kolod/padauk-programmer/software/firmware/platform/stm32f072/README.md

# Платформа STM32F072 (плати Easy PDK)

Ціль налагодження: прошивка для плат Easy PDK programmer на STM32F072C8T6. Розводку взято з
`easy-pdk-programmer-software/Firmware` (лише як референс). Рушій мікросхем тут — заглушка
(`platform/common/chip_engine_stub.c`): усі операції з мікросхемою відповідають `OP_UNSUPPORTED`.

## Піни

| Пін | Функція | Призначення | Примітка |
|---|---|---|---|
| PA4 | DAC_OUT1 | опорна напруга регулятора VPP | 0…4095 → 0…13,27 В |
| PA5 | DAC_OUT2 | опорна напруга регулятора VDD | 0…4095 → 0…6,26 В |
| PA2 | GPIO, вихід | увімкнення підвищувального перетворювача 15 В (для VPP) | 1 = увімкнено |
| PA3 | TIM15_CH2 (AF0) | ШІМ ≈ 45 кГц, 50 % → накачка −4,8 В для ОП | |
| PB0 | ADC_IN8 | вимір VPP через дільник /6 | плата Easy PDK / Lite |
| PB1 | ADC_IN9 | вимір VDD через дільник /6 | плата Easy PDK / Lite |
| PA0 | ADC_IN0 | вимір VPP через дільник /6 | лише варіант mini pill |
| PA1 | ADC_IN1 | вимір VDD через дільник /6 | лише варіант mini pill |
| PB8 | GPIO, вхід з підтяжкою | визначення варіанта плати | на землі → Lite |
| PB9 | GPIO, вхід з підтяжкою | визначення варіанта плати | на землі → mini pill |
| PB3 | — | лінія мікросхеми PA3 / CLK | поки лише Hi-Z |
| PB4 | — | лінія мікросхеми PA4 | поки лише Hi-Z |
| PB5 | — | лінія мікросхеми PA6 / DAT | поки лише Hi-Z |
| PB6 | — | лінія мікросхеми PA0 (UART TX мікросхеми) | поки лише Hi-Z |
| PB7 | — | лінія мікросхеми PA7 (UART RX мікросхеми) | поки лише Hi-Z |
| PC13 | GPIO, вихід | LED1 | активний нуль |
| PC14 | GPIO, вихід | LED2 | активний нуль |
| PC15 | GPIO, вихід | LED3 | активний нуль |
| PA15 | GPIO, вхід з підтяжкою до землі | кнопка → локальний запис (`PROGRAM`) | натиснута = 1 |
| PA11 / PA12 | USB DM / DP | USB CDC, VID/PID `1209:0001` | |
| PA13 / PA14 | SWDIO / SWCLK | налагодження | |
| PF0 / PF1 | OSC_IN / OSC_OUT | кварц 8 МГц | без кварцу — HSI |

Внутрішні ресурси: VREFINT (ADC_IN17) для обчислення VDDA, датчик температури (ADC_IN16) і VREFINT —
джерело ентропії, CRC — апаратний блок, TIM2 — мікросекундний таймер, SysTick — мілісекунди.

Після скидання першим кроком (`Reset_Handler`, ще до ініціалізації RAM) ЦАП виставляється в 0 В,
а лінії мікросхеми PB3…PB7 стають входами.

## Індикація

| Стан | LED1 | LED2 | LED3 |
|---|---|---|---|
| готовий (`READY`) | ● | | |
| операція (`BUSY`) | | ● | |
| успіх (`SUCCESS`) | ● | ● | |
| помилка (`FAIL`) | | | ● |
| локальний запуск заблоковано (`BLOCKED`) | ● | | ● |

Тимчасове відображення; остаточна індикація — задача T102.

## Тактування

SYSCLK 48 МГц: HSE 8 МГц × 6 (або HSI / 2 × 12, якщо кварц не запустився). USB — від HSI48 з
підстроюванням CRS за кадрами SOF. АЦП — від HSI14.

## Пам'ять

| Адреса | Розмір | Вміст |
|---|---|---|
| `0x08000000` | 44 КБ | прошивка |
| `0x0800B000` | 8 КБ | слот пакета 0 |
| `0x0800D000` | 8 КБ | слот пакета 1 |
| `0x0800F000` | 2 КБ | журнал стану, сторінка A |
| `0x0800F800` | 2 КБ | журнал стану, сторінка B |

Сторінка flash — 2 КБ, запис півсловами (одиниця запису 2 байти). Стирання синхронне: воно
виконується у фоні між командами, але на час стирання сторінки (≈ 20–40 мс) процесор зупиняється.

## Збірка

```
cmake -B build/f072 -G Ninja -DPLATFORM=stm32f072 \
      -DCMAKE_TOOLCHAIN_FILE=<абсолютний шлях>/software/firmware/cmake/arm-none-eabi.cmake software/firmware
cmake --build build/f072
```

Результат — `build/f072/pdkprog.elf` і `pdkprog.bin`.
