kolod/padauk-programmer/specs/001-pc-programmer-protocol/contracts/chip-engine.md

# Contract: внутрішні інтерфейси ядро ⇄ рушій мікросхем ⇄ живлення

Внутрішній (не мережевий) контракт між платформонезалежним ядром прошивки, рушієм мікросхем
(реалізація для PADAUK — фіча `002-chip-engine`; у цій фічі — модель для симулятора й заглушка для F072)
і апаратною частиною живлення. Фіксує гарантії принципу III конституції й FR-040.

## 1. `hal_power.h` — апаратне живлення (реалізує платформа)

| Функція | Опис |
|---|---|
| `power_set(rail, mV)` | задати VDD або VPP; `0` — вимкнути з активним розрядом |
| `power_measure(rail) → mV` | виміряна напруга шини (усереднення — відповідальність платформи) |
| `power_off_all()` | негайно VDD = VPP = 0, розряд увімкнено; безпечна з будь-якого контексту, включно з обробником помилки |
| `power_limits() → {vdd_max_mV, vpp_max_mV}` | апаратні межі джерел |

Платформа MUST мати апаратне обмеження максимальної напруги, незалежне від прошивки (конституція, III).

## 2. `core/power` — політика встановлення (реалізує ядро)

`power_apply(rail, mV, min_pause_us) → OK | VDD_FAULT | VPP_FAULT` — правило з
[protocol.md §6.1](protocol.md): мінімальна пауза **і** 3 послідовні виміри в межах ±2 % / ±30 мВ, тайм-аут
20 мс; при невдачі сам викликає `power_off_all()` і заповнює `{rail, set_mV, meas_mV}` для `RESULT`.

Рушій MUST змінювати напруги **лише** через `power_apply` (ніколи напряму через `hal_power`).

## 3. `chip_engine.h` — рушій мікросхем

| Примітив | Опис |
|---|---|
| `probe(&id, &family)` | визначення мікросхеми на низьких напругах (VPP 4.5 В, VDD 2.0 В) |
| `read(chip, addr, count, sink)` | читання слів у приймач (слот flash / суми / порівняння) |
| `erase(chip)` | стирання FLASH |
| `blank_check(chip, range, excl)` | перевірка чистоти |
| `write_block(chip, addr, words)` | запис одного блоку (розмір блоку — з таблиці) |
| `calibrate(chip, site, target_hz, mV) → {value, measured_hz}` | калібрування з вимірювальним циклом; перевіряє, що активна саме ця вставка (FR-055) → інакше `CALIB_WRONG_SITE` |
| `measure_freq(chip, site, start_value, mV) → hz` | вимір частоти без імпульсів на PA4 (R9, `MEASURE_MASTER`) |
| `run_start(vdd_mV)` / `run_stop()` | режим виконання з UART-мостом |
| `safe_state()` | VDD = VPP = 0 через `power_off_all()`, лінії IC — Hi-Z |

Гарантії (перевіряються модульними тестами на фейковому `hal_power` і моделлю мікросхеми):

1. **ID до HV**: будь-який примітив, що подає напруги запису/стирання, спершу перевіряє ID мікросхеми
   (FR-020); невідповідність → `CHIP_ID_MISMATCH` без подачі HV.
2. **Напруги підтверджено**: жоден біт не передається мікросхемі, поки остання зміна напруги не пройшла
   `power_apply` (FR-040, SC-011).
3. **Безпечний вихід**: кожен примітив на будь-якому шляху виходу (успіх, помилка, скасування через
   `poll`) лишає мікросхему в `safe_state()`, якщо наступний крок операції явно не продовжує сесію.
4. **Атомарні кроки < 100 мс**: між викликами `poll()` минає не більше 100 мс (найдовший крок —
   імпульс стирання FLASH_2, 40 мс; встановлення напруги — до 20 мс), щоб виконувалась FR-024.
5. **Скасування**: `poll()` повертає «скасувати» → примітив завершується з `CANCELLED` після
   `safe_state()`; виняток — етапи `MEASURE`/`RESTORE` операції `COPY` (data-model `CopyJob`).
6. **Та сама вставка** (FR-055, `docs/padauk-calibration.md` §8): `calibrate` до першого імпульсу «+1»
   міряє частоту й порівнює з очікуваною для типу вставки (`target_hz / 7` на PA3; допуск 1/4…4); під час
   підбору стежить, що частота монотонно змінюється з кроком; для BG перевіряє, що PA0 ведеться
   мікросхемою (перемикаючи слабку підтяжку вгору/вниз, рівень не має за нею йти). Порушення →
   `CALIB_WRONG_SITE` без жодного імпульсу далі й без запису.

## 4. Платформа органів керування (локальний запуск)

Ядро отримує від платформи лише події `local_start(request)` і `local_cancel()` і повідомляє стан
індикації `ui_state(state, detail)`; відображення на кнопки, перемикачі, дисплей і сигнали конвеєра —
окрема фіча (research R16). Набір фіксований (FR-054):

| `request` | Операція | Примітка |
|---|---|---|
| `PROGRAM` | `PROGRAM` активного пакета | пріоритети R16 можуть замінити на `SELF_TEST` / `RESTORE_MASTER` |
| `COPY` | `COPY` з режимами `cfg_copy_*` | те саме |
| `VERIFY` | `VERIFY` підключеної мікросхеми проти активного пакета | |
| `SELF_TEST` | `SELF_TEST` | явний запит оператора |
| `RESTORE_MASTER` | `RESTORE_MASTER` | лише при `MASTER_RESTORE_PENDING`, інакше ігнорується |
| `local_cancel()` | `OP_CANCEL` поточної локальної операції | як з PC; для `COPY` у `MEASURE` — спершу відновлення |

`ui_state.state`: `READY`, `BUSY` (`detail` = етап і відсоток), `SUCCESS`, `FAIL` (`detail` = клас:
`STORAGE`, `NO_PACKAGE`, `CHIP`, `CALIB`, `POWER_SELFTEST`, `MASTER_PENDING` + код статусу), `BLOCKED`
(локальний запис замінюється самоперевіркою). Еталонна плата F072 у цій фічі: одна кнопка →
`local_start(PROGRAM)`, три LED — спрощене відображення станів.
