kolod/padauk-programmer/hardware/README.md

# Апаратна частина

Схема й плата аналогової частини програматора для WeAct STM32G474CoreBoard (DipTrace):
`stm32g474-board.dchxml` — схема, `stm32g474-board.dipxml` — плата. Призначення пінів МК, шини
+15 В / −2,5 В і роз'єм ICP описано в `software/firmware/platform/stm32g474/README.md`.

## Конденсатори

| Поз. | Номінал | Корпус | Мережа | Робоча напруга | Номінальна напруга | Діелектрик | Примітка |
|---|---|---|---|---|---|---|---|
| C1 | 100 нФ | 0805 | +15 В ↔ −2,5 В (блокування U1) | до 18,5 В | 50 В | X7R | Стоїть між двома шинами, а не на землю; 25 В — мінімум. Впритул до виводів 8 і 4 U1 |
| C2 | 2 × 4,7 мкФ | 0805 | +15 В, вихід бустера | 15 В (до ~17 В під D3) | 50 В (мін. 35 В) | X7R | Під 15 В кожен зберігає ~1,5–2 мкФ, разом ~3–4 мкФ — досить для навантаження в десятки мА (пульсація ≈ 40 мА · 0,67 / (200 кГц · 3 мкФ) ≈ 45 мВ; при іншій частоті ШІМ — перерахувати). Конденсатори на 16–25 В не годяться. Малий ESR: імпульсний струм діода D1; коротка петля D1 → C2 → витік Q1 |
| C11 | 2 × 4,7 мкФ | 0805 | +5 В, вхід дроселя L1 | 5 В | 50 В (досить 16 В) | X7R | 50 В — щоб була одна позиція з C2 і C5. Пульсуючий струм дроселя; біля L1, коротка петля до витоку Q1 |
| C3 | 1 мкФ | 0805 | PB4 → D2, «літаючий» конденсатор накачки −2,5 В | ≤ 3,3 В | 16 В | X7R | Низький ESR |
| C5 | 4,7 мкФ | 0805 | −2,5 В, накопичувальний | ~2,7 В | 50 В (досить 10 В) | X7R | Неполярний — від'ємна шина не має значення |
| C4 | 100 нФ | 0805 | −2,5 В, ВЧ-блокування | ~2,7 В | 16–50 В | X7R | Біля виводу 4 U1 |
| C6 | 100 нФ | 0805 | ADC_Vdd (PA0), фільтр дільника | ≤ 1,1 В | 16–50 В | X7R | τ = (100k ∥ 20k) · 100 нФ ≈ 1,7 мс |
| C7 | 100 нФ | 0805 | ADC_Vpp (PA1), фільтр дільника | ≤ 2,3 В | 16–50 В | X7R | τ ≈ 1,7 мс |
| C8 | 1 нФ | 0805 | COMP_OVP (PB1), дільник OVP | ≤ 1,2 В | 50 В | C0G/NP0 | τ = (130k ∥ 10k) · 1 нФ ≈ 9 мкс — фільтрує завади, не гальмує OVP |
| C9 | 10 нФ | 0805 | DAC_Vdd (PA5) → вхід U1 | ≤ 3,3 В | 50 В | C0G/NP0 | Див. «Виходи ЦАП» |
| C10 | 10 нФ | 0805 | DAC_Vpp (PA4) → вхід U1 | ≤ 3,3 В | 50 В | C0G/NP0 | Див. «Виходи ЦАП» |

### Зведення для закупівлі

Ті самі конденсатори, згруповані по номіналах. Напругу підвищено там, де це прибирає зайву
номенклатуру (C4/C6/C7 — 50 В як C1; C5, C11 — 50 В як C2), а C2 і C11 зібрано з двох 4,7 мкФ 0805
замість 10 мкФ 1206: 5 позицій на 13 конденсаторів. На схемі C2 і C11 треба розділити на два
конденсатори кожен (додати дві нові позиції).

| Номінал | Корпус | Напруга | Діелектрик | Кількість | Позиції |
|---|---|---|---|---|---|
| 1 нФ | 0805 | 50 В | C0G/NP0 | 1 | C8 |
| 10 нФ | 0805 | 50 В | C0G/NP0 | 2 | C9, C10 |
| 100 нФ | 0805 | 50 В | X7R | 4 | C1, C4, C6, C7 |
| 1 мкФ | 0805 | 25 В | X7R | 1 | C3 |
| 4,7 мкФ | 0805 | 50 В | X7R | 5 | C2 (2 шт), C11 (2 шт), C5 |

Приклад для 4,7 мкФ: CERCAP 4.7/50V 0805 KX7R (X7R, ±10 %).

Загальне правило: 0805 X7R, малі ємності (1–10 нФ) — C0G; номінальна напруга кераміки — не
менше ніж удвічі вища за робочу (для C1, C2 — 50 В), бо ємність X7R/X5R падає під постійною
напругою.

C8, C9 і C10 стоять у колах опорної напруги й порогу, тому C0G: ємність не залежить від напруги й
температури, немає п'єзоефекту й діелектричної абсорбції. У номіналах 1–10 нФ 0805 / 50 В C0G
коштує як X7R. Для C6, C7 тип некритичний: напруга постійна, точність задає калібрування.

### Виходи ЦАП

ЦАП працює без буфера, його вихідний опір ≈ 15 кОм:

- з C9/C10 10 нФ τ ≈ 150 мкс, встановлення до 0,1 % — ≈ 1 мс; після зміни коду ЦАП прошивка має
  чекати ~1–2 мс перед виміром;
- R1/R6 (240k на землю) разом із 15 кОм ЦАП утворюють дільник (≈ −6 % напруги) — цю похибку
  прибирає калібрування живлення.

### Виходи Vdd / Vpp

На виходах після R17/R18 конденсаторів немає. За потреби можна поставити до 100 нФ X7R / 50 В на
J1.1 і J1.5 біля роз'єму: R17/R18 (20 Ом) розв'язують ємність від виходу ОП, тож генерації не буде.
Плата за це — фронт VPP τ = 20 Ом · 100 нФ = 2 мкс і більший кидок струму при ввімкненні; більше
~100 нФ не ставити.
