kolod/padauk-programmer/docs/README.md

# Документація

| Файл | Опис |
|---|---|
| [easy-pdk-programmer-protocol.md](easy-pdk-programmer-protocol.md) | Аналіз протоколів Easy PDK Programmer: PC ⇄ програматор ⇄ мікросхема |

## Даташити PADAUK

Даташити є власністю PADAUK Technology і в репозиторій не додаються (`docs/*.pdf` у `.gitignore`).
Завантажте їх із сайту виробника <http://www.padauk.com.tw/en/> і покладіть у цей каталог:

- `PFS154 datasheet_EN_V107_20240912.pdf`
- `PFC154 datasheet_EN_V004_20240905.pdf`
- `PADAUK_Package Information_V015.pdf`
