kolod/padauk-programmer/software/firmware/platform/stm32g474/README.md

# Платформа STM32G474 (WeAct STM32G474 core board)

Прошивка для плати [WeAct Studio STM32G474 core board](https://github.com/WeActStudio/WeActStudio.STM32G474CoreBoard)
з STM32G474CEU6 (512 КБ flash, 128 КБ RAM), без зовнішньої flash. Розводку плати взято з прикладів
WeAct. Рушій мікросхем тут — заглушка (`platform/common/chip_engine_stub.c`): усі операції з
мікросхемою відповідають `OP_UNSUPPORTED`.

Аналогової частини VDD/VPP ще немає. Тому драйвер живлення вмикається лише опцією збірки
`-DPDK_G474_SUPPLIES=ON` (типово `OFF`). Без неї програматор повідомляє межі напруг 0 В, не виставляє
`MEASURE_POWER` в `INFO`, і будь-яка ненульова напруга завершується `VDD_FAULT`/`VPP_FAULT`.

## Піни

| Пін | Функція | Призначення | Примітка |
|---|---|---|---|
| PA4 | DAC1_OUT1 | опорна напруга регулятора VPP | лише з `PDK_G474_SUPPLIES`; 0…4095 → 0…13,27 В |
| PA5 | DAC1_OUT2 | опорна напруга регулятора VDD | лише з `PDK_G474_SUPPLIES`; 0…4095 → 0…6,26 В |
| PA0 | ADC1_IN1 | вимір VDD через дільник /6 | лише з `PDK_G474_SUPPLIES` |
| PA1 | ADC1_IN2 | вимір VPP через дільник /6 | лише з `PDK_G474_SUPPLIES` |
| PA8 | TIM1_CH1 (AF6) | затвор ключа підвищувального перетворювача +15 В | лише з `PDK_G474_SUPPLIES`; 400 кГц, ≤ 75 % |
| PB0 | COMP4_INP0 | +15 В через дільник /6 — регулювання | лише з `PDK_G474_SUPPLIES` |
| PB1 | COMP1_INP1 | +15 В через окремий дільник /14 — захист від перенапруги | лише з `PDK_G474_SUPPLIES` |
| PB4 | TIM16_CH1 (AF1) | ШІМ 100 кГц, 50 % → діодна накачка −2,5 В | лише з `PDK_G474_SUPPLIES`; низька швидкість виходу |
| PC6 | GPIO, вихід | LED | активна одиниця |
| PC13 | GPIO, вхід з підтяжкою до землі | кнопка KEY → локальний запис (`PROGRAM`) | натиснута = 1 |
| PA11 / PA12 | USB DM / DP | USB CDC, VID/PID `1209:0001` | |
| PA13 / PA14 | SWDIO / SWCLK | налагодження | |
| PF0 / PF1 | OSC_IN / OSC_OUT | кварц 8 МГц | без кварцу — HSI16 |
| PB6 | — | вільний | прошивка знімає з PB4/PB6 підтяжки UCPD dead battery |

Піни живлення умовні: їх треба підтвердити або змінити, коли буде схема аналогової частини.
Масштаби (повна шкала ЦАП 6,26 В / 13,27 В після регуляторів, дільники /6) взято як на Easy PDK.
Лінії до мікросхеми PADAUK ще не призначено.

## Шини +15 В і −2,5 В

Шини для вихідного каскаду (ОП, що формує VDD і VPP) робляться без спеціалізованих мікросхем.

**+15 В — підвищувальний перетворювач від USB 5 В.** Ключ (N-MOSFET із логічним рівнем затвора,
наприклад AO3400 або SI2302), дросель 33–47 мкГн із струмом насичення ≥ 0,5 А, діод Шотткі (SS14),
конденсатор 10–22 мкФ / 25 В. Розрахунковий струм — до ~25 мА (VDD мікросхеми під час запису до
20 мА, VPP, дільники, ОП), закладено 30–50 мА.

- Регулювання апаратне, гістерезисне: COMP4 порівнює вихід (PB0, /6) з порогом від внутрішнього
  DAC3_CH2 і, поки вихід вищий, гасить імпульси TIM1_CH1 через OCREF_CLR. Прошивка лише задає поріг
  (плавний пуск за 20 мс) і перевіряє, що шина піднялась за 50 мс.
- Захист від перенапруги: COMP1 порівнює окремий дільник (PB1, /14, наприклад 130 кОм / 10 кОм) з
  VREFINT (1,21 В) — поріг ≈ 17 В. Спрацювання вимикає ШІМ через аварійний вхід TIM1 апаратно,
  без участі програми, і ШІМ не вмикається до скидання. Конфігурацію COMP1 заблоковано бітом LOCK.
- Якщо шина не піднялась або спрацював захист, драйвер тримає ЦАП VDD/VPP на 0 В, а `INFO` не
  виставляє `MEASURE_POWER`.
- Обов'язково на платі: резистор 10 кОм із затвора на землю (ключ закритий після скидання й поки
  PA8 у Hi-Z) і стабілітрон або TVS на 16–18 В на шині +15 В (пасивне обмеження, якщо зупиниться
  весь МК або обірветься дільник).

**Коло затвора.** Між PA8 і затвором — послідовний резистор 22–47 Ом (наприклад, 33 Ом), фізично біля
ключа. Він гасить дзвін, який ємність затвора (~0,6–1 нФ у AO3400) утворює з індуктивністю доріжки,
зрізає короткий пік струму піна при перезаряді затвора і зменшує завади, зокрема на АЦП. Перемикання
при цьому триває ~30–50 нс; при 400 кГц (період 2,5 мкс) втрати на перемикання ≈ 0,05–0,1 Вт при
струмі дроселя ~0,3 А. Прошивка виставляє PA8 середню швидкість виходу (medium), тож фронти задає
саме цей резистор, а не пін. Якщо ключ гріється, частоту можна знизити до 200–300 кГц (`BOOST_PWM_HZ` у
`hal_g474_power.c`), але тоді потрібен дросель більшої індуктивності.

Резистор 10 кОм на землю ставиться безпосередньо між затвором і витоком ключа, тобто після
послідовного резистора: тоді ключ закритий навіть при обриві послідовного резистора.

```
PA8 ──[33 Ом]──┬── затвор ключа
               │
            [10 кОм]
               │
GND ───────────┴── витік ключа
```

**−2,5 В — діодна накачка.** ШІМ із PB4 через конденсатор і два діоди Шотткі (BAT54S або RB521),
конденсатори 1–10 мкФ. Напруга ≈ −(3,3 В − 2·Uпр), струм кілька міліампер — досить для власного
споживання ОП (~1 мА) і коротких імпульсів розряду виходу.

Пін накачки винесено на протилежний від аналогових пінів бік корпусу. У UFQFPN48 PA0…PB2 (піни 8–19),
VREF+ і VDDA (20, 21) стоять поруч: ШІМ на будь-якому з них (наприклад, PA6 — пін 14, сусід PA5 з
опорою VDD) потрапляв би через ємність між пінами й доріжками на опори VDD/VPP (а вихідний каскад
ще й підсилює їх), на входи компараторів +15 В і на VDDA. PB4 — пін 42; низька швидкість виходу
додатково згладжує фронти. На платі варто також поставити RC-фільтри на виходах ЦАП перед ОП,
окремий фільтр (ферит або LC) на VDDA і вести доріжки накачки й підвищувального перетворювача
подалі від аналогових, з окремим поверненням на землю.

Після скидання (і в обробнику збою) прошивка першим кроком переводить PA8 у низький рівень, зупиняє
TIM1 і ставить ЦАП VDD/VPP на 0 В.

Внутрішні ресурси: VREFINT (ADC1_IN18, калібрування при VDDA = 3,0 В) для обчислення VDDA,
апаратний генератор випадкових чисел — джерело серійних номерів, CRC — апаратний блок, TIM2 —
мікросекундний таймер, SysTick — мілісекунди.

## Індикація

Один LED, стан показується режимом блимання:

| Стан | LED |
|---|---|
| готовий (`READY`) | світиться постійно |
| операція (`BUSY`) | 4 Гц |
| успіх (`SUCCESS`) | 1 Гц |
| помилка (`FAIL`) | 10 Гц |
| локальний запуск заблоковано (`BLOCKED`) | не світиться |

Тимчасове відображення; остаточна індикація — задача T102.

## Тактування

SYSCLK 170 МГц (діапазон 1, режим boost): HSE 8 МГц / 2 × 85 / 2 (або HSI16 / 4 × 85 / 2, якщо кварц не
запустився). APB1 і APB2 — 170 МГц. USB і RNG — від HSI48 з підстроюванням CRS за кадрами SOF.
АЦП — HCLK / 4.

## Пам'ять

| Адреса | Розмір | Вміст |
|---|---|---|
| `0x08000000` | 256 КБ (банк 1) | прошивка |
| `0x08040000` | 4 × 16 КБ | слоти пакетів 0…3 (банк 2) |
| `0x08050000` | 1 сторінка | журнал стану, сторінка A |
| `0x08051000` | 1 сторінка | журнал стану, сторінка B |

Прошивка виконується з банку 1, а пакети й журнал лежать у банку 2. Тому стирання банку 2 не
зупиняє процесор, і фонове стирання справді асинхронне. Це працює в режимі двох банків
(`DBANK = 1`, заводське налаштування), сторінка 2 КБ; з `DBANK = 0` прошивка працює зі сторінками
4 КБ, але стирання зупиняє процесор.

Запис — подвійними словами по 8 байт, кожне пишеться один раз (ECC). Подвійна помилка ECC у слові,
недописаному через обрив живлення, викликає NMI: обробник скидає прапорець, а такий пакет відкидає
перевірка CRC.

## Збірка

```
cmake -B build/g474 -G Ninja -DPLATFORM=stm32g474 [-DPDK_G474_SUPPLIES=ON] \
      -DCMAKE_TOOLCHAIN_FILE=<абсолютний шлях>/software/firmware/cmake/arm-cortex-m4f.cmake software/firmware
cmake --build build/g474
```

Результат — `build/g474/pdkprog-g474.elf` і `pdkprog-g474.bin`.
