kolod/padauk-programmer/specs/001-pc-programmer-protocol/spec.md

# Feature Specification: Протокол обміну PC ⇄ програматор

**Feature Branch**: `001-pc-programmer-protocol`

**Created**: 2026-10-09

**Status**: Draft

**Input**: User description: "Протокол обміну PC ⇄ програматор (USB CDC). Треба визначити: які дані
передаються з PC на програматор (тип/ідентифікатор МК, образ прошивки, fuse, параметри калібрування,
серійний номер, опції операцій тощо), протокол обміну (команди, кадри), як програматор відповідає
(результати, коди помилок, прогрес довгих операцій) з урахуванням того, що всі знання про алгоритм
роботи з конкретним чипом тепер знаходяться у програматорі, а клієнт на PC тонкий. Дані повинні
передаватися без помилок: потрібен контроль цілісності кадрів, а також окремо — контроль цілісності
образу прошивки та метаданих (від PC до збереження у пам'яті програматора і при автономному записі)."

## Clarifications

### Session 2026-10-09

- Q: Скільки пакетів прошивки програматор зберігає одночасно? → A: Один активний пакет; друге місце
  лише для атомарної заміни (FR-016).
- Q: Чи підтримувати оригінальний протокол Easy PDK 1.3 для `easypdkprog`? → A: Ні. Можливий окремий
  CLI-клієнт, що імітує `easypdkprog`, але працює через новий протокол (FR-030).
- Q: Чи можна при копіюванні відновити індивідуальне калібрування копій, якщо ціль еталона невідома?
  → A: Так. Сліди калібрування в дампі замінюються калібрувальними вставками; ціль — виміряти на
  FLASH-еталоні (тимчасово перезаписавши його й потім відновивши), задати з PC, округлити до
  стандартної частоти або явно перенести значення еталона. BandGap відновлюється завжди (FR-031…FR-036).
- Q: Чи дозволяти запис OTP без перевірки чистоти (`--noblankchk`)? → A: Ні (принцип III). Для
  дописування окремих нулів у вже записану мікросхему — окрема операція дописування з перевіркою,
  що всі зміни лише обнуляють біти (FR-037, FR-038).
- Q: Як не дописати не ту мікросхему? → A: Дописування обов'язково перевіряє контрольну суму всієї
  користувацької пам'яті (точну або нормалізовану без калібрувань і серійних номерів) проти очікуваної:
  заданої клієнтом або обчисленої з активного пакета (FR-039).
- Q: Чи можна пропускати окремі калібрування й як поводитися з OTP? → A: Режими копіювання — окремо для
  IHRC/ILRC/BG (FR-042); при невдалому калібруванні нічого не записувати далі, сигнал
  неуспіху, з PC — опційне примусове завершення (FR-043); перекалібрування завершеної OTP не
  підтримується (FR-045).
- Q: Чи потрібні прапорці пропуску калібрування? → A: Ні. Калібрується кожна вставка, знайдена в
  прошивці; не потрібне калібрування — не ставити макрос. Для OTP кожне калібрування — це один повний
  запис (з вимірювальним циклом на місці вставки) і один перезапис самої вставки (FR-006).
- Q: Як поводитися з обривами? → A: Обрив USB не перериває операцію (дані завантажені до старту),
  крім запуску з обміном даними (FR-023); після обриву живлення — повторна спроба, якщо записане
  сумісне з образом (FR-044).
- Q: Що робити, якщо в еталоні замість сліду калібрування — вимірювальний цикл? → A: Локально — не
  копіювати, у сховище нічого не писати, сигнал неуспіху; з PC — запит користувачу: скасувати або задати
  ціль калібрування й повторити копіювання з дозволом (FR-051).
- Q: Як перевіряти мікросхему з каліброваними вставками й серійним номером? → A: Верифікація враховує
  вставки (FR-047); після калібрування й fuse — фінальна точна перевірка всієї пам'яті (FR-048); CRC пакета
  перевіряється й під час запису та перед fuse (FR-049); пакет без калібрувальних вставок дає попередження
  (FR-050).
- Q: Повторна спроба — у тій самій сесії? → A: Ні: пізніше або іншим програматором з тим самим пакетом.
  FLASH/MTP — запис наново; OTP — перевірка, чи можна дописати нулі; уже записаний серійний номер
  береться з мікросхеми (FR-044).
- Q: Як формувати серійні номери? → A: Випадкове 64-бітне число для всіх режимів (FR-046). Копіювання
  серійний номер не обробляє: локально — дублікат, з PC — пошук і заміна на користувачі (FR-052).
- Q: Калібрування чужого формату в еталоні? → A: Копіювати як є з попередженням (FR-053).
- Q: Як чекати встановлення VDD/VPP після зміни? → A: Не менше документованої паузи free-pdk **і** доки
  виміряна напруга в допуску й стабільна; тайм-аут → помилка напруги живлення/програмування (FR-040).
- Q: Допуск і тайм-аут встановлення напруги? → A: ±2 % або ±30 мВ (більше з двох), тайм-аут 20 мс (FR-040, SC-011).
- Q: Що робити, якщо під час самоперевірки в панельці мікросхема? → A: Спершу визначення мікросхеми на
  низьких напругах; якщо відповіла — відмова з окремим кодом; клієнт додатково просить підтвердити
  порожню панельку (FR-041).
- Q: Коли запускається самоперевірка? → A: Автоматично при кожному увімкненні та за командою з PC;
  при невдачі автономний запис блокується (FR-041).
- Q: Що, якщо при увімкненні мікросхема вже підключена? → A: Блокувати автономний запис, доки
  самоперевірка не пройде; локальний запуск у цьому стані повторює самоперевірку. Типовий сценарій — програмування
  в схемі через pogo-контакти: програматор увімкнено й перевірено, потім оператор або автомат на
  конвеєрі притискає його до плати й запускає запис (FR-041).
- Q: Які органи керування має автономний режим? → A: Поки не визначено; кількість кнопок і перемикачів
  не обмежується оригіналом. Протокол MUST NOT залежати від конкретних органів керування: автономні дії
  описуються як «локальний запуск» певної операції (`source` = локальний), а відображення дій на кнопки,
  перемикачі чи сигнали конвеєра визначається окремою фічею.
- Q: Що з локальних функцій реалізується зараз, якщо інтерфейс визначиться пізніше? → A: Ядро реалізує
  повний набір локальних дій і станів індикації (FR-054); будь-який майбутній інтерфейс лише відображає
  їх на свої органи керування. На еталонній платі тимчасово — одна кнопка → запис.

## User Scenarios & Testing *(mandatory)*

### User Story 1 - Завантаження пакета прошивки в програматор (Priority: P1)

Розробник вибирає у клієнті на PC файл прошивки, тип мікросхеми, fuse та опції і завантажує все це
в програматор одним «пакетом прошивки». Програматор перевіряє, що пакет дійшов без пошкоджень і
сумісний із вибраною мікросхемою, зберігає його в енергонезалежній пам'яті й підтверджує
збереження. Клієнт порівнює підтверджену програматором контрольну суму зі своєю і показує
користувачу, що в програматорі саме той образ, який він обрав.

**Why this priority**: без надійно завантаженого пакета неможливі ані запис із PC, ані автономна
робота — це фундамент усіх інших сценаріїв.

**Independent Test**: завантажити пакет, від'єднати програматор, підключити знову, прочитати
метадані й контрольну суму збереженого пакета — вони мають збігтися з тими, що обчислив клієнт.

**Acceptance Scenarios**:

1. **Given** програматор підключений і в ньому немає пакета, **When** клієнт завантажує коректний
   пакет для PFS154, **Then** програматор зберігає його і повертає підтвердження з контрольною
   сумою, що збігається з обчисленою клієнтом.
2. **Given** під час передачі частина даних пошкоджена, **When** програматор отримує пошкоджений
   фрагмент, **Then** він відхиляє цей фрагмент, клієнт передає його повторно, і зрештою пакет
   зберігається без помилок.
3. **Given** пакет призначений для мікросхеми, яку програматор не підтримує, або образ більший за
   пам'ять мікросхеми, **When** клієнт завершує передачу, **Then** програматор відхиляє пакет із
   конкретним кодом помилки, а раніше збережений пакет лишається незмінним.
4. **Given** зв'язок обірвався посеред передачі нового пакета, **When** програматор знову
   підключено, **Then** у пам'яті лишився попередній цілісний пакет (або порожньо, якщо його не
   було), а не частково записаний новий.

---

### User Story 2 - Запис мікросхеми з PC з прогресом і результатом (Priority: P1)

Користувач вставляє мікросхему й натискає «Записати» в клієнті. Клієнт лише запускає операцію;
програматор сам визначає й виконує всі кроки для цієї мікросхеми: перевірку ID, стирання (для
FLASH), перевірку на чистоту, запис, верифікацію, калібрування, серійний номер, fuse. Під час
роботи клієнт показує поточний етап і відсоток виконання, а наприкінці — підсумок: успіх або
конкретна причина невдачі, адресу розбіжності, результати калібрування, записаний серійний номер.

**Why this priority**: головний сценарій використання, і на ньому перевіряється, що вся логіка
роботи з мікросхемою справді живе в програматорі.

**Independent Test**: записати PFS154 із клієнта, у якого немає жодних даних про мікросхеми, і
переконатися, що мікросхема працює, а клієнт показав усі етапи й підсумок.

**Acceptance Scenarios**:

1. **Given** у програматорі збережено пакет і вставлено чисту мікросхему потрібного типу,
   **When** клієнт запускає запис, **Then** програматор надсилає події прогресу з назвою етапу й
   відсотком і завершує підсумком «успіх» з результатами калібрування та серійним номером.
2. **Given** вставлено мікросхему іншого типу, **When** запускається запис, **Then** операція
   зупиняється до подачі програмувальних напруг із кодом «невідповідність ID» і фактичним ID.
3. **Given** OTP-мікросхема вже записана, **When** запускається запис, **Then** операція
   зупиняється на етапі перевірки чистоти з відповідним кодом, мікросхема не змінюється.
4. **Given** триває запис, **When** клієнт надсилає «скасувати», **Then** програматор безпечно
   завершує операцію (знімає напруги) і повідомляє, що операцію скасовано, та на якому етапі.
5. **Given** триває операція, **When** клієнт надсилає іншу команду, що потребує мікросхеми,
   **Then** програматор відповідає «зайнято», не перериваючи поточну операцію.
6. **Given** вставлено записану OTP-мікросхему, **When** клієнт дописує слова, що лише обнуляють
   біти, **Then** програматор записує й верифікує тільки ці слова; **When** хоча б одне слово
   потребує 0→1, **Then** нічого не записується, а підсумок вказує адресу конфлікту.
7. **Given** клієнт передав очікувану контрольну суму прошивки, а в панельці мікросхема з іншою
   програмою, **When** запускається дописування, **Then** програматор нічого не записує й повертає
   фактичні контрольні суми мікросхеми.
8. **Given** триває запис, **When** USB-з'єднання обривається (програматор живиться далі), **Then**
   запис завершується так само, як без обриву, а після повторного підключення клієнт отримує підсумок.
9. **Given** запис OTP-мікросхеми перервано вимкненням живлення, **When** ту саму мікросхему записують
   повторно тим самим пакетом, **Then** програматор перевіряє сумісність записаного з образом, дописує
   решту й завершує калібрування; підсумок позначає повторну спробу.
10. **Given** калібрування не вдалося, **When** запис завершується, **Then** програматор повідомляє
    невдачу з найкращим знайденим значенням і нічого не записує після вимірювального циклу; після
    усунення причини повторний запис тієї самої мікросхеми завершує калібрування.

---

### User Story 3 - Автономний запис з перевіркою цілісності збереженого пакета (Priority: P2)

Оператор без PC підключає мікросхему й запускає запис локально (органом керування програматора або сигналом автомата). Перед кожним записом програматор
перевіряє цілісність збереженого пакета та метаданих; пошкоджений пакет ніколи не записується в
мікросхему. Якщо прошивка має вставку серійного номера, кожна мікросхема отримує власний випадковий
64-бітний номер. Коли PC підключено пізніше, клієнт може прочитати статистику автономної роботи.

**Why this priority**: автономність — ключова відмінність продукту, але вона спирається на
P1 (наявність цілісного пакета).

**Independent Test**: навмисно пошкодити збережений пакет (тестовою командою або тестовою
прошивкою), виконати локальний запуск — запис не має початися, індикатор має показати помилку цілісності.

**Acceptance Scenarios**:

1. **Given** збережено цілісний пакет із вставкою серійного номера, **When** оператор записує три
   мікросхеми поспіль (з вимкненням живлення між ними), **Then** вони отримують три різні випадкові
   серійні номери.
2. **Given** збережений пакет пошкоджено, **When** оператор виконує локальний запуск, **Then** запис не
   починається, напруги не подаються, і локальна індикація показує помилку цілісності.
3. **Given** після автономної роботи PC знову підключено, **When** клієнт запитує статистику,
   **Then** він отримує кількість успішних і невдалих записів.

---

### User Story 4 - Інформація про програматор і підтримувані мікросхеми (Priority: P2)

Клієнт при підключенні дізнається в програматора версію протоколу й прошивки, апаратні
можливості, перелік підтримуваних мікросхем (назва, ID, обсяг пам'яті, тип — FLASH/OTP, які
операції доступні) та стан збереженого пакета. Так клієнт може показати користувачу список мікросхем
і перевірити розмір образу, не маючи власної таблиці.

**Why this priority**: потрібно, щоб клієнт лишався тонким; без цього він мусив би дублювати таблицю
мікросхем.

**Independent Test**: оновити прошивку програматора з новою мікросхемою в таблиці — клієнт без змін
показує її у списку й може з нею працювати.

**Acceptance Scenarios**:

1. **Given** клієнт і програматор мають сумісні версії протоколу, **When** клієнт підключається,
   **Then** він отримує версії, можливості, список мікросхем і опис збереженого пакета.
2. **Given** мажорні версії протоколу несумісні, **When** клієнт підключається, **Then** обидві
   сторони повідомляють про несумісність і жодних операцій із мікросхемою не виконують, крім
   отримання версії.
3. **Given** панелька порожня, **When** користувач запускає самоперевірку, **Then** клієнт показує для
   кожного рівня VDD і VPP задану й виміряну напругу, час встановлення та загальний результат.
4. **Given** у панельці мікросхема, **When** запускається самоперевірка, **Then** програматор
   відмовляє після визначення мікросхеми на низьких напругах, не подаючи вищих.

---

### User Story 5 - Читання та копіювання мікросхеми (Priority: P3)

Користувач читає незахищену мікросхему: або в клієнт (щоб зберегти файл), або одразу в пам'ять
програматора як новий пакет (копіювання). Отриманий образ має контрольну суму, яку клієнт
перевіряє, а скопійований пакет зберігається з тими самими гарантіями цілісності, що й завантажений
з PC.

Еталон уже відкалібровано: замість калібрувальних вставок у ньому лише записане значення регістра
підстроювання, яке підходить тільки цьому екземпляру. Тому при копіюванні програматор розпізнає ці
«сліди» калібрування й відновлює в пакеті калібрувальні вставки, щоб кожна копія калібрувалася
індивідуально. Ціль калібрування визначається в одному з режимів: виміряти фактичну частоту
еталона (лише для перезаписуваного еталона і з явного дозволу тимчасово змінити його), взяти ціль,
задану користувачем, округлити до стандартної частоти або (явно) лише перенести значення еталона.

**Why this priority**: корисно для аналізу та копіювання, але не потрібно для базового запису.

**Independent Test**: прочитати записану мікросхему в клієнт і порівняти з вихідним файлом;
скопіювати мікросхему в програматор і записати нею іншу; для каліброваного FLASH-еталона в режимі
вимірювання частота копій має збігатися з частотою еталона.

**Acceptance Scenarios**:

1. **Given** вставлено незахищену мікросхему, **When** клієнт запитує читання, **Then** він
   отримує повний образ, fuse і контрольну суму, що збігається з обчисленою на прийнятих даних.
2. **Given** вставлено мікросхему зі встановленим захистом від читання, **When** запитується
   читання або копіювання, **Then** програматор повідомляє, що мікросхема захищена, і не створює
   пакет.
3. **Given** вставлено відкалібрований FLASH-еталон (наприклад, PFS154 з IHRC на 8 МГц) і користувач
   дозволив тимчасово змінювати еталон, **When** запускається копіювання в режимі вимірювання,
   **Then** програматор вимірює фактичну частоту еталона, відновлює еталон побітово ідентичним
   початковому (з верифікацією) і створює пакет, у якому калібрувальна вставка має виміряну ціль.
4. **Given** еталон — OTP-мікросхема, **When** запитується режим вимірювання, **Then** програматор
   відмовляє з поясненням, що еталон неперезаписуваний, і не змінює мікросхему.
5. **Given** користувач задав цільову частоту й напругу, **When** виконується копіювання,
   **Then** у пакеті відновлено вставки з цією ціллю, а калібрування BandGap відновлено з його
   фіксованою ціллю.
6. **Given** вимкнулося живлення після того, як еталон стерто для вимірювання, **When** програматор
   знову увімкнено, **Then** він повідомляє, що еталон не відновлено, і може відновити його з
   уже збереженого дампу (з PC або локальним запуском).

---

### User Story 6 - Запуск мікросхеми з обміном даними (Priority: P3)

Розробник запускає записану мікросхему в панельці з заданою напругою живлення й бачить у клієнті
дані, які мікросхема надсилає через послідовний порт, а також може надсилати їй дані.

**Why this priority**: зручно для налагодження, але не впливає на програмування.

**Independent Test**: запустити приклад «hello world» і побачити його вивід у клієнті.

**Acceptance Scenarios**:

1. **Given** у панельці записана мікросхема, **When** клієнт запускає її з напругою 5.0 В,
   **Then** програматор повідомляє визначену швидкість обміну й пересилає дані в обидва боки до
   команди зупинки.

---

### Edge Cases

- Кадр прийшов пошкодженим, неповним або продубльованим (після повтору) — пошкоджений
  відкидається з проханням повторити, дублікат розпізнається й не виконується вдруге.
- Клієнт не отримав відповіді (втрачена відповідь) — повторний запит з тим самим номером
  повертає збережену відповідь, а не виконує команду повторно.
- Зв'язок обривається посеред операції з мікросхемою — операція продовжується до кінця (усі дані вже в
  програматорі); при наступному підключенні клієнт отримує її результат. Виняток — запуск мікросхеми з
  обміном даними, який зупиняється.
- Живлення програматора зникає посеред запису (зокрема коли програматор живиться від USB і кабель
  висмикнуто) — після увімкнення повторний запис тієї самої мікросхеми можливий, якщо записане не
  суперечить образу (FR-044).
- Калібрування не вдалося — у мікросхему більше нічого не записується (вимірювальний цикл лишається,
  fuse не пишеться), сигналізується невдача; мікросхему можна відкалібрувати повторно пізніше (FR-043).
- В еталоні на місці калібрування — вимірювальний цикл — копіювання зупиняється до збереження пакета
  (FR-051).
- Калібрувальна вставка в образі є, але програма до неї не доходить (вимірювальний сигнал відсутній) —
  калібрування цієї вставки вважається невдалим (FR-043); при копіюванні в режимі вимірювання еталона —
  значення еталона з попередженням, інші вставки обробляються далі.
- Вимкнення живлення під час збереження пакета — попередній пакет лишається цілісним.
- Запит пропустити перевірку чистоти для OTP-мікросхеми — відхиляється; для дописування в уже
  записану OTP існує лише окрема операція дописування з перевіркою сумісності.
- Дописування потребує хоча б в одному слові переходу біта 0→1 — жодне слово не записується,
  мікросхема лишається без змін.
- Образ виходить за межі пам'яті мікросхеми або перекриває службові області (наприклад, заводські
  калібрувальні значення) — пакет відхиляється з поясненням.
- У пакеті задано fuse із захистом від читання без явного дозволу — пакет відхиляється.
- Обрив живлення або USB між стиранням еталона й його відновленням при вимірюванні калібрування —
  дамп еталона вже збережено, стан «еталон не відновлено» переживає вимкнення, відновлення
  доступне явною дією.
- У дампі еталона кілька калібрувань (наприклад, IHRC і ILRC) — кожне вимірюється окремо, еталон
  наприкінці відновлюється один раз.
- Виміряна частота еталона не близька до жодної стандартної в режимі округлення — пакет зберігає
  значення еталона, а підсумок містить попередження.
- Образ містить калібрувальну вставку невідомого формату — пакет відхиляється з поясненням.
- Калібрування не досягає частоти в межах допуску — операція завершується помилкою з
  виміряною частотою; мікросхема позначається як невдала.
- Клієнт надсилає невідому команду або команду новішої мінорної версії — програматор відповідає
  «не підтримується», не розриваючи сесію.
- Самоперевірку при увімкненні не пройдено (несправне джерело або підключена мікросхема) —
  автономний запис заблоковано, індикація показує причину, локальний запуск повторює самоперевірку.
- Локальний запуск виконано, коли підключено PC і триває сесія — програматор
  повідомляє клієнту і не запускає дві операції одночасно.

## Requirements *(mandatory)*

### Functional Requirements

**Сесія та сумісність**

- **FR-001**: Програматор MUST на запит повідомляти версію протоколу (мажорну й мінорну), версію
  прошивки, ідентифікатор апаратної платформи та перелік можливостей.
- **FR-002**: Сторони MUST відмовлятися від операцій із мікросхемою при несумісній мажорній версії
  протоколу; запит версії MUST працювати завжди.
- **FR-003**: Програматор MUST надавати перелік підтримуваних мікросхем із назвою (та
  варіантами назв), ідентифікатором, обсягом пам'яті програм, розрядністю слова, типом
  (FLASH/OTP), доступними операціями та службовими областями пам'яті, які не можна перезаписувати.

**Вміст пакета прошивки (дані від PC)**

- **FR-004**: Пакет прошивки MUST містити: ідентифікатор цільової мікросхеми; образ пам'яті
  програм із позначенням, які слова задані, а які ні; значення fuse або ознаку «fuse не
  записувати»; ознаку дозволу на захист від читання; опції операцій (пропустити стирання,
  перевірку чистоти — лише для FLASH, верифікацію; заповнювати незадіяну пам'ять); напругу живлення
  для режиму запуску;
  **ім'я пакета** (обов'язкове, коротке, для показу користувачу й вибору пакета), необов'язковий опис і
  контрольну суму вихідного файлу.
- **FR-005**: Пакет MUST NOT містити напруг, таймингів чи алгоритмів програмування — їх
  програматор визначає сам за ідентифікатором мікросхеми.
- **FR-006**: Параметри калібрування (тип осцилятора, цільова частота, напруга) MUST визначатися
  програматором зі вставок у самому образі. Калібрується **кожна** знайдена вставка; способу пропустити
  калібрування наявної вставки немає — щоб не калібрувати параметр, розробник не ставить для нього
  макрос (або завантажує заводське значення відповідним макросом).
- **FR-007**: Програматор MUST перевіряти пакет при отриманні: підтримуваність мікросхеми, розмір
  образу, неперекриття службових областей, допустимість fuse, розпізнаваність усіх калібрувальних
  вставок. Невідповідність MUST
  призводити до відхилення пакета з конкретним кодом і, де можливо, адресою.

**Передача та цілісність**

- **FR-008**: Кожен кадр в обох напрямах MUST мати явну довжину, порядковий номер і контроль
  цілісності, що виявляє будь-які помилки в одному кадрі довжиною до максимального розміру
  (гарантовано — усі одно-, дво- й трибітові помилки та пакети помилок довжиною до 32 біт; інші
  помилки — з імовірністю пропуску не більше 2⁻³²).
- **FR-009**: Пошкоджений або неповний кадр MUST відкидатися з повідомленням, що дозволяє клієнту
  повторити передачу; повторно отриманий кадр з тим самим номером MUST NOT виконуватися вдруге —
  програматор MUST повертати попередню відповідь.
- **FR-010**: Пакет прошивки MUST мати наскрізну контрольну суму, обчислену клієнтом над образом і
  всіма метаданими, незалежну від контролю кадрів. Програматор MUST перевіряти її після отримання
  всіх даних і до збереження.
- **FR-011**: Збереження нового пакета MUST бути атомарним: до успішної перевірки й запису
  попередній збережений пакет лишається чинним; незавершене збереження MUST NOT робити пакет
  пошкодженим чи частково новим.
- **FR-012**: Програматор MUST перевіряти цілісність збереженого пакета при увімкненні, перед
  кожним записом мікросхеми (з PC і автономним) та на запит клієнта; пошкоджений пакет MUST NOT
  використовуватися для запису.
- **FR-013**: Програматор MUST повертати контрольну суму збереженого пакета, щоб клієнт міг
  підтвердити, що збережено саме його пакет.
- **FR-014**: Образ, прочитаний з мікросхеми й переданий клієнту, MUST супроводжуватися
  контрольною сумою.

**Сховище**

- **FR-015**: Програматор MUST зберігати пакет прошивки й статистику (кількість успішних і невдалих
  записів) у енергонезалежній пам'яті.
- **FR-016**: Програматор MUST зберігати рівно один активний пакет прошивки. Додаткове місце в
  сховищі MAY використовуватися лише для атомарної заміни пакета (FR-011) і MUST NOT бути видимим
  клієнту як другий пакет. Завантаження або копіювання нового пакета замінює активний.
- **FR-017**: Клієнт MUST мати змогу прочитати опис збереженого пакета (метадані, контрольну суму,
  стан цілісності), прочитати сам образ і видалити пакет.

**Операції з мікросхемою**

- **FR-018**: Програматор MUST підтримувати операції: визначення мікросхеми, читання (у клієнт або
  в сховище як новий пакет), стирання (FLASH), перевірку чистоти, повний запис зі збереженого пакета,
  верифікацію, запуск мікросхеми з обміном даними та зупинку, відновлення еталона з дампу,
  дописування, самоперевірку програматора.
- **FR-019**: Операція «повний запис» MUST виконувати всі специфічні для мікросхеми кроки в
  програматорі (перевірка ID, стирання, чистота, запис, верифікація, калібрування, серійний номер,
  fuse) без участі клієнта між кроками.
- **FR-020**: Перед подачею програмувальних напруг програматор MUST перевіряти, що ID вставленої
  мікросхеми відповідає пакету.
- **FR-040**: Після кожної зміни VDD або VPP програматор MUST продовжувати роботу з мікросхемою
  лише тоді, коли минула щонайменше документована для цього етапу пауза (як у free-pdk: 100 мкс,
  500 мкс, 1 мс, 10 мс) **і** виміряна напруга відрізняється від заданої не більше ніж на ±2 % або
  ±30 мВ (більше з двох) протягом кількох послідовних вимірів. Якщо цього не досягнуто за 20 мс від
  зміни, операція MUST завершуватися безпечно з
  помилкою напруги живлення або програмування, а підсумок MUST містити задану й останню виміряну
  напругу.
- **FR-041**: Програматор MUST мати операцію **самоперевірки** без мікросхеми: послідовно задати
  VDD і VPP на кількох рівнях від 0 В до максимальних, що використовуються таблицею мікросхем,
  переконатися за FR-040, що кожен рівень досягнуто, і що після вимкнення напруга спадає до
  безпечного рівня; підсумок MUST містити для кожного рівня задану й виміряну напругу, час
  встановлення та результат. Перед подачею будь-якої напруги вище рівнів визначення мікросхеми
  програматор MUST виконати визначення мікросхеми; якщо мікросхема відповіла — самоперевірка MUST
  відмовити з окремим кодом без подачі вищих напруг. Клієнт MUST перед запуском просити користувача
  підтвердити, що панелька порожня. Самоперевірка MUST також виконуватися автоматично при кожному
  увімкненні програматора; поки останню самоперевірку не пройдено, автономний запис MUST бути
  заблокований (з відповідною індикацією), а результат MUST бути видимий клієнту у стані програматора.
  Якщо при увімкненні мікросхему виявлено й самоперевірка відмовила, автономний запис лишається
  заблокованим; локальний запуск запису в цьому стані MUST натомість виконувати повторну самоперевірку,
  і лише після її успіху наступний локальний запуск виконує запис.
- **FR-054**: Програматор MUST реалізовувати такий набір **локальних дій** (без PC), незалежний від
  конкретних органів керування: запис активного пакета; копіювання (з режимами з налаштування);
  верифікація підключеної мікросхеми проти активного пакета; самоперевірка; відновлення еталона;
  скасування поточної локальної операції. Програматор MUST повідомляти платформі стан для індикації:
  готовий, йде операція (етап і відсоток), успіх, а також невдача з класом причини — цілісність
  сховища, мікросхема (ID, не чиста, верифікація, захищена), калібрування, напруга/самоперевірка,
  еталон не відновлено, немає пакета; і стан «локальний запис заблоковано». Майбутній інтерфейс
  (кнопки, перемикачі, дисплей, сигнали конвеєра) MUST відкривати всі ці дії; до його появи на
  еталонній платформі достатньо однієї кнопки для запису.
- **FR-055**: Програматор не аналізує хід програми й калібрує вставки в порядку адрес, тому MUST
  перевіряти, що мікросхема справді виконує вимірювальний цикл саме тієї вставки, яку він калібрує:
  (1) **правдоподібність частоти** — перший вимір (до будь-якого імпульсу «+1») MUST лежати в межах від
  1/4 до 4 очікуваної частоти циклу для цієї вставки (ціль / тривалість проходу циклу); (2) **відгук на
  крок** — під час підбору частота MUST змінюватися з кроками калібрувального значення в одному напрямку
  (з урахуванням шуму виміру), а для BandGap лінія PA0 MUST вестися мікросхемою (вихід компаратора), а не
  «висіти». Невиконання будь-якої умови → окремий код `CALIB_WRONG_SITE`; далі діє FR-043 (нічого не
  записується), і примусове завершення найкращим значенням (FR-043) для цього коду MUST NOT
  застосовуватися.
- **FR-037**: Для OTP-мікросхем повний запис MUST NOT виконуватися без перевірки чистоти або перевірки
  сумісності для повторної спроби (FR-044); пакет або команда, що просить пропустити ці перевірки для
  OTP-мікросхеми, MUST відхилятися з окремим кодом помилки.
- **FR-042**: Режим калібрування при копіюванні MUST задаватися окремо для IHRC, ILRC і BandGap (у
  команді копіювання й у налаштуванні локального копіювання).
- **FR-043**: Якщо калібрування не вдалося (частота поза допуском, немає сигналу), програматор MUST NOT
  записувати нічого далі — ні завершення калібрувальної вставки, ні решти калібрувань, ні fuse — і MUST
  повідомити невдачу з найкращим знайденим значенням і виміряною частотою. Локально запущений запис MUST завершуватися лише так. Запис, запущений з PC, MAY явно
  дозволити завершити вставку найкращим знайденим значенням (окремий прапорець), що позначається в
  підсумку як примусове завершення.
- **FR-044**: **Повторна спроба** запису MUST визначатися лише вмістом мікросхеми й пакетом і MUST NOT
  залежати від сесії, часу чи екземпляра програматора: невдалу мікросхему можна дописати пізніше й іншим
  програматором із тим самим пакетом. Для перезаписуваних (FLASH/MTP) мікросхем повторна спроба — це
  звичайний повний запис зі стиранням. Для OTP-мікросхеми, яка не чиста, запис MUST бути дозволений,
  лише якщо кожне вже записане слово сумісне з ефективним образом пакета: для слова потрібні тільки
  переходи 1→0 до цільового значення; калібрувальна вставка може бути в будь-якому проміжному стані —
  чиста, вимірювальний цикл або завершена; вставка серійного номера — чиста (тоді генерується новий
  випадковий номер) або вже записана (тоді **зберігається серійний номер із мікросхеми**). Тоді програматор дописує решту, калібрує незавершені вставки й верифікує;
  підсумок позначає повторну спробу й фактичний серійний номер. Якщо записувати нічого й калібрування
  завершені — результат «мікросхему вже записано» без зміни лічильників. Несумісний вміст → «мікросхема
  не чиста» з адресою першої розбіжності, без жодного запису.
- **FR-046**: Якщо прошивка містить вставку серійного номера (макрос free-pdk), програматор MUST
  записувати в неї **випадкове 64-бітне число**, згенероване з апаратного джерела ентропії
  програматора окремо для кожної мікросхеми, в усіх режимах (з PC і локально). Параметрів серійного
  номера в пакеті немає; лічильника немає. При повторній спробі вже записаний у мікросхему номер
  зберігається (FR-044).
- **FR-052**: Копіювання MUST NOT розпізнавати чи змінювати серійний номер еталона: при локальному
  копіюванні байти номера переносяться як є (копії отримують номер еталона); при роботі з PC пошук і
  заміна серійного номера — відповідальність користувача (наприклад, прочитати еталон у файл, замінити
  номер на вставку free-pdk і завантажити як звичайний пакет). Підсумок копіювання й клієнт MUST
  попереджати, що серійний номер, якщо він є, буде продубльовано.
- **FR-053**: Якщо в дампі еталона є запис константи в регістр підстроювання (IHRC, ILRC, BandGap), який
  не розпізнано як слід калібрування free-pdk (наприклад, калібрування іншого інструмента), копіювання
  MUST виконуватися як звичайно (код переноситься як є), а підсумок і клієнт MUST попереджати з адресою,
  що копії матимуть значення підстроювання еталона без індивідуального калібрування.
- **FR-045**: Перекалібрування OTP-мікросхеми з уже завершеною калібрувальною вставкою MUST NOT
  підтримуватися (окрім випадку FR-044, коли вставку ще не завершено).
- **FR-047**: Порівняння мікросхеми з пакетом (верифікація) MUST враховувати калібрувальні вставки й
  вставки серійного номера: на місці калібрувальної вставки приймається завершена форма з будь-яким
  значенням регістра, на місці вставки серійного номера — будь-який записаний номер; решта слів — точний
  збіг. Підсумок MUST містити фактичні значення калібрування й серійний номер мікросхеми, а також
  позначку, якщо якусь вставку не завершено.
- **FR-048**: Повний запис MUST завершуватися фінальною перевіркою: після калібрування й запису fuse
  програматор MUST прочитати всю користувацьку пам'ять і точно порівняти її з ефективним образом, у
  який підставлено фактичні значення калібрування й серійний номер; розбіжність → помилка верифікації.
  Контрольні суми вмісту в підсумку MUST обчислюватися з цього читання.
- **FR-049**: Програматор MUST повторно перевіряти контрольну суму пакета під час запису (потоково, за
  даними, які фактично пишуться) і перед записом fuse; розбіжність → операція зупиняється до запису fuse
  з помилкою цілісності сховища.
- **FR-050**: Якщо в пакеті немає жодної калібрувальної вставки, програматор MUST повідомляти це в
  підтвердженні збереження пакета, а клієнт MUST показувати користувачу попередження (можливо, забуто
  макрос калібрування).
- **FR-038**: Програматор MUST надавати окрему операцію **дописування** («патч»): клієнт задає список
  слів (адреса й нове значення, до 64 слів), програматор перевіряє ID, читає поточні значення цих слів і
  виконує запис лише якщо для **кожного** слова нове значення отримується з поточного тільки
  обнуленням бітів; інакше нічого не записується, а підсумок містить адресу, поточне й бажане значення
  першого конфліктного слова. Після запису змінені слова MUST верифікуватися. Дописування в службові
  області заборонене; дописування fuse з увімкненням захисту — лише з явним дозволом. Операція
  доступна лише з PC і MUST мати режим «лише перевірити» без запису.
- **FR-039**: Перед дописуванням програматор MUST прочитати всю користувацьку пам'ять мікросхеми
  (усе, крім службових областей) і порівняти її контрольну суму з очікуваною, переданою клієнтом;
  при розбіжності MUST NOT записуватися жодне слово. Підтримуються два види контрольної суми:
  **точна** (вміст як є) і **нормалізована** (значення калібрування в слідах калібрування й байти
  серійного номера замінено нулями), щоб одна очікувана сума підходила для всієї партії мікросхем з
  однаковою прошивкою. Очікувану суму клієнт MAY задати явно або попросити програматор обчислити її з
  активного пакета («дописувати лише мікросхеми, записані цим пакетом»). Режим «лише перевірити» та
  читання мікросхеми MUST повертати обидві суми поточного вмісту. Після запису програматор MUST
  перевірити, що вся користувацька пам'ять дорівнює початковій із застосованим дописуванням.
- **FR-021**: Одночасно MUST виконуватися не більше однієї операції з мікросхемою; інші такі
  команди під час операції MUST отримувати відповідь «зайнято». Запити стану, версії й скасування
  MUST оброблятися під час операції.
- **FR-022**: Клієнт MUST мати змогу скасувати операцію; програматор MUST безпечно завершити її
  (знявши напруги) і повідомити, на якому етапі її зупинено.
- **FR-023**: Обрив зв'язку з клієнтом MUST NOT переривати операцію з мікросхемою: усі потрібні дані
  передаються до її старту, а зупинити операцію може лише явне скасування. Результат останньої
  операції MUST бути доступний клієнту після повторного підключення. Виняток — запуск мікросхеми з
  обміном даними, який при обриві зв'язку зупиняється з безпечним зняттям напруг.

**Відповіді, прогрес, помилки**

- **FR-024**: Програматор MUST відповідати на кожну команду (успіх або код помилки) протягом 100 мс;
  для довгих операцій ця відповідь MUST означати «прийнято до виконання», а підсумок MUST
  надходити окремим повідомленням.
- **FR-025**: Під час довгої операції програматор MUST надсилати повідомлення про прогрес із
  назвою етапу та відсотком виконання не рідше ніж раз на секунду.
- **FR-026**: Підсумок операції MUST містити: результат, етап, на якому вона завершилася, фактичний
  ID мікросхеми, а залежно від операції — адресу й значення першої розбіжності, результати
  калібрування (значення регістра й досягнута частота), записаний серійний номер.
- **FR-027**: Коди помилок MUST бути стабільними й задокументованими; кожен MUST однозначно
  вказувати причину (пошкоджений кадр, несумісна версія, зайнято, невідома команда, непідтримувана
  мікросхема, невалідний пакет, порушення цілісності сховища, немає пакета, невідповідність ID,
  мікросхема не чиста, помилка верифікації, помилка калібрування, мікросхема захищена, помилка
  напруги живлення/програмування, скасовано, еталон неперезаписуваний,
  еталон не відновлено, пропуск перевірки чистоти для OTP заборонено, конфлікт дописування,
  невідповідність прошивки при дописуванні, мікросхема в панельці під час самоперевірки, невдала
  самоперевірка).
- **FR-028**: Програматор MUST повідомляти клієнта про асинхронні події: старт і завершення
  автономної операції, дані від запущеної мікросхеми.
- **FR-029**: Протокол MUST бути повністю описаний у документації проєкту (`docs/`) разом із
  кодами помилок і правилами зміни версій.

**Сумісність з Easy PDK**

- **FR-030**: Програматор MUST NOT підтримувати оригінальний протокол Easy PDK 1.3; єдиний протокол
  обміну — описаний у цій специфікації. Сумісність з інструментами Easy PDK, якщо знадобиться,
  забезпечується на боці PC окремим клієнтом (наприклад, CLI з інтерфейсом командного рядка як у
  `easypdkprog`), що працює через цей протокол. Протокол MUST надавати достатньо операцій, щоб такий
  клієнт міг відтворити команди `list`, `probe`, `read`, `write`, `erase`, `start` та їхні опції.

**Калібрування при копіюванні**

- **FR-031**: При копіюванні програматор MUST розпізнавати в дампі еталона «сліди» виконаного
  калібрування (IHRC, ILRC, BandGap) за розташуванням інструкцій і адресою регістра підстроювання
  мікросхеми та, якщо не вибрано режим «перенести значення», замінювати їх у пакеті
  калібрувальними вставками, щоб кожна копія калібрувалася при записі.
- **FR-032**: Ціль калібрування IHRC/ILRC при копіюванні MUST визначатися (окремо для IHRC і ILRC) в
  одному з режимів:
  (а) **виміряти еталон** — фактична частота еталона при його власному значенні регістра;
  (б) **ціль від користувача** — частота й напруга, задані клієнтом; (в) **стандартна частота** —
  частота копії при значенні еталона, округлена до найближчої стандартної SYSCLK, якщо відхилення не
  більше 10 % (лише IHRC); (г) **перенести значення** еталона без калібрування копій. Для BandGap —
  окремий вибір: відновити з фіксованою ціллю або перенести значення еталона. У режимі (а) кожна вставка
  вимірюється окремим перезаписом еталона (кількість стирань еталона = кількість вимірюваних вставок + 1);
  вставка, до якої програма не доходить за 1 с, отримує значення еталона з попередженням.
- **FR-033**: Режим «виміряти еталон» MUST бути доступний лише для перезаписуваних (FLASH) еталонів і
  лише з явного дозволу тимчасово змінювати еталон. Перед першою зміною еталона його дамп MUST бути
  збережений із тими самими гарантіями цілісності, що й пакет; після вимірювання еталон MUST бути
  відновлений побітово ідентичним дампу й верифікований.
- **FR-034**: Стан «еталон змінено й не відновлено» MUST переживати вимкнення живлення, бути видимим
  клієнту й в автономному режимі та мати явну дію відновлення еталона з дампу.
- **FR-035**: Режими калібрування для автономного копіювання (без PC) MUST бути налаштуванням, що
  зберігається в програматорі (окремо IHRC, ILRC, BandGap); за замовчуванням — «перенести значення» для
  IHRC/ILRC і відновлення BandGap.
- **FR-036**: Підсумок копіювання MUST містити для кожного знайденого калібрування тип, значення
  еталона, визначену ціль і режим, а також попередження, якщо ціль не визначено й значення перенесено.
- **FR-051**: Якщо в дампі еталона на місці калібрування знайдено **вимірювальний цикл** (еталон не
  відкалібровано — калібрування колись не вдалося або було перерване; така мікросхема не працює),
  копіювання MUST зупинитися **до** збереження пакета: у сховище програматора нічого не записується, а
  підсумок містить адресу й тип кожного такого циклу. Локальне копіювання на цьому завершується з
  сигналом неуспіху. При копіюванні з PC клієнт MUST запитати користувача, що робити: скасувати або
  задати ціль калібрування для цих вставок; у другому випадку клієнт повторює копіювання з заданою
  ціллю й явним дозволом, і програматор відновлює на місці циклу калібрувальну вставку з цією ціллю.

### Key Entities *(include if feature involves data)*

- **Пакет прошивки**: усе, що потрібно для запису мікросхем певного типу; складається з
  метаданих, образу пам'яті програм і наскрізної контрольної суми. Може бути завантажений з PC або
  створений копіюванням мікросхеми.
- **Метадані пакета**: ідентифікатор мікросхеми, fuse і дозвіл захисту, опції операцій, напруга запуску, ім'я та опис, контрольна сума вихідного файлу, версія формату пакета.
- **Образ пам'яті**: послідовність слів пам'яті програм із маскою заданих слів.
- **Опис мікросхеми**: запис у таблиці програматора (назва, ID, обсяг, розрядність, тип, службові
  області, доступні операції); клієнту передається лише для показу й попередньої перевірки.
- **Кадр**: одиниця обміну з довжиною, порядковим номером, типом, даними й контролем цілісності.
- **Команда / Відповідь**: запит клієнта і відповідь програматора з тим самим порядковим номером.
- **Операція**: довготривала дія з мікросхемою зі станом (виконується / завершена / скасована),
  етапами та підсумком.
- **Подія**: повідомлення програматора без запиту (прогрес, підсумок, автономна операція, дані від
  мікросхеми).
- **Статистика**: енергонезалежні лічильники успішних і невдалих записів.
- **Слід калібрування**: фрагмент коду відкаліброваної мікросхеми (NOP-и, завантаження значення,
  запис у регістр підстроювання на фіксованих позиціях); дає позицію, тип і значення еталона, але не
  ціль калібрування.
- **Дамп еталона**: незмінена копія вмісту еталона, збережена до будь-якої його зміни; джерело для
  відновлення еталона.

## Success Criteria *(mandatory)*

### Measurable Outcomes

- **SC-001**: При штучному внесенні помилок у ≥1 % кадрів під час 1000 завантажень пакета
  максимального розміру 100 % завантажень завершуються збереженням образу, ідентичного вихідному,
  і жодного разу не зберігається пошкоджений пакет.
- **SC-002**: У 100 % випадків пошкодженого збереженого пакета (тест із примусовим пошкодженням
  кожного байта пакета по черзі) програматор відмовляється записувати мікросхему.
- **SC-003**: Завантаження пакета максимального розміру, який програматор приймає для запису
  (повідомляє клієнту; на еталонній платформі — 8 КБ), з підтвердженням займає не більше 3 с.
- **SC-004**: Повний запис PFS154 повним образом (стирання, перевірка, запис, верифікація, одне
  калібрування, fuse) від натискання «Записати» до підсумку займає не більше 10 с. *Перевіряється на
  реальній мікросхемі разом із фічею `002-chip-engine`; у цій фічі — на моделі мікросхеми.*
- **SC-005**: Під час будь-якої операції довше 1 с користувач бачить оновлення прогресу щонайменше
  раз на секунду.
- **SC-006**: Додавання підтримки нової мікросхеми потребує лише оновлення прошивки програматора:
  незмінений клієнт показує її у списку й виконує з нею всі операції.
- **SC-007**: Вимкнення живлення або обрив USB у довільний момент завантаження пакета (≥100
  випробувань) щоразу залишає в програматорі або попередній, або новий пакет, і завжди цілісний.
- **SC-008**: Обрив USB-з'єднання (без втрати живлення програматора) у довільний момент запису
  (≥ 100 випробувань) не змінює результату: вміст мікросхеми й підсумок такі самі, як без обриву, а
  підсумок доступний після повторного підключення.
- **SC-012**: Після обриву живлення в довільний момент запису OTP-мікросхеми (≥ 100 випробувань на
  моделі) повторний запис тієї самої мікросхеми — тим самим або іншим програматором із тим самим пакетом —
  щоразу або завершується успіхом із позначкою повторної
  спроби, або відмовляє без жодного запису, якщо вміст несумісний; у мікросхемі ніколи не з'являється
  нуль, якого немає в ефективному образі.
- **SC-013**: При невдалому калібруванні (несправна модель осцилятора) після операції в мікросхемі
  немає жодного записаного слова поза основним образом і вимірювальним циклом; повторний запис після
  «ремонту» осцилятора завершує калібрування успішно.
- **SC-009**: Для каліброваного FLASH-еталона в режимі «виміряти еталон» частота IHRC копій
  відрізняється від частоти еталона (виміряної тим самим програматором) не більше ніж на 1 %, а
  еталон після копіювання побітово ідентичний своєму вмісту до копіювання. *У цій фічі — на моделі
  мікросхеми; на реальних PFS154 — разом із `002-chip-engine`.*
- **SC-010**: Обрив живлення в довільний момент копіювання в режимі «виміряти еталон» (≥ 100
  випробувань) ніколи не призводить до втрати вмісту еталона: його завжди можна відновити з дампу.
- **SC-011**: Жоден обмін даними з мікросхемою не починається, поки VDD і VPP не перебувають у межах
  ±2 % / ±30 мВ від заданих; при штучно несправному джерелі (симуляція й залізо) операція
  завершується помилкою напруги не пізніше ніж за 20 мс після зміни, без жодного запису в мікросхему.

## Assumptions

- Клієнт розбирає файли прошивки (Intel HEX / bin) і формує образ; програматор файлових форматів
  не знає (принцип I конституції).
- Одночасно з програматором працює не більше одного клієнта.
- Програматор зберігає один активний пакет (FR-016); кількість слотів і розмітку сховища основної МК буде
  визначено після її вибору (наступна специфікація) — протокол розширюваний мінорною версією.
- Максимальний обсяг читання — 4096 слів по 16 біт (найбільша з підтримуваних мікросхем); найбільший
  пакет для запису визначає ємність сховища програматора (на еталонній платформі — 8 КБ, що покриває
  всі мікросхеми з підтримкою запису; мікросхема на 4096 слів — лише для читання).
- Калібрувальні вставки й вставки серійного номера мають формат, сумісний з макросами free-pdk
  (`easypdk/pdkcommon.h`), щоб існуючі програми працювали без змін. Програматор знаходить їх пошуком
  шаблону в образі, адреси ніхто не передає; вставка може стояти будь-де, але має **гарантовано
  виконуватися при старті** програми (free-pdk: у `_sdcc_external_startup()`) і після вибору
  тактування — інакше калібрування не вдасться (FR-043). На розробнику — ставити по одному макросу на
  кожен параметр, який програма використовує (IHRC, ILRC, BandGap).
- Основний сценарій виробничого використання — програмування в схемі (на цільовій платі) через
  pogo-контакти; терміни «мікросхема в панельці» і «підключена мікросхема» в цій специфікації
  рівнозначні. Інші компоненти плати можуть навантажувати VDD, що враховує перевірка напруг (FR-040).
- Для калібрування лінії PA3 і PA4 мікросхеми мають бути вільними або розв'язаними від інших кіл
  цільової плати на час програмування; інакше калібрування може не вдатися (FR-043).
- Якщо програматор живиться від USB, висмикування кабелю — це обрив живлення (FR-044), а не лише обрив
  зв'язку (FR-023).
- Напруга, на якій калібрувався еталон, із дампу невідома; при копіюванні використовується
  напруга, задана клієнтом, або типова 5.0 В.
- Ресурс стирання FLASH-мікросхем PADAUK обмежений, тому режим «виміряти еталон» (кілька додаткових
  циклів стирання еталона) ніколи не вмикається без явного дозволу.
- Ім'я пакета закладено на майбутнє: версія програматора з екраном і більшою пам'яттю зберігатиме кілька
  пакетів і показуватиме їх за іменем; у цій фічі ім'я лише зберігається й повертається клієнту.
- У програматора немає годинника реального часу; часові мітки, якщо потрібні, задає клієнт.
- Серійний номер — випадкове 64-бітне число (FR-046); послідовна нумерація в цій фічі не підтримується
  (за потреби — окремою фічею). Ймовірність збігу навіть для мільйона мікросхем ~3·10⁻⁸, координація
  між програматорами не потрібна.
- Серійний номер прошивки, зібраної не за допомогою free-pdk, може бути будь-де й будь-якої довжини,
  тому копіювання його не розпізнає (FR-052).
- Захист від читання (security fuse) встановлюється лише за явного дозволу в пакеті
  (принцип III конституції); обхід захисту при читанні не підтримується.
- Оскільки пакет один (FR-016), запис мікросхеми з PC завжди йде через завантаження пакета в
  сховище: CLI-клієнт у стилі `easypdkprog write` замінює активний пакет у програматорі.
- Конкретні алгоритми контролю цілісності, формат кадрів і розміри фрагментів визначаються на етапі
  планування; ця специфікація задає лише вимоги до виявлення помилок.
