kolod/padauk-programmer/specs/001-pc-programmer-protocol/research.md

# Research: Протокол обміну PC ⇄ програматор

**Feature**: [spec.md](spec.md) · **Plan**: [plan.md](plan.md) · **Date**: 2026-10-09

Кожне рішення: **Decision** — що обрано, **Rationale** — чому, **Alternatives** — що відкинуто.

---

## R1. Кадрування потоку байтів USB CDC

- **Decision**: кадр кодується **COBS** (Consistent Overhead Byte Stuffing), роздільник кадрів — байт `0x00`.
- **Rationale**: CDC — це потік байтів без меж повідомлень. COBS гарантує, що `0x00` трапляється лише як
  роздільник, тож після будь-якого пошкодження приймач ресинхронізується на наступному `0x00`. Накладні
  витрати детерміновані (≤ 1 байт на 254), а кодер і декодер займають ~60 рядків C і доступні в Python.
- **Alternatives**: SLIP — змінні накладні витрати (до 2×), гірше для бінарних образів;
  sync-байт + довжина — після пошкодження довжини втрачається синхронізація до тайм-ауту;
  HDLC bit-stuffing — надмірно для USB.

## R2. Контроль цілісності кадру та пакета

- **Decision**: **CRC-32/ISO-HDLC** (поліном 0x04C11DB7, reflected, init 0xFFFFFFFF, xorout 0xFFFFFFFF —
  те саме, що `zlib.crc32`) як для кадрів, так і для пакета прошивки. CRC пакета обчислює клієнт над усім
  пакетом до передачі; це окремий, наскрізний контроль поверх CRC кадрів.
- **Rationale**: для повідомлень до ~11 КБ CRC-32 має відстань Хеммінга 4 — виявляє всі 1-, 2-, 3-бітові
  помилки та всі пакети помилок до 32 біт (FR-008). Кадри (≤ ~0.5 КБ) і пакет (≤ 8 КБ) у цих межах.
  STM32F072 має апаратний CRC-блок із програмованим поліномом і реверсом вхідних/вихідних бітів;
  програмний табличний варіант (1 КБ або 64 Б для півбайтової таблиці) — для інших платформ і хост-збірки.
  Python-клієнт використовує `zlib.crc32` без залежностей.
- **Alternatives**: CRC-32C — краща HD на коротких повідомленнях, але немає в апаратному блоці F0 у
  «рідному» вигляді й відсутня в стандартній бібліотеці Python; SHA-256 для пакета — захист від
  навмисної підробки не потрібен (загроза — випадкові помилки), коштує коду й часу на Cortex-M0;
  CRC-16 — недостатньо для 8 КБ.

## R3. Надійність доставки

- **Decision**: **stop-and-wait** (вікно 1). Клієнт має не більше одного незавершеного запиту; кожен новий
  запит отримує наступний `seq` (u16). Програматор кешує останню відповідь: запит із тим самим `seq`
  отримує ту саму відповідь без повторного виконання (FR-009). Пошкоджений кадр → `NAK` (без `seq`),
  клієнт повторює поточний запит. Тайм-аут відповіді на клієнті — 300 мс, до 5 повторів.
- **Rationale**: USB FS дає ~1 МБ/с; пакет 8 КБ — це ~16 кадрів по 512 Б, тож навіть з затримкою 2–3 мс
  на кадр завантаження займає < 0.1 с (SC-003 ≤ 3 с). Ковзне вікно не дає виграшу, але ускладнює кеш.
- **Alternatives**: ковзне вікно / селективний повтор — непотрібна складність; покладатися на те, що
  USB «не губить даних», — суперечить FR-008 і не захищає від помилок прошивки/драйвера, обриву.

## R4. Довгі операції, прогрес і скасування

- **Decision**: `OP_START` одразу відповідає `OK` з `op_id` (≤ 100 мс, FR-024). Далі програматор шле події
  `EVT_PROGRESS` (при зміні етапу і не рідше ніж раз на 500 мс) та `EVT_OP_DONE` з підсумком. Події не
  підтверджуються; підсумок останньої операції завжди можна отримати через `OP_RESULT`, тож втрата
  події не є проблемою. Рушій операцій викликає `poll()` протокольного шару між атомарними кроками
  (блок запису, слово читання, імпульс стирання), обслуговуючи дозволені під час операції команди:
  `HELLO`, `GET_INFO`, `GET_STATUS`, `PKG_INFO`, `STATS_GET`, `CONFIG_GET`, `OP_RESULT`, `OP_CANCEL`,
  `UART_TX` (стовпець «Під час операції» в contracts/protocol.md §4 — головний); решта → `BUSY` (FR-021).
- **Rationale**: bit-bang із мікросхемою блокуючий і чутливий до таймингів, тому протокол не можна
  обробляти в довільний момент; найдовший атомарний крок — імпульс стирання FLASH_2 (40 мс) — менший
  за 100 мс, отже вимога відповіді виконується. RTOS не потрібна.
- **Alternatives**: RTOS із окремою задачею протоколу — більше RAM/flash, ризик джитера bit-bang;
  обробка команд у перериванні USB — небезпечно змінювати стан під час операції.

## R5. Розміщення сховища у flash і атомарність

- **Decision**: два однакові **слоти** під пакет і окремий **журнал стану** з двох сторінок. Активний
  слот, його покоління й CRC пакета, налаштування й статистика записуються як записи
  журналу з власним CRC. Завантаження пишеться в неактивний слот; комміт = перевірка CRC пакета у flash +
  дописування нового запису журналу. Розмітку й кількість слотів задає платформа (`GET_INFO`); для
  основної МК вони визначаються після її вибору (наступна специфікація). Ціль налагодження F072 (64 КБ,
  сторінка 2 КБ):

  | Область | Адреси | Розмір |
  |---|---|---|
  | Прошивка | `0x0800_0000–0x0800_AFFF` | 44 КБ |
  | Слот 0 | `0x0800_B000–0x0800_CFFF` | 8 КБ |
  | Слот 1 | `0x0800_D000–0x0800_EFFF` | 8 КБ |
  | Журнал стану (2 сторінки) | `0x0800_F000–0x0800_FFFF` | 4 КБ |

- **Rationale**: обрив живлення до запису журналу залишає попередній вказівник — активним лишається
  старий пакет (FR-011, SC-007); недописаний запис журналу має невалідний CRC і ігнорується. Вміст
  неактивного слота ніколи не інтерпретується як пакет, тому його можна використовувати як буфер
  результату читання мікросхеми (до 8192 байт сирих слів — вистачає на PMS133 з 4096 словами) без RAM-буфера.
  Слоти, що не містять активного пакета, і запасна сторінка журналу стираються **у фоні**
  (`core/storage/housekeeping`, по одній сторінці за прохід головного циклу) одразу після `PKG_COMMIT`,
  `PKG_DELETE`, обірваного завантаження чи старту з «брудним» слотом. Завантаження пише в уже чистий
  слот і нічого не стирає всередині команди; лише якщо фонове стирання ще не встигло, сторінка
  дочищається при першому зверненні `PKG_DATA` (≤ 1 сторінка на команду). На флешах, що стирають
  асинхронно (W25Q), фонове стирання призупиняється (erase suspend) для читання й запису інших сторінок;
  на внутрішній flash F072 воно синхронне, але відбувається в простої. Платформа задає кількість слотів
  (2 … 4): з 3+ слотами навіть завантаження одне за одним завжди потрапляють у чистий слот. Побічний
  ефект — видалений або замінений пакет фізично стирається, а не лише перестає бути активним.
  Платформа також задає одиницю запису flash (2 Б на STM32F0, 8 Б на STM32G4 з ECC, де кожне
  подвійне слово пишеться один раз): ядро притримує байти, що не заповнюють одиницю, до наступного
  `PKG_DATA`, а останню одиницю доповнює `0xFF` перед `PKG_COMMIT`. Буфер
  результату `READ` у вільному слоті MUST резервуватися від фонового стирання так само, як слот
  поточного завантаження (`slots_set_upload`). Не потрібна перезапис-без-стирання (0x0000 поверх
  даних), яку підтримують не всі МК, — краще для переносимості (принцип IV).
- **Alternatives**: один слот + RAM-буфер 8 КБ — не атомарно при обриві під час запису flash; заголовок
  із «поколінням» у самому слоті — сирі дані читання можуть випадково виглядати як заголовок, а
  пошкодження нового слота «воскрешає» старий пакет; зовнішня EEPROM/SPI-flash — додаткова деталь,
  можлива на інших платформах через HAL.
- **Risk / рішення**: обсяг фічі не вміщується впевнено в 44 КБ F072, тому основною платформою буде
  потужніша STM32 (вибір — наступна специфікація). На F072 як цілі налагодження частину функцій
  (наприклад, `MEASURE_MASTER`, `PATCH`) MAY вимикати конфігурацією збірки; `INFO.capabilities` це
  відображає.

## R6. Зношування flash журналом

- **Decision**: запис журналу — **40 байт** (36 байт полів + CRC-32, data-model `StateRecord`); кожен
  успішний/невдалий запис мікросхеми дописує один запис; коли сторінка заповнена, наступний запис іде
  на другу сторінку. Друга (запасна) сторінка стирається у фоні, щойно чинний запис лежить на поточній
  сторінці, тож перемикання сторінок не стирає нічого всередині команди; сторінку з чинним записом
  (наприклад, якщо перший запис на новій сторінці не вдався) не стирають ніколи.
- **Rationale**: 51 запис на сторінку × 10 000 циклів стирання ≈ 510 000 мікросхем на сторінку —
  більше, ніж ресурс панельки. Обрив під час стирання другої сторінки не втрачає даних: повна сторінка
  лишається. Лічильник серійних номерів переживає вимкнення (US3).
- **Alternatives**: запис лише при зміні пакета + RAM-лічильник — серійні номери повторюються після
  вимкнення; емуляція EEPROM ST — прив'язка до бібліотеки ST.

## R7. Формат пакета прошивки

- **Decision**: бінарний little-endian формат: фіксований заголовок 128 Б із власним CRC, далі слова образу
  (`u16 × N`), бітова маска заданих слів (кратна 16 бітам) і CRC-32 усього пакета. Деталі —
  [contracts/package-format.md](contracts/package-format.md).
- **Rationale**: заголовок перевіряється в `PKG_BEGIN` ще до прийому даних (непідтримувана мікросхема,
  завеликий образ, заборонений захисний fuse) — помилка видна відразу. Маска відрізняє «не задано» від
  будь-якого значення, тож не потрібні сентинели на кшталт 0xFFFF (FR-004). Максимальний пакет для
  мікросхем із записом (PFS173, 3072 слова) = 128 + 6144 + 384 + 4 = 6660 Б < 8 КБ слота.
  **Межі різні для читання й запису**: `max_package_size` (з `INFO`) обмежує пакет для запису — на F072
  8192 Б, тобто до ~4000 слів; `max_read_words` обмежує читання — 4096 слів (сирі дані займають рівно
  слот). Пакет на 4096 слів (8836 Б) не потрібен: мікросхема з 4096 словами (PMS133) лише для читання.
- **Alternatives**: передавати Intel HEX і розбирати в програматорі — суперечить принципу I (формати
  файлів — на PC) і витрачає flash; TLV-метадані — гнучкіше, але складніша валідація; версія формату
  в заголовку дає розширюваність.

## R8. Хто знає про fuse, калібрування, серійний номер

- **Decision**: усе визначає програматор (принцип I):
  - **fuse**: якщо образ задає останнє слово пам'яті програм, воно трактується як fuse; якщо в заголовку
    також є `FUSE_PRESENT` з іншим значенням — помилка `PKG_FUSE_CONFLICT`;
  - **калібрування**: програматор шукає вставки free-pdk для розрядності ядра мікросхеми (див. нижче),
    відхиляє пакет із невідомою вставкою, виконує калібрування сам;
  - **серійний номер**: пошук 8 інструкцій `RET 'F','P','S','E','R','I','A','L'`; кожна знайдена вставка
    отримує випадковий 64-бітний номер (R18), параметрів у пакеті немає.
  Під час запису образ читається з flash і трансформується «на льоту» (вставки калібрування, серійний номер,
  заповнення NOP, виключення fuse) за невеликою таблицею позицій, обчисленою при валідації пакета.
  **Пошук калібрувальних вставок.** Адреси ніхто не передає: при `PKG_COMMIT` програматор проходить усю
  пам'ять програм і шукає шаблон — послідовність `AND A,#imm` (опкод за розрядністю ядра: `0x14xx` —
  13 біт, `0x2Cxx` — 14, `0x54xx` — 15):
  - IHRC/ILRC, 10 слів: `'R'`, `'C'`, тип (1/2), частота (4 байти), напруга (2 байти), адреса регістра;
  - BandGap, 14 слів: `'B'`, `'G'`, 3, напруга (2 байти), `BGTR`, `GPCC`, `GPCS`, `0` × 6;
  - ≥ 6 послідовних `AND A,#…`, що не збігаються з відомим шаблоном → `PKG_CALIB_UNKNOWN` з адресою
    (найімовірніше, вставка з новішого SDK — мовчки записати її як код небезпечно);
  - до 16 вставок; знайдені позиції, тип, частота, напруга й регістри зберігаються в плані ефективного
    образу. Єдиний `GOTO` вимірювального циклу виправляється під знайдену позицію, тож вставка працює
    будь-де. Так само знаходяться вставки серійного номера й (при `COPY`) сліди калібрування.
  Хибний збіг зі звичайним кодом практично неможливий (10 `AND A` поспіль із `'R','C'` не мають сенсу);
  досяжність вставки при старті статично не перевіряється — її відсутність виявляється як «немає сигналу»
  під час калібрування (`CALIB_FAILED`).
- **Rationale**: клієнт стає тонким, а додавання нової мікросхеми не вимагає змін клієнта (SC-006).
  Трансформація на льоту не потребує RAM-копії образу; той самий детектор вставок використовують
  валідація, ефективний образ, верифікація з урахуванням вставок (FR-047), фінальна перевірка (FR-048),
  повторна спроба (FR-044) і нормалізована сума.
- **Alternatives**: клієнт патчить образ (як `easypdkprog`) — порушує принцип I.

## R9. Копіювання та калібровані мікросхеми

- **Decision**: `COPY` розпізнає в дампі **сліди калібрування** і відновлює в пакеті калібрувальні
  вставки free-pdk, щоб кожна копія калібрувалася при `PROGRAM`. Режим задається **окремо для кожного
  типу** (`mode_ihrc`, `mode_ilrc`, `bg_restore` в `ext` команди `COPY`; FR-042):

  | Режим (IHRC / ILRC) | Ціль | IHRC | ILRC | Коли можливий |
  |---|---|---|---|---|
  | `KEEP_VALUE` (0) | вставка не відновлюється, `k` еталона | ✓ | ✓ | завжди |
  | `TARGET_FROM_HOST` (1) | ціль з клієнта (`target_ihrc_hz` / `target_ilrc_hz`) | ✓ | ✓ | лише з PC |
  | `SNAP_STANDARD` (2) | при `PROGRAM` кожної копії: виміряти копію при `k` еталона → найближча SYSCLK з {16 М, 8 М, 4 М, 2 М, 1 М, 500 к}, якщо відхилення ≤ 10 %; інакше `k` еталона з попередженням | ✓ | ✗ (розкид ILRC між екземплярами завеликий) | завжди |
  | `MEASURE_MASTER` (3) | фактична частота еталона при його `k` | ✓ | ✓ | FLASH-еталон + `ALLOW_MODIFY_MASTER`, лише з PC |

  BandGap: `bg_restore = 1` — вставка з фіксованою ціллю (3950 мВ, як у макросі free-pdk), `0` — `k`
  еталона. Адреси `BGTR`/`GPCC`/`GPCS` і `IHRCR`/`ILRCR` — з таблиці мікросхем. Для локального копіювання
  (`CONFIG_SET`) дозволено IHRC 0 або 2, ILRC 0, BG 0/1; типово `0, 0, 1` (= колишній
  `KEEP_RC_RESTORE_BG`). `COPY` мікросхеми без операції запису в таблиці (напр. PMS133) →
  `OP_UNSUPPORTED`: створений пакет неможливо записати.

  **Калібрування чужого формату** (FR-053): запис константи в регістр підстроювання поза розпізнаними
  слідами (`MOV A,#k` → `MOV IO(IHRCR|ILRCR|BGTR),A`) — код копіюється як є, `warnings.CALIB_UNRECOGNIZED`
  з адресою. Завантаження заводського значення (`EASY_PDK_USE_FACTORY_*`) читає його з пам'яті, а не
  константу, тому попередження не викликає.

  **Вимірювальний цикл в еталоні** (FR-051): еталон не відкалібровано й він не працює; цілі в циклі
  немає. Локально — відмова без запису в сховище; з PC — клієнт питає користувача й за згоди повторює
  `COPY` з `ALLOW_MASTER_LOOP` і ціллю `TARGET_FROM_HOST`.

  **Кілька слідів у `MEASURE_MASTER`.** Вимірювальний цикл безкінечний, тому за один перезапис
  еталона вимірюється один слід; сліди перед ним виконуються зі значеннями еталона — ті самі умови, що
  й при початковому калібруванні free-pdk (послідовно за адресою). Стирань еталона = n + 1, де n —
  кількість слідів у режимі 3. Слід без сигналу на PA3 протягом 1 с (програма до нього не доходить,
  PA3/PA4 навантажені платою) → `k` еталона, `site_status = COPIED`, попередження; решта слідів далі.
  *Можливе покращення (не в цій фічі):* «цикл із виходом» — імпульс на PA4 виводить процесор із циклу до
  продовження сліду, тож усі сліди вимірюються за один перезапис (завжди 2 стирання). Потребує нового
  циклу з точно відомою кількістю тактів (пропуск команди в PADAUK — 2 такти) і перевірки на моделі й
  залізі; доцільне, якщо еталони з кількома RC-калібруваннями виявляться поширеними.

  **Сліди калібрування** (позиції відносно початку; решта — `NOP`):

  | Тип | Довжина | Ненульові слова |
  |---|---|---|
  | IHRC / ILRC | 10 | [2] `MOV A,#k`, [5] `MOV IO(IHRCR\|ILRCR),A` |
  | BandGap | 14 | [7] `MOV A,#k`, [9] `MOV IO(BGTR),A` |

  Збіг вимагає, щоб адреса регістра дорівнювала адресі з таблиці мікросхеми. Випадковий збіг у
  звичайному коді малоймовірний і майже нешкідливий: змінюється лише константа, що пишеться в той самий
  регістр підстроювання.

  **Послідовність `MEASURE_MASTER`**:
  1. `READ` еталона → дамп у неактивний слот → пакет `KEEP_VALUE` → **комміт** (дамп у безпеці);
  2. запис журналу з прапорцем `MASTER_RESTORE_PENDING` і CRC дампу;
  3. для кожного сліду IHRC/ILRC по черзі: стерти еталон; записати дамп, у якому цей слід замінено
     вимірювальним циклом із початковим значенням `k` (`MOV A,#(k−1)`, бо цикл спочатку виконує `ADD A,1`),
     а решта слідів не змінена; подати VDD (`mV` з клієнта або 5000) і виміряти частоту на PA3 **без
     імпульсів на PA4** → `f_master(k)`;
  4. стерти еталон, записати дамп (`PROGRAM` пакета `KEEP_VALUE` зі стиранням), **верифікувати**;
  5. запис журналу без `MASTER_RESTORE_PENDING`;
  6. сформувати фінальний пакет з відновленими вставками (ціль = `f_master(k)`) → комміт.

  Обрив між кроками 2 і 5: після увімкнення `STATUS.flags.MASTER_RESTORE_PENDING = 1`; операція
  `RESTORE_MASTER` (з PC або локальним запуском) виконує крок 4 з активного пакета-дампу. Якщо замість еталона
  вставлено чисту мікросхему того самого типу, `RESTORE_MASTER` просто запише в неї копію з `k` еталона —
  це безпечно.

  `SNAP_STANDARD` потребує `k` під час `PROGRAM`; програматор кодує його у відновленій вставці
  внутрішнім значенням частоти `0xFF0000kk` (неможливе для реальної вставки, див. package-format).

- **Rationale**: `f_master(k)` — це частота, на якій реально працює еталон, тобто саме те, що мають
  повторювати копії; похибка — крок регістра підстроювання (частки відсотка) плюс відмінність напруги
  вимірювання. Перехід «NOP → вимірювальний цикл» вимагає 0→1, тому без стирання еталона вимір
  неможливий; для OTP-еталонів лишаються режими 0–2. Збереження дампу як закоміченого пакета до першого
  стирання гарантує, що еталон завжди можна відновити (SC-010).
- **Alternatives**: лише переносити `k` (попередня редакція) — копії мають розкид частоти між
  екземплярами; вимірювати копію при `k` еталона як ціль — повторює розкид копії, а не еталона;
  вимірювати еталон без перезапису — у відкаліброваному коді немає виходу частоти на пін.
- **Risk**: ресурс стирання FLASH PADAUK (уточнити за даташитом PFS154) — `MEASURE_MASTER` додає
  (кількість слідів + 1) циклів стирання еталона; тому лише з явного дозволу.

## R10. Визначення захищеної мікросхеми

- **Decision**: після читання програматор перевіряє біт захисту в прочитаному fuse-слові; якщо захист
  увімкнено — `CHIP_PROTECTED`, результат не віддається і пакет не створюється.
- **Open risk**: як саме PADAUK віддає дані захищеної мікросхеми (нулі, сміття чи коректний fuse), у коді
  free-pdk не описано. **Потрібна перевірка на реальній захищеній PFS154** (задача валідації на залізі).
  Запасний критерій — образ складається з однакових слів.

## R11. USB-стек і ідентифікатори

- **Decision**: **TinyUSB** (MIT) для CDC ACM. VID/PID — із програми **pid.codes** (VID `0x1209`, власний
  PID для відкритого заліза); до отримання — тестовий PID `0x1209:0x0001`.
- **Rationale**: TinyUSB підтримує STM32F0/F4/G4, RP2040 тощо — заміна МК не змінює USB-коду (принцип IV);
  MIT сумісна з GPL-3.0. Використання VID ST (`0x0483:0x5740`) у своєму продукті некоректне.
- **Alternatives**: ST USB Device Library — прив'язка до ST і потреба в додатковому дозволі до GPL (як в
  оригіналі); libopencm3 — LGPL, вужча підтримка МК.

## R12. Мова та тестування клієнта

- **Decision**: еталонний клієнт — **Python 3.10+** з `pyserial`: бібліотека протоколу, формування пакета з
  Intel HEX, CLI у стилі `easypdkprog` (FR-030). Тести — `pytest`.
- **Rationale**: кросплатформеність без власних драйверів, `zlib.crc32` і `struct` «з коробки», швидко
  писати й змінювати. Вимоги продуктивності клієнта мінімальні.
- **Alternatives**: C — дублює ядро, повільніша розробка CLI; Rust — добре, але вищий поріг для внесків.

## R13. Перевірка без заліза

- **Decision**: ядро прошивки збирається для PC разом із фіктивним HAL у **симулятор програматора** —
  виконуваний файл, що говорить протоколом через stdin/stdout або TCP і емулює flash (з можливістю
  «обірвати живлення» на довільній операції запису) та мікросхему (модель PFS154 у пам'яті). Клієнт і
  контрактні тести запускаються проти симулятора; ін'єкція помилок у кадри — у проміжному шарі тесту.
- **Rationale**: дає змогу автоматично перевірити SC-001, SC-002, SC-007 тисячі разів (принцип VI).
- **Alternatives**: лише тести на залізі — повільно, не відтворює обриви живлення в довільній точці.

## R14. Межі фічі щодо рушія мікросхем

- **Decision**: ця фіча реалізує протокол, формат пакета, сховище, диспетчер операцій і **інтерфейс**
  рушія мікросхем (`chip_engine`), а також модель мікросхеми для симулятора. Bit-level алгоритми для
  сімейств PADAUK (перенесення з free-pdk `fpdk.c`, калібрування) — окрема фіча **002-chip-engine**.
  Критерій SC-004 (запис PFS154 за ≤ 10 с) перевіряється після 002.
- **Rationale**: протокол можна повністю розробити й перевірити на симуляторі; алгоритми мікросхем
  мають власні вимоги до таймингів і валідації на залізі.

## R15. Встановлення напруг і самоперевірка

- **Decision**: керування VDD/VPP виноситься в окремий HAL `hal_power.h` (задати мВ, виміряти мВ,
  увімкнути/вимкнути розряд), а **політику встановлення** (FR-040) реалізує платформонезалежне ядро
  (`core/power/power.c`), яким користуються і рушій мікросхем, і самоперевірка:
  1. задати напругу; запам'ятати момент зміни;
  2. чекати, доки мине мінімальна пауза етапу (з таблиці: 100 мкс / 500 мкс / 1 мс / 10 мс) **і**
     `N = 3` послідовні виміри з кроком ≥ 50 мкс лежать у межах ±2 % або ±30 мВ (більше з двох);
  3. якщо за 20 мс від зміни умову не виконано → `safe_state`, `VDD_FAULT`/`VPP_FAULT`, у `RESULT`
     — шина, задана й остання виміряна напруга.
  Самоперевірка (`SELF_TEST`) використовує той самий механізм: спершу `PROBE` при VPP 4.5 В / VDD 2.0 В;
  відповідь мікросхеми → `SELFTEST_CHIP_PRESENT` без подачі вищих напруг; далі по черзі (інша шина = 0)
  рівні VDD і VPP — усі різні значення з таблиці мікросхем у порядку зростання — і після кожної шини 0 В;
  результат кожного рівня (задано, виміряно, час встановлення, ok) — у `RESULT.levels[]`.
  Виконується автоматично при старті (джерело — локальне) і на запит з PC; поки результату «пройдено»
  немає, локальний запуск запису замінюється самоперевіркою.
- **Rationale**: одна реалізація політики для всіх шляхів (запис, самоперевірка, симулятор із моделлю
  несправного джерела) → FR-040 і SC-011 перевіряються автоматично; апаратна частина лише вимірює.
  Мінімальна пауза лишається, бо може покривати внутрішні процеси мікросхеми, а не лише шину живлення.
  Допуск ±2 % / ±30 мВ і тайм-аут 20 мс задають вимоги до нового джерела напруг (швидкість встановлення
  < 20 мс, точність АЦП краща за ±1 %) — їх треба врахувати в схемі.
- **Alternatives**: перевірка напруг усередині рушія `002` — дублювання й неможливість перевірити без
  заліза; фіксовані паузи без вимірювання — порушують принцип III; самоперевірка лише на запит — рішення
  сесії уточнення: автоматично при старті.
- **Risk**: навантаження цільової плати при програмуванні в схемі (pogo) може сповільнити встановлення
  VDD понад 20 мс — тоді або сильніше джерело, або параметр тайм-ауту в таблиці мікросхем (розширення
  без зміни протоколу).

## R16. Локальний запуск замість «кнопки»

- **Decision**: ядро приймає абстрактну подію `local_start(request)` від платформного шару органів
  керування (кнопки, перемикачі, сигнали конвеєра — окрема фіча). Запит перетворюється на операцію за
  пріоритетом: (1) самоперевірку не пройдено → `SELF_TEST`; (2) `MASTER_RESTORE_PENDING` → `RESTORE_MASTER`;
  (3) інакше запитана операція (`PROGRAM`, `COPY` з режимом із `CONFIG`, `VERIFY`, `SELF_TEST`,
  `RESTORE_MASTER`); плюс `local_cancel()`. У протоколі — `source = 1` («локальний»). Повний набір дій і
  станів індикації зафіксовано (FR-054, contracts/chip-engine.md §4) — майбутній інтерфейс лише
  відображає їх; до нього еталонна плата має одну кнопку → `PROGRAM`.
- **Rationale**: протокол і ядро не залежать від того, скільки кнопок і перемикачів матиме програматор
  (рішення сесії уточнення).
- **Alternatives**: жести однієї кнопки (довге натискання тощо) у ядрі — прив'язує ядро до конкретного UI.

## R17. Невдале калібрування, повторна спроба запису OTP, незалежність від USB

- **Decision**:
  - **Невдале калібрування** (FR-043): після вимірювального циклу нічого не записується — вставка
    лишається циклом, наступні калібрування й fuse пропускаються, серійний номер не витрачається;
    `CALIB_FAILED` з найкращим `k` і частотою. З PC прапорець `CALIB_FINALIZE_ON_FAIL` дозволяє
    завершити найкращим значенням (`warnings.CALIB_FORCED`); локальний запуск його ігнорує.
  - **Повторна спроба** (FR-044) визначається лише вмістом мікросхеми й пакетом — може відбутися через
    будь-який час і на іншому програматорі. FLASH/MTP — повний запис зі стиранням. OTP: етап `BLANK_CHECK`
    приймає не лише чисту мікросхему, а й сумісну з ефективним образом — `(вміст AND ціль) == ціль` для
    кожного слова, стани вставки «чиста / цикл / завершена з довільним `k`», вставка серійного номера
    чиста (новий номер) або записана (номер з мікросхеми).
  - **Серійні номери** (FR-046) витрачаються до запису (запис журналу перед записом слів вставки):
    невдала мікросхема з уже записаним номером при дописуванні іншим програматором зберігає свій номер, а
    перший програматор ніколи не видасть його вдруге. Ціна — пропуски в нумерації. Тоді дописується
    решта (лише 1→0, з перевіркою до подачі HV — задокументоване дописування, дозволене принципом III),
    незавершені вставки калібруються, усе верифікується; `warnings.RESUMED`. Повністю записана
    мікросхема → `CHIP_ALREADY_PROGRAMMED` без зміни лічильників.
  - **Обрив USB** (FR-023): операція не переривається — пакет і всі параметри вже в програматорі; лише
    `RUN` зупиняється. Скасування — тільки явне `OP_CANCEL`.
- **Rationale**: невдала OTP-мікросхема з незавершеним циклом лишається «рятівною»: та сама процедура
  повторної спроби довершує калібрування, коли причину (PA3/PA4 на платі, контакт pogo) усунуто — окремої
  команди «довершити калібрування» не потрібно. Завершення невдалої вставки «найкращим» значенням
  непомітно дало б виріб із неправильною частотою, тому за замовчуванням заборонене. Незалежність від
  USB потрібна для конвеєра й програмування в схемі: мікросхема не повинна страждати від збою кабелю чи
  драйвера PC. Повторна спроба покриває й висмикування USB у програматора з живленням від USB.
- **Alternatives**: окрема операція «довершити калібрування» — дублює логіку `PROGRAM`; скасування при
  обриві USB (попередня редакція) — ризик зіпсувати OTP через збій кабелю; повторна спроба без перевірки
  сумісності — суперечить принципу III.
- **Limits**: перекалібрування OTP із уже завершеною вставкою неможливе (`k` → `k'` вимагає 0→1;
  FR-045) — лише `PATCH` до сумісного значення. Сумісність перевіряється до подачі HV, тож несумісна
  мікросхема не змінюється.

## R18. Серійні номери: випадкові 64 біти

- **Decision**: вставка серійного номера (макрос free-pdk) завжди отримує **випадкове 64-бітне число**,
  окреме для кожної мікросхеми, в усіх режимах; лічильника, діапазонів і параметрів у пакеті немає.
  Генерація — HAL `hal_entropy.h` (сирі біти з апаратного шуму) + ядро:
  1. зібрати ≥ 256 сирих біт ентропії: на основній МК — апаратний RNG (вимога до вибору МК); на цілі
     налагодження F072 — молодші біти АЦП на датчику температури/VREFINT і розбіжність HSI14 відносно HSE;
  2. змішати разом з унікальним ID МК (96 біт UID STM32), номером запису журналу й лічильником у RAM
     через криптографічну хеш-функцію (BLAKE2s або SHA-256 з малим кодом) і взяти 64 біти;
  3. перевірка здоров'я джерела: сирі вибірки не постійні й не повторюються (тест повторів і пропорцій
     за NIST SP 800-90B у спрощеному вигляді); відмова джерела → операція не починається
     (`INTERNAL`), щоб не писати передбачуваний номер.
- **Rationale**: PADAUK у фірмовому програматорі використовує rolling code з початковим значенням і
  кроком, який скидається при кожному завантаженні файлу й не синхронізується між програматорами —
  джерело дублікатів. Випадкові 64 біти не потребують координації: ймовірність хоч одного збігу серед
  10⁶ мікросхем ≈ 3·10⁻⁸; підмішування UID гарантує різні послідовності на різних програматорах навіть
  при слабкому джерелі шуму.
- **Alternatives**: лічильник із діапазоном (попередні редакції, PADAUK rolling code) — потребує
  координації, скидається при перезавантаженні пакета; лише UID + лічильник без ентропії — передбачувано;
  послідовна нумерація для простежуваності — за потреби окремою фічею.
- **Копіювання** (FR-052): серійний номер еталона не розпізнається — прошивка, зібрана не free-pdk, може
  мати номер будь-де й будь-якої довжини. Локально — дублікат; з PC — пошук і заміна на користувачі
  (прочитати → замінити на вставку free-pdk у файлі → завантажити як звичайний пакет).
