kolod/padauk-programmer/.specify/memory/constitution.md

<!--
Sync Impact Report
==================
Version change: 1.2.0 → 1.3.0
Bump rationale: MINOR — еталонна платформа змінена: основна — STM32 з вищими ресурсами (конкретна
модель і розмітка сховища — окремою специфікацією); STM32F072C8T6 (плати Easy PDK) — ціль налагодження.
Принципи за змістом не змінились (уточнено формулювання IV).
Templates: змін не потребують.

--- Попередня редакція (1.2.0) ---
Version change: 1.1.0 → 1.2.0
Bump rationale: MINOR — у «Технічні обмеження» додано правило про референсні субмодулі
free-pdk (лише довідка, вміст не змінюється, проєкт від них не залежить). Принципи не змінювались.
Templates: змін не потребують.

--- Попередня редакція (1.1.0) ---
Version change: 1.0.0 → 1.1.0
Bump rationale: MINOR — розділ «Технічні обмеження» суттєво розширено політикою ліцензування
(CERN-OHL-S-2.0 для hardware, GPL-3.0-or-later для software, заборона копіювати файли
апаратної частини Easy PDK, SPDX-позначки). Принципи не змінювались.
Templates: змін не потребують. README.md створено з розділом «Ліцензії».

--- Попередня редакція (1.0.0) ---
Version change: (template, unversioned) → 1.0.0
Bump rationale: перше затвердження конституції — усі принципи та розділи визначені вперше.

Modified principles: — (шаблонні плейсхолдери замінено)
Added principles:
  I.   Розумний програматор, тонкий клієнт
  II.  Автономна робота
  III. Безпека мікросхеми та живлення (NON-NEGOTIABLE)
  IV.  Апаратна абстракція та переносимість
  V.   Версіонований протокол PC ⇄ програматор
  VI.  Перевірюваність
Added sections:
  - Технічні обмеження
  - Процес розробки та контроль якості
  - Governance
Removed sections: —

Templates:
  ✅ .specify/templates/plan-template.md      — Constitution Check генерується з цього файлу, змін не треба
  ✅ .specify/templates/spec-template.md      — без конфліктів
  ✅ .specify/templates/tasks-template.md     — примітку про тести узгоджено з принципом VI
  ✅ .specify/templates/checklist-template.md — без конфліктів
  ⚠ .specify/templates/commands/*.md         — каталогу немає, перевіряти нічого
  ⚠ README.md                                — у корені відсутній; створити при першій фічі

Deferred TODOs: немає.
-->

# PADAUK Smart Programmer Constitution

## Core Principles

### I. Розумний програматор, тонкий клієнт

Уся предметна логіка програмування мікросхем PADAUK MUST виконуватися у прошивці програматора:
таблиця параметрів мікросхем, визначення типу, послідовності erase → blank check → write →
verify → calibrate → fuse, патчинг калібрувальних вставок, вставка серійного номера, перевірка
захисного fuse.

- Клієнт на PC MUST лише: розбирати файли (Intel HEX / bin), передавати образ і параметри
  (тип МК, fuse, серійний номер, опції), запускати операції та показувати результат/прогрес.
- Клієнт MUST NOT містити знань про тайминги, напруги чи алгоритми конкретних мікросхем.
- Будь-яка операція, доступна з клієнта, MUST бути доступна й без нього (див. принцип II),
  якщо вона не потребує даних, яких у програматорі фізично немає.

**Обґрунтування:** на відміну від Easy PDK, де програматор «тупий», єдине джерело істини про
мікросхеми в прошивці робить можливою автономну роботу й усуває розбіжності версій PC ⇄ прошивка.

### II. Автономна робота

Програматор MUST повноцінно працювати без PC після того, як у нього завантажено образ.

- Образ прошивки цільової МК разом із метаданими (ID/тип МК, fuse, опції калібрування, лічильник
  серійних номерів, CRC) MUST зберігатися у внутрішній енергонезалежній пам'яті програматора.
- Цикл «вставив мікросхему → натиснув кнопку → отримав результат» MUST працювати без PC;
  стан і помилки MUST відображатися локально (світлодіоди, за наявності — інші індикатори).
- Режим копіювання MUST вміти без PC прочитати незахищену мікросхему-еталон у пам'ять і потім
  записувати цей образ у чисті мікросхеми того самого типу.
- Перед кожним автономним записом цілісність збереженого образу MUST перевірятися (CRC).
  Пошкоджений образ MUST NOT записуватися.
- Обхід захисту від читання (security fuse) не входить у межі проєкту.

**Обґрунтування:** програматор використовується як серійний інструмент на робочому місці.
Автономний режим — головна відмінність продукту.

### III. Безпека мікросхеми та живлення (NON-NEGOTIABLE)

- Кожен шлях виходу з операції (успіх, помилка, тайм-аут, відключення USB, скидання) MUST
  знімати VPP і VDD та переводити сигнальні лінії у високоімпедансний стан.
- Перед операцією MUST перевірятися, що VDD/VPP досягли заданих значень (вимірювання АЦП із
  допуском). Невдача — помилка, операція не продовжується.
- Генерація напруг MUST мати апаратне обмеження максимуму, незалежне від прошивки.
- Запис MUST NOT починатися, якщо ID мікросхеми не збігся з очікуваним типом образу.
- Для OTP-мікросхем запис MUST NOT виконуватися без пройденої перевірки на чистоту (крім
  явно задокументованого дописування, що лише обнуляє біти).
- Установка security fuse MUST вимагати явного дозволу в метаданих образу.

**Обґрунтування:** OTP-мікросхеми не можна відновити, а помилка напруги руйнує мікросхему.
Безпека має пріоритет над швидкістю й зручністю.

### IV. Апаратна абстракція та переносимість

Платформа МК змінна: основна — STM32 з достатніми ресурсами (модель обирається окремою специфікацією),
STM32F072C8T6 на платах Easy PDK — ціль налагодження.

- Ядро (протокол із мікросхемами, алгоритми, таблиця МК, формат сховища, обробка команд) MUST
  бути платформонезалежним C без звертань до регістрів/HAL конкретного МК.
- Доступ до заліза MUST іти через вузький HAL-інтерфейс: GPIO ліній IC, точні затримки,
  керування й вимірювання VDD/VPP, лічильник частоти для калібрування, енергонезалежне сховище,
  транспорт CDC, кнопка/індикація.
- Перенесення на інший МК MUST вимагати лише нової реалізації HAL і конфігурації збірки.
- Ядро MUST збиратися й запускатися на PC (для тестів і симуляції) з фіктивним HAL.

**Обґрунтування:** ресурсів F072 (64 КБ flash / 16 КБ RAM) не вистачає для автономного сховища й
нових функцій, тому основною буде потужніша STM32; заміна МК не повинна означати переписування логіки.

### V. Версіонований протокол PC ⇄ програматор

- Транспорт — USB CDC. Протокол MUST бути описаний у специфікації в `docs/` (формат кадрів,
  команди, коди помилок, тайм-аути) і MUST оновлюватися разом зі змінами коду.
- Кадри MUST мати контроль цілісності (CRC) і явну довжину. Програматор MUST повертати відповідь
  (успіх/помилка з кодом) на кожну команду.
- Обидві сторони MUST обмінюватися версією протоколу при підключенні. Несумісна мажорна версія —
  відмова з зрозумілим повідомленням.
- Довгі операції MUST повідомляти прогрес, щоб клієнт не потребував вгадувати тайм-аути.
- Зміни протоколу: несумісні → MAJOR, нові команди/поля → MINOR.

**Обґрунтування:** протокол — контракт між незалежно оновлюваними прошивкою і клієнтом.

### VI. Перевірюваність

- Логіка ядра (кодування/декодування протоколу, таблиця МК, патчинг калібрування й серійного
  номера, розбір HEX, формат сховища, CRC) MUST мати автоматичні модульні тести, що запускаються
  на PC.
- Bit-level послідовності для кожного сімейства МК MUST перевірятися тестами на фіктивному HAL
  проти еталонних трас, зафіксованих із задокументованих таймингів
  (`docs/easy-pdk-programmer-protocol.md`).
- Підтримку нового типу МК або сімейства MUST підтверджувати перевірка на реальній мікросхемі
  (read / write / verify / calibrate), результат якої записується у специфікацію фічі.
- Тайминги з документації вважаються мінімальними. Відхилення MUST бути обґрунтоване й
  перевірене на залізі.

**Обґрунтування:** помилки в протоколі з мікросхемою коштують зіпсованих OTP-чипів; більшість
логіки можна перевірити без заліза.

## Технічні обмеження

- **Основна платформа:** STM32 з USB FS device, ≥ 128 КБ flash, ≥ 32 КБ RAM, засобами керування й
  вимірювання VDD/VPP (ЦАП/АЦП або еквівалент), бажано апаратними RNG і CRC; конкретна модель, розмітка
  flash і кількість слотів пакетів визначаються окремою специфікацією й MUST бути задокументовані в її
  плані.
- **Ціль налагодження:** STM32F072C8T6 (плати Easy PDK, 64 КБ flash, 16 КБ RAM) — для перевірки
  протоколу, сховища й USB до появи основного заліза; функції, що не вміщуються, MAY вимикатися
  конфігурацією збірки для цієї цілі.
- **Мова прошивки:** C11, збирання `arm-none-eabi-gcc` + Makefile/CMake без прив'язки до IDE.
  Залежності від згенерованого CubeMX коду MUST обмежуватися реалізацією HAL.
- **Клієнт на PC:** кросплатформений (Windows, Linux, macOS), працює зі стандартним CDC-драйвером
  ОС без власних драйверів.
- **Обсяг образу:** до 4096 слів по 16 біт (максимум серед підтримуваних МК) плюс метадані.
- **Еталонні знання:** параметри МК, напруги й тайминги беруться з
  `docs/easy-pdk-programmer-protocol.md`, вихідних кодів free-pdk і даташитів у `docs/`.
  Нові значення MUST мати посилання на джерело або протокол вимірювань.
- **Ліцензії:** програмне забезпечення (`software/`) — GPL-3.0-or-later (сумісно з кодом
  free-pdk); апаратна частина (`hardware/`) — CERN-OHL-S-2.0. Тексти — `LICENSE-SOFTWARE` і
  `LICENSE-HARDWARE` у корені (копії в підкаталогах). Апаратний дизайн MUST створюватися
  самостійно: файли апаратної частини Easy PDK (CC-BY-SA-4.0) MUST NOT копіюватися чи
  модифікуватися в `hardware/`, інакше дизайн стає похідним і мусить лишатися під CC-BY-SA-4.0.
  Нові файли SHOULD містити SPDX-позначку (`SPDX-License-Identifier`).
- **Референсні субмодулі:** `easy-pdk-programmer-software` і `easy-pdk-programmer-hardware`
  підключені лише як довідкові матеріали. Їхній вміст MUST NOT змінюватися в межах цього проєкту
  (жодних правок, патчів чи локальних комітів усередині субмодулів), а збірка й тести проєкту
  MUST NOT від них залежати. Потрібний код переноситься в `software/` зі збереженням авторства та
  ліцензії GPL-3.0. Оновлення вказівника субмодуля на новіший upstream-коміт допускається лише
  окремим комітом з явним обґрунтуванням.

## Процес розробки та контроль якості

- Кожна фіча проходить цикл Spec Kit: specify → (clarify) → plan → tasks → implement.
  План MUST містити розділ Constitution Check із відповідністю принципам I–VI.
- Кожна зміна MUST проходити збірку прошивки, збірку ядра на PC і всі модульні тести.
- Зміни, що зачіпають генерацію напруг, послідовності для мікросхем або сховище, MUST проходити
  перевірку на реальному залізі перед злиттям у `main`.
- Зміни протоколу або структури сховища MUST супроводжуватися оновленням документації в `docs/`
  і номера версії.
- Відхилення від принципів MUST фіксуватися в таблиці Complexity Tracking плану з обґрунтуванням.

## Governance

- Конституція має пріоритет над іншими практиками й шаблонами проєкту. У разі конфлікту шаблон
  або план приводиться у відповідність до конституції.
- Поправки вносяться змінами цього файлу з оновленим Sync Impact Report і синхронізацією
  залежних шаблонів у `.specify/templates/`.
- Версіонування конституції — семантичне: MAJOR — вилучення або несумісне переозначення принципу;
  MINOR — новий принцип/розділ чи суттєве розширення; PATCH — уточнення формулювань.
- Відповідність перевіряється на кожному плані (Constitution Check) і під час рев'ю змін.
  Принцип III не може бути відхилений через Complexity Tracking.

**Version**: 1.3.0 | **Ratified**: 2026-10-09 | **Last Amended**: 2026-10-09
