kolod/padauk-programmer/specs/001-pc-programmer-protocol/checklists/requirements.md

# Specification Quality Checklist: Протокол обміну PC ⇄ програматор

**Purpose**: Validate specification completeness and quality before proceeding to planning
**Created**: 2026-10-09
**Feature**: [spec.md](../spec.md)

## Content Quality

- [x] No implementation details (languages, frameworks, APIs)
- [x] Focused on user value and business needs
- [x] Written for non-technical stakeholders
- [x] All mandatory sections completed

## Requirement Completeness

- [x] No [NEEDS CLARIFICATION] markers remain
- [x] Requirements are testable and unambiguous
- [x] Success criteria are measurable
- [x] Success criteria are technology-agnostic (no implementation details)
- [x] All acceptance scenarios are defined
- [x] Edge cases are identified
- [x] Scope is clearly bounded
- [x] Dependencies and assumptions identified

## Feature Readiness

- [x] All functional requirements have clear acceptance criteria
- [x] User scenarios cover primary flows
- [x] Feature meets measurable outcomes defined in Success Criteria
- [x] No implementation details leak into specification

## Notes

- Уточнення закрито 2026-10-09: FR-016 — один активний пакет; FR-030 — без протоколу Easy PDK,
  можливий CLI-клієнт у стилі `easypdkprog` поверх нового протоколу.
- Транспорт USB CDC і вимоги до виявлення помилок (FR-008) згадано як обмеження, задане
  користувачем і конституцією (принцип V); конкретні алгоритми й формат кадрів винесено в план.
- Ітерація валідації 1: усі пункти, крім уточнень, пройдено.
- Ітерація валідації 2: усі пункти пройдено; специфікація готова до `/speckit-plan`.
