kolod/padauk-programmer/docs/easy-pdk-programmer-protocol.md

# Easy PDK Programmer — опис протоколів PC ⇄ програматор ⇄ мікросхема PADAUK

Документ складено на основі аналізу вихідних кодів `easy-pdk-programmer-software`
(хост-утиліта `easypdkprog` v1.3, прошивка STM32F072 SW 1.3 / HW 1.2, протокол **1.3**)
та схеми `easy-pdk-programmer-hardware` (rev 1.2).

Мета — дати достатньо інформації, щоб реалізувати сумісний програматор на іншій апаратній базі
(інший МК, інші ЦАП/джерела напруги) так, щоб з ним працювала **оригінальна** утиліта `easypdkprog`,
або написати власну хост-програму.

Посилання на код (для перевірки деталей):

| Що | Файл |
|---|---|
| Коди команд / відповідей / помилок | [Firmware/source/Src/fpdkproto.h](../easy-pdk-programmer-software/Firmware/source/Src/fpdkproto.h) |
| Обробка USB-пакетів у прошивці | [Firmware/source/Src/fpdkusb.c](../easy-pdk-programmer-software/Firmware/source/Src/fpdkusb.c) |
| Низькорівневий протокол з МК PADAUK | [Firmware/source/Src/fpdk.c](../easy-pdk-programmer-software/Firmware/source/Src/fpdk.c) |
| UART-міст для режиму виконання | [Firmware/source/Src/fpdkuart.c](../easy-pdk-programmer-software/Firmware/source/Src/fpdkuart.c) |
| Хост: формування пакетів | [fpdkcom.c](../easy-pdk-programmer-software/fpdkcom.c) |
| Хост: алгоритм запису/читання | [easypdkprog.c](../easy-pdk-programmer-software/easypdkprog.c) |
| Хост: таблиця мікросхем | [fpdkicdata.c](../easy-pdk-programmer-software/fpdkicdata.c) |
| Хост: калібрування | [fpdkiccalib.c](../easy-pdk-programmer-software/fpdkiccalib.c) |
| Хост: вставка серійного номера | [fpdkicserial.c](../easy-pdk-programmer-software/fpdkicserial.c) |

---

## 1. Архітектура

```
 ┌──────────┐  USB CDC (віртуальний COM)   ┌──────────────────┐   PA3/PA4/PA5/PA6/PA0/PA7, VDD, GND  ┌────────────┐
 │    PC    │ ───────────────────────────► │   Програматор    │ ───────────────────────────────────► │  PADAUK IC │
 │easypdkprog│ ◄─────────────────────────── │ (STM32F072 + ЦАП │ ◄─────────────────────────────────── │ PFS/PMS/.. │
 └──────────┘   пакети "cmd,len,payload"   │  + підсилювачі)  │   bit-bang послідовний протокол      └────────────┘
                                           └──────────────────┘
```

Розподіл відповідальності:

* **PC** знає все про конкретну мікросхему (таблиця параметрів: розрядність, напруги, тайминги блоків),
  розбирає HEX, вставляє калібрувальні вставки та серійний номер, керує послідовністю
  «стерти → перевірити чистоту → записати → верифікувати → калібрувати → записати fuse».
* **Програматор** — «тупий» виконавець: зберігає буфер 4096 слів, вміє генерувати VDD/VPP із заданими
  значеннями в мілівольтах і виконувати примітивні операції (probe / blank check / erase / read / write /
  verify / calibrate / run). Усі параметри операції приходять від PC у кожній команді.
* **Мікросхема** програмується через 4 лінії: VDD, GND, PA5 (VPP — висока напруга), PA3 (тактування),
  PA6 та/або PA4 (дані). Окремі сімейства і режими додатково використовують PA0 і PA7.

---

## 2. Транспорт PC ⇄ програматор

### 2.1 USB

* Клас USB CDC ACM (віртуальний COM-порт). Швидкість (baud) ігнорується, хост виставляє 115200 8N1 без
  керування потоком.
* VID/PID: `0x0483` / `0x5740` (стандартний STM32 Virtual COM Port), Manufacturer `free-pdk.github.io`,
  Product `Easy PDK Programmer`, Serial `1234567855AA` (на macOS хост шукає саме
  `/dev/tty.usbmodem1234567855AA*`; на Linux — `/dev/ttyACM*`, на Windows — `COM1..COM999`).
* **Обов'язково:** прошивка обробляє команди лише коли хост виставив **DTR**
  (`SET_CONTROL_LINE_STATE`, біт 0). Кожна зміна стану лінії (відкриття/закриття порту):
  * скидає приймальний буфер пакетів;
  * заповнює буфер даних IC значенням `0xFF`;
  * якщо IC була запущена командою `X` — вимикає UART та VDD.

### 2.2 Формат пакетів

Усі багатобайтові поля — **little-endian**. Напруги — `uint32` у **мілівольтах**.

**PC → програматор (команда):**

| Байт | Поле | Опис |
|---|---|---|
| 0 | `cmd` | ASCII-код команди (див. 2.4) |
| 1 | `len` | довжина payload, 0…255 |
| 2… | `payload` | `len` байтів |

**Програматор → PC (відповідь):**

| Байт | Поле | Опис |
|---|---|---|
| 0 | `rsp` | `'A'` (0x41) — ACK, `'E'` (0x45) — помилка, `'D'` (0x44) — дані з UART IC |
| 1–2 | `len` | `uint16` довжина payload |
| 3… | `payload` | `len` байтів |

Правила:

* Програматор накопичує байти, поки не набереться `2 + len`, тоді виконує команду (синхронно, блокуюче)
  і зсуває буфер. Розмір приймального буфера — 258 байт.
* Відповідь `'E'` завжди має `len = 0`. Вона надсилається, якщо: невідома команда, payload коротший за
  потрібний, вихід за межі буфера, невдале калібрування, помилка встановлення напруги в `X`.
* **Помилки роботи з мікросхемою** повертаються не через `'E'`, а як `'A'` з 16-бітним кодом результату
  (див. 2.3).
* `'D'` пакети надсилаються асинхронно (лише в режимі виконання IC) і можуть з'явитися між відповідями.
* Хост перед першою командою вичитує й відкидає все, що є в порту.

### 2.3 Результат операцій з IC (16 біт)

Команди `Z`, `E`, `R`, `W`, `V` повертають `uint16`:

| Значення | Ім'я | Значення |
|---|---|---|
| `== icid` | — | успіх (повертається той самий 12-бітний ID, що й був переданий) |
| `0xFFFF` | `FPDK_ERR_UKNOWN` | невідома помилка / некоректні параметри (напр. `write_block_size` 0 або >8, erase для OTP) |
| `0xFFFE` | `FPDK_ERR_VPPVDD` | не вдалося подати VPP/VDD для входу в режим програмування |
| `0xFFFD` | `FPDK_ERR_HVPPHVDD` | не вдалося подати «робочі» (високі) VPP/VDD |
| `0xFFFC` | `FPDK_ERR_CMDRSP` | ID у відповіді мікросхеми не збігся з очікуваним |
| `0xFFFB` | `FPDK_ERR_VERIFY` | розбіжність при верифікації |
| `0xFFFA` | `FPDK_ERR_NOTBLANK` | мікросхема не чиста |

Хост вважає помилкою будь-яке значення `>= 0xFFF0` і бере текст за індексом `value & 0x0F`.

### 2.4 Команди

Тайм-аути — це скільки хост чекає на відповідь; **сумісна реалізація повинна вкладатися в них**.

| Cmd | Ім'я | Payload запиту | Відповідь `'A'` | Тайм-аут хоста |
|---|---|---|---|---|
| `I` | GETVERINFO | — | ASCII-рядок версії | 50 мс |
| `L` | SETLED | `u8 mask` | — | 50 мс |
| `B` | GETBUTTON | — | `u8 pressed` | 50 мс |
| `O` | SETVOLTOUT | `u32 vdd_mV, u32 vpp_mV` | — | 50 мс |
| `U` | GETVOLTAGES | — | `u32 vref_mV, u32 vdd_mV, u32 vpp_mV` | 50 мс |
| `S` | SETBUF | `u16 byte_offs, u8 data[]` | — | 50 мс |
| `G` | GETBUF | `u16 byte_offs, u16 len` | `data[len]` | 50 мс |
| `P` | PROBEIC | — | `u32 rsp, u32 vpp_mV, u32 vdd_mV, u32 type` | 3500 мс |
| `Z` | BLANKCKIC | 28 байт, див. нижче | `u16 result` | 1000 мс |
| `E` | ERASEIC | 20 байт | `u16 result` | 2000 мс |
| `R` | READIC | 27 байт | `u16 result` | 1000 мс |
| `W` | WRITEIC | 30 байт | `u16 result` | **1000 мс** |
| `V` | VERIFYIC | 32 байти | `u16 result` | 1000 мс |
| `C` | CALIBRATEIC | 16 байт | `u32 value, u32 freq_Hz` | 10000 мс |
| `X` | EXECUTEIC | `u32 vdd_mV` | — | 50 мс |
| `Q` | STOPIC | — | — | 50 мс |
| `D` | DBGDAT | `u8 data[]` | **відповіді немає** | — |

#### `I` — версія

Відповідь — рядок без нуля в кінці:

```
FREE-PDK EASY PROG - HW:1.2 SW:1.3 PROTO:1.3\n
```

Хост парсить його `sscanf("FREE-PDK EASY PROG - HW:%u.%u SW:%u.%u PROTO:%u.%u\n")` і **вимагає точного
збігу PROTO 1.3**, інакше «Programmer protocol mismatch». HW/SW можуть бути будь-якими.

#### `L` — світлодіоди

`mask`: біт0 — LED1, біт1 — LED2, біт2 — LED3. (Прошивка використовує LED1 як індикатор прийому UART,
LED2 — передачі UART, LED3 — «йде операція з IC».)

#### `B` — кнопка

`1`, якщо кнопка натиснута стабільно > 10 мс, інакше `0`.

#### `O` / `U` — ручне керування напругами

`O` встановлює VDD і VPP (вмикає всі LED). `U` повертає виміряні АЦП значення:
опорну напругу живлення МК, VDD і VPP (мВ). Ці команди `easypdkprog` не використовує, вони для
тестування (`easypdkprogtest`).

#### `S` / `G` — буфер даних

Буфер програматора — `uint16 buf[0x1000]` (8192 байти), слова у little-endian, без ініціалізації після
відкриття порту заповнений `0xFFFF`.

* `S`: `byte_offs` — зміщення **в байтах**, далі дані (хост шле шматками по 252 байти).
* `G`: читання `len` байт починаючи з `byte_offs`. Відповідь може бути довшою за 255 байт (поле довжини
  16-бітне), але хост на Windows просить по 63 байти.
* Вихід за межі → `'E'`.

#### `P` — пошук мікросхеми

Програматор послідовно пробує сімейства (див. 4.6) при VPP = 4.5 В, VDD = 2.0 В.

| Поле | Опис |
|---|---|
| `rsp` | сира відповідь ID мікросхеми (`& 0x7FFFFFFF`); `0` — нічого не знайдено |
| `vpp_mV`, `vdd_mV` | напруги, на яких знайдено (4500 / 2000) |
| `type` | тип протоколу: `0xF0` (будь-яка FLASH), `0x12`, `0x22`, `0x21`, `0x31` |

Як хост перетворює `rsp` у 12-бітний ID — див. 4.6.

#### Спільний заголовок команд `Z`, `E`, `R`, `W`, `V`

| Зміщення | Тип | Поле |
|---|---|---|
| 0 | `u16` | `icid` — очікуваний 12-бітний ID |
| 2 | `u8` | `type` — тип протоколу (`0x12`, `0x21`, `0x22`, `0x31`, `0xF1`, `0xF2`) |
| 3 | `u32` | `vdd_cmd` — VDD під час входу в режим і передачі команди |
| 7 | `u32` | `vpp_cmd` — VPP під час входу в режим і передачі команди |
| 11 | `u32` | `vdd_hv` — VDD під час операції (read/erase/write) |
| 15 | `u32` | `vpp_hv` — VPP під час операції |

> ⚠️ Особливість хоста: у `Z`, `R`, `V` байт 12 (другий байт `vdd_read`) хост заповнює значенням
> `vdd_cmd >> 8`. На всіх відомих мікросхемах `vdd_cmd == vdd_read`, тому це не проявляється, але
> сумісна прошивка має просто брати байти як є.

#### `Z` — перевірка на чистоту (28 байт)

| Зміщення | Тип | Поле |
|---|---|---|
| 0–18 | | спільний заголовок (`vdd_hv/vpp_hv` = напруги читання) |
| 19 | `u8` | `addr_bits` |
| 20 | `u8` | `data_bits` |
| 21 | `u16` | `count` — скільки слів перевіряти, починаючи з адреси 0 |
| 23 | `u8` | `excl_first` — пропустити адресу 0 |
| 24 | `u16` | `excl_start` |
| 26 | `u16` | `excl_end` |

Перевіряються адреси `p` = 0…count-1, крім `p == 0` (якщо `excl_first`) і крім
`excl_start <= p <= excl_end` (**обидві межі включно**). Чисте слово = всі `data_bits` одиниць.

#### `E` — стирання (20 байт, лише FLASH)

| Зміщення | Тип | Поле |
|---|---|---|
| 0–18 | | спільний заголовок (`vdd_hv/vpp_hv` = напруги стирання) |
| 19 | `u8` | `erase_clocks` |

#### `R` — читання (27 байт)

| Зміщення | Тип | Поле |
|---|---|---|
| 0–18 | | спільний заголовок (`vdd_hv/vpp_hv` = напруги читання) |
| 19 | `u16` | `addr` — початкова адреса в IC (у словах) |
| 21 | `u8` | `addr_bits` |
| 22 | `u16` | `data_offs` — початковий індекс у буфері програматора (**у словах**) |
| 24 | `u8` | `data_bits` |
| 25 | `u16` | `count` — кількість слів |

Прочитані слова кладуться в `buf[data_offs + i]`, далі хост забирає їх через `G`.

#### `W` — запис (30 байт)

Як `R` (напруги 11/15 — запису), плюс:

| Зміщення | Тип | Поле |
|---|---|---|
| 27 | `u8` | `block_size` — слів на один цикл запису (1…8) |
| 28 | `u8` | `clock_groups` — кількість груп програмуючих імпульсів |
| 29 | `u8` | `clocks_per_group` — імпульсів у групі |

Дані беруться з `buf[data_offs…]`.

#### `V` — верифікація (32 байти)

Як `R`, плюс:

| Зміщення | Тип | Поле |
|---|---|---|
| 27 | `u8` | `excl_first` — пропустити IC-адресу 0 (`addr + p == 0`) |
| 28 | `u16` | `excl_start` (відносно `p`, включно) |
| 30 | `u16` | `excl_end` (включно) |

Порівнюються `data_bits` молодших бітів. Якщо очікуване слово з буфера = всі одиниці (`0xFFFF & mask`),
воно вважається «джокером» і **не перевіряється** (бо незаписані/пропущені слова).

#### `C` — калібрування (16 байт)

| Зміщення | Тип | Поле |
|---|---|---|
| 0 | `u32` | `type`: 1 — IHRC, 2 — ILRC, 3 — BandGap |
| 4 | `u32` | `vdd_mV` — напруга живлення IC під час калібрування |
| 8 | `u32` | `freq_Hz` — цільова частота SYSCLK |
| 12 | `u32` | `mult` — тактів CPU на один період сигналу (= 7) |

Відповідь: `u32 value` (значення регістра підстроювання, використовується лише молодший байт) і
`u32 freq_Hz` — досягнута частота (для BG = 0). Детально — розділ 6.

#### `X` / `Q` / `D` — виконання програми в IC

* `X`: подати на IC VDD = `vdd_mV` (VPP = 0), увімкнути UART-міст з автовизначенням швидкості. ACK.
* `Q`: вимкнути UART, VDD = 0, погасити LED. ACK.
* `D` (PC → програматор): байти передаються в IC по UART. Відповіді немає (щоб не змішувати з вхідним потоком).
* `D` (програматор → PC): байти, прийняті від IC.

Деталі — розділ 7.

---

## 3. Апаратна частина програматора

### 3.1 Підключення до мікросхеми

| Сигнал IC | Напрям | Пін STM32 (оригінал) | Призначення |
|---|---|---|---|
| **VDD** | вихід | ЦАП1 (PA4) → ОП ×2 | живлення IC, 0…6.26 В, програмовано |
| **GND** | — | — | загальний |
| **PA5** | вихід | ЦАП2 (PA5) → ОП ×4.23 | **VPP**, 0…13.27 В, програмовано |
| **PA3** | вихід / вхід | PB3 (GPIO / SPI1_SCK) | CLK протоколу; у калібруванні — вихід IC |
| **PA6** | двонапр. | PB5 (GPIO / SPI1_MOSI) | DAT (FLASH: двонапрямлений; OTP: дані з IC) |
| **PA4** | вихід / вхід | PB4 (GPIO / SPI1_MISO) | дані в IC для OTP; у калібруванні — вхід IC |
| **PA0** | двонапр. | PB6 (GPIO / USART1_TX) | CLK2 для OTP3_1; UART → IC; вихід компаратора при BG-калібруванні |
| **PA7** | двонапр. | PB7 (GPIO / USART1_RX) | «commit» для OTP3_1; UART ← IC |

Всі сигнальні лінії мають послідовні резистори 100 Ом, на VDD і VPP — 100 нФ на землю біля панельки.
Коли лінії не використовуються, вони переводяться у вхід (DAT/PA6 і CLK/PA3 — з підтяжкою до землі).

Вимоги до нової апаратури:

* **VDD**: 0…≥6.0 В (максимум, що використовується, — 5.8 В), установка з кроком ~10 мВ (оригінал — 12-біт
  ЦАП: `code = mV * 4095 / 6260`). Має швидко встановлюватися: прошивка чекає лише 100 мкс…10 мс.
* **VPP**: 0…≥11.5 В (максимум у таблиці — 11.0 В для PMS154), `code = mV * 4095 / 13270`. Обов'язково
  має опускатися до 0 В (оригінал має ОП з живленням +15 В / −2.4 В; 15 В — від MT3608, −2.4 В —
  діодна накачка від ШІМ 50 кГц на PA3 STM32).
* Обидва виходи — керовані джерела напруги без зворотного зв'язку від АЦП (АЦП лише для `U`).
  Оригінал вимірює VDD і VPP через дільники 100k/20k (×6) на PB1 та PB0.
* Логічні рівні: STM32 працює від 3.3 В, лінії PB3…PB7 — 5V-tolerant. Під час запису VDD мікросхеми
  піднімається до 5.3…5.8 В, тож ваші входи мають витримувати ~6 В (або ставте захист/рівневі
  перетворювачі, які не спотворюють тайминги ~1 мкс).
* Для калібрування потрібен **апаратний лічильник/таймер, тактований зовнішнім сигналом** (в оригіналі —
  SPI1 у slave-режимі з DMA + 32-біт таймер на 48 МГц). Див. розділ 6.
* Для режиму виконання — UART з автовизначенням швидкості (або програмна реалізація).

### 3.2 Програмні затримки

Базова затримка `DelayUS(n)` в оригіналі — цикл `10*n` ітерацій на 48 МГц, тобто ≈ n мкс.
Імпульс CLK: `CLK=1; delay 1 мкс; CLK=0`. Низький рівень триває лише стільки, скільки виконується
код між імпульсами (сотні нс). Тобто фактична швидкість біта ≈ 0.5…1 Мбіт/с. Довші тайминги (15/30/40 мкс,
мілісекунди при стиранні) — це **обов'язкові** тривалості програмуючих імпульсів.

---

## 4. Протокол програматор ⇄ мікросхема

### 4.1 Типи протоколу (сімейства)

| Код | Ім'я | Мікросхеми | CLK | Дані → IC | Дані ← IC |
|---|---|---|---|---|---|
| `0xF1` | FLASH_1 | PFS154, PFS173 | PA3 | PA6 | PA6 |
| `0xF2` | FLASH_2 | PFS172 | PA3 | PA6 | PA6 |
| `0x12` | OTP1_2 | PMS150C/PMS15A, PMS154B/C, MCU390 | PA3 | PA4 | PA6 |
| `0x21` | OTP2_1 | PMS133/PMS134 | PA3 | PA4 | PA6 |
| `0x22` | OTP2_2 | PMS131, PMS132, PMS152, PMS171B | PA3 | PA4 | PA6 |
| `0x31` | OTP3_1 | PMC251, PMS271/PMC271 (лише читання) | PA3 (команда), PA0 (адреса/дані) | PA4 | PA6 |
| `0xF0` | FLASH (generic) | лише для `P` (probe) | PA3 | PA6 | PA6 |

VPP завжди подається на **PA5**.

### 4.2 Елементарні операції (bit-bang)

Всі послідовності передаються **старшим бітом вперед (MSB first)**.

**Передача біта** (програматор → IC):

```
DATA ──X═══════ bit ═══════X═══ next bit ═══
CLK  ────┐  ┌────┐  ┌───── ...
         └──┘    └──┘           (точніше: 0 → ↑ → 1 мкс → ↓)
     ____/‾‾‾‾\____/‾‾‾‾\___
         ≥1 мкс
```

1. виставити DATA = bit;
2. CLK = 1, чекати 1 мкс;
3. CLK = 0.

Дані стабільні весь час високого рівня CLK. Для OTP-сімейств після останнього біта лінія даних (PA4)
примусово скидається в 0; для FLASH лінія PA6 залишається з останнім бітом.

**Прийом біта** (IC → програматор):

1. CLK = 1, чекати 1 мкс;
2. прочитати лінію даних (PA6, або PA6 при CLK2 для OTP3_1);
3. CLK = 0.

Результат збирається як `value = (value << 1) | bit` — перший прийнятий біт старший.

**«Додатковий такт»** — один імпульс CLK (1 мкс) без зміни даних.

Для OTP3_1 є варіанти з CLK2 = PA0 замість PA3 і «commit»: `PA7 = 1; 1 мкс; PA7 = 0;` + один імпульс CLK2.

### 4.3 Вхід у режим програмування та вихід

**Вхід** (`Enter(type, vpp_cmd, vdd_cmd)`):

1. PA3 (CLK) → вихід, 0.
2. VPP = `vpp_cmd`, чекати **100 мкс**.
3. VDD = `vdd_cmd`, чекати **500 мкс**.
4. FLASH: PA6 → вихід, 0.
   OTP: PA6 → вхід (pull-down), PA4 → вихід, 0. Для OTP3_1 ще PA0 і PA7 → вихід, 0.

Тобто VPP подається **раніше** VDD — це і є ознака входу в режим програмування.

**Вихід** (`Leave(extra)`):

1. PA6 → вхід (pull-down), PA4, PA0, PA7 → входи.
2. VDD = 0, VPP = 0 (без затримок між ними).
3. Чекати **10 мс + extra** (після erase/write `extra` = 100 мс). Прошивка явно коментує: обов'язково
   чекати після виходу перед наступною командою.
4. PA3 → вхід (pull-down).

**Зміна напруг усередині режиму:**

* для читання (якщо `vdd_hv/vpp_hv` відрізняються від `cmd`): VDD → чекати 1 мс, VPP → чекати 1 мс;
* для запису/стирання: VDD → чекати **10 мс**, VPP → чекати **10 мс**.

> Для PFS172 `vpp_hv` = 0 В: під час читання/запису/стирання VPP **знімається** до нуля, а VDD піднімається.

### 4.4 Команда (преамбула)

| Тип | Що передається | Відповідь |
|---|---|---|
| FLASH_1, FLASH (probe) | 32 біти `0xA5A5A5A0 \| cmd` на PA6 | PA6 → вхід, прийняти **16** біт (ACK), PA6 → вихід, +1 такт |
| FLASH_2 | 32 біти `0xA5A5A5A0 \| cmd` на PA6 | прийняти **17** біт, PA6 → вихід, +1 такт |
| OTP1_2 | 32 біти `0xA5A5A5A0 \| cmd` на PA4 | — |
| OTP2_1, OTP2_2 | 32 біти `0x5A5A5A50 \| cmd` на PA4 | — |
| OTP3_1 | 32 біти `0x5A5A5A5A`, потім 27 нульових біт на PA4 (такт PA3); `cmd` не передається | — |

Коди `cmd` (4 біти):

| Операція | FLASH_1 / OTP | FLASH_2 |
|---|---|---|
| Read | `0x6` | `0xC` |
| Write | `0x7` | `0x7` |
| Erase | `0x3` | `0x5` |

**ACK у FLASH:** молодші 12 біт прийнятого слова = ID мікросхеми (`ack & 0xFFF == icid`).
Якщо не збіглося → вихід з режиму і `FPDK_ERR_CMDRSP`.

### 4.5 Отримання ID для OTP (`GetID`)

У OTP-сімейств команда не дає ACK. ID отримують окремим проходом **перед кожною** операцією
Read/Write/Verify/BlankCheck:

1. `Enter(vpp_cmd, vdd_cmd)`.
2. Команда **Write** (`0x7`).
3. Прийняти N біт:
   * OTP1_2, OTP2_2: `N = 2*data_bits + 12`;
   * OTP2_1: `N = data_bits + 12`;
   * OTP3_1: `N = data_bits + 1 + 12`, такт **PA0** (CLK2), дані на PA6.
4. `Leave()` — запис так і не починається (VPP/VDD знімаються до подачі високих напруг).
5. `ID = value & 0xFFF` (останні 12 прийнятих біт) має дорівнювати `icid`, інакше `FPDK_ERR_CMDRSP`.

Для накопичення використовується 32-бітна змінна, тож при N > 32 зберігаються лише останні 32 біти.

### 4.6 Probe (автовизначення)

Програматор пробує по черзі, кожного разу повний Enter/Leave при VPP = 4.5 В, VDD = 2.0 В:

1. FLASH: команда Read (`0x6`) з 16-бітним ACK; ненульовий ACK → тип `0xF0`.
2. OTP1_2 з `data_bits = 16` (N = 44); якщо `rsp & 0xFFFF != 0` → `0x12`.
3. OTP2_2 з `data_bits = 16` → `0x22`.
4. OTP2_1 з `data_bits = 16` (N = 28) → `0x21`.
5. OTP3_1 з `data_bits = 16` (N = 29) → `0x31`.

Хост перетворює `rsp` у 12-бітний ID так:

* FLASH: `id = rsp & 0xFFF`; якщо не знайдено в таблиці — `(rsp << 1) & 0xFFF` (PFS172 дає 17-бітний ACK,
  а probe читає лише 16).
* OTP: оскільки реальна розрядність слова невідома, а читалося як для 16 біт, пробуються
  `codebits` = 16, 15, 14, 13 зі зсувом `rsp >> (k * (16 - codebits))`, де `k = 1` для OTP2_1/OTP3_1
  і `k = 2` для OTP1_2/OTP2_2. Збіг шукається за (`id12`, `type`, `codebits`).

### 4.7 Читання слова

| Тип | Послідовність для однієї адреси |
|---|---|
| FLASH_1, FLASH_2 | `addr` (`addr_bits`) на PA6 → PA6 вхід → CLK = 1, **5 мкс** → прийняти `data_bits` (перший біт читається, поки CLK ще високий після цих 5 мкс + 1 мкс) → PA6 вихід → +1 такт |
| OTP1_2, OTP2_x | `addr` на PA4 (такт PA3) → прийняти `data_bits` з PA6 |
| OTP3_1 | `addr` на PA4 з тактом **PA0** → commit (PA7 імпульс 1 мкс + 1 такт PA0) → прийняти `data_bits` з PA6 з тактом PA0 |

**Повна операція READ:**

```
[OTP: GetID-прохід з перевіркою ID]
Enter(vpp_cmd, vdd_cmd)
SendCommand(Read)                → для FLASH: перевірка ACK
[якщо hv ≠ cmd: VDD=vdd_hv, 1 мс; VPP=vpp_hv, 1 мс]
for p in 0..count-1:  buf[data_offs+p] = ReadAddr(addr+p)
Leave(0)
```

BLANKCHECK і VERIFY — ідентичні, лише замість збереження — порівняння (адреси для BLANKCHECK завжди
з 0). При першій невідповідності цикл переривається.

### 4.8 Стирання (лише FLASH)

```
Enter(vpp_cmd, vdd_cmd)
SendCommand(Erase: 0x3 / FLASH_2: 0x5) → перевірка ACK
VDD = vdd_hv, 10 мс;  VPP = vpp_hv, 10 мс
repeat erase_clocks:
    CLK=1, чекати 5 мс   (FLASH_2: 40 мс)
    CLK=0, 1 мкс
    CLK=1, 1 мкс
    CLK=0, 4 мкс
+1 такт
Leave(100 мс)
```

PA6 весь цей час — вихід у 0.

### 4.9 Запис

**Загальний алгоритм WRITE:**

```
[OTP: GetID-прохід з перевіркою ID]
Enter(vpp_cmd, vdd_cmd)
SendCommand(Write 0x7)             → для FLASH: перевірка ACK
VDD = vdd_hv, 10 мс;  VPP = vpp_hv, 10 мс
for p = 0; p < count; p += block_size:
    wbuf[0..block_size-1] = 0xFFFF
    скопіювати min(block_size, count-p) слів у wbuf, починаючи з індексу (addr % block_size)
    якщо в wbuf хоч одне слово ≠ всі одиниці (по data_bits):
        WriteBlock(aligned_addr = ((addr+p) / block_size) * block_size, wbuf)
    чекати 100 мкс
Leave(100 мс)
```

Порожні (всі одиниці) блоки пропускаються, бо запис лише переводить біти 1 → 0. Це ж дозволяє
дописувати поверх уже записаних даних, якщо змінюються лише одиниці на нулі (використовується при
калібруванні та записі fuse).

**WriteBlock — FLASH_1** (PFS154/PFS173: block_size = 4, groups = 1, clocks = 8):

```
for i in 0..block_size-1: send(wbuf[i], data_bits)   на PA6
send(aligned_addr, addr_bits)                         на PA6
PA6 → вхід;  4 мкс
repeat clock_groups:
    repeat clocks_per_group:  CLK=1 15 мкс; CLK=0 15 мкс
    +1 такт;  4 мкс
PA6 → вихід
25 мкс
```

**WriteBlock — FLASH_2** (PFS172: block_size = 4, groups = 1, clocks = 4) — **адреса перед даними**:

```
send(aligned_addr, addr_bits)                         на PA6
for i: send(wbuf[i], data_bits)                       на PA6
PA6 → вхід
repeat clock_groups:
    +1 такт; 2 мкс
    repeat clocks_per_group:  CLK=1 40 мкс; CLK=0 40 мкс
    repeat 4:                 CLK=1 2 мкс;  CLK=0 2 мкс
PA6 → вихід
25 мкс
```

**WriteBlock — OTP1_2 / OTP2_x** (block_size = 2, groups = 1, clocks = 8):

```
for i: send(wbuf[i], data_bits)                       на PA4 (такт PA3)
send(aligned_addr, addr_bits)                         на PA4
+1 такт;  4 мкс
repeat clock_groups:
    CLK = 1   (утримується!)
    repeat clocks_per_group:  PA4=1 30 мкс; PA4=0 30 мкс     ← програмуючі імпульси по лінії даних
    CLK = 0;  4 мкс
    +1 такт;  4 мкс
25 мкс
```

**OTP3_1** — запис у прошивці не реалізований (TODO).

**Оцінка часу:** PFS173 (3072 слова) ≈ 768 блоків × (~0.3 мс імпульсів + 0.1 мс + передача) ≈ 0.4 с.
Хост дає на `W` лише 1000 мс — нова реалізація не повинна бути суттєво повільнішою.

### 4.10 Fuse і захист

* Fuse-слово — **останнє слово** пам'яті програм (`codewords - 1`).
* Біт 0 fuse = 0 вмикає захист від читання (хост скидає його лише з `--allowsecfuse`).
* Fuse пишеться **окремою** командою `W` останньою, після калібрування.
* Області `exclude_code_start…end` — службові: у FLASH-мікросхемах 0x7E0…0x7EF (PFS154/PFS172) і
  0xBE0…0xBEF (PFS173) — OTP-область із заводськими значеннями BGTR/IHRCR; в OTP — кінцеві слова.
  Вони пропускаються при blank check і verify.

---

## 5. Повний алгоритм хоста (`easypdkprog`)

### 5.1 Відкриття

1. Відкрити COM, виставити DTR, вичитати й відкинути вхідні дані.
2. `I` → перевірити PROTO 1.3.

### 5.2 `probe`

`P` → таблиця за правилами 4.6.

### 5.3 `read`

1. `R` (addr = 0, data_offs = 0, count = codewords, напруги `*_cmd_read` / `*_read_hv`).
2. Результат має дорівнювати `id12bit`.
3. `G` по шматках → файл (Intel HEX 8-біт: байтові адреси, слово = 2 байти LE, або raw binary).

### 5.4 `write`

1. Прочитати HEX у байтовий масив; невизначені байти = `0xFF` (з `--securefill` = `0x00`, тобто NOP,
   до `min(codewords - 8, exclude_code_start)`).
2. Якщо fuse не задано, а файл займає всю пам'ять — останнє слово стає fuse і видаляється з даних.
3. Пошук та підміна калібрувальних вставок (до 16, розділ 6).
4. Підстановка серійного номера (розділ 8).
5. FLASH (якщо не `--noerase`): `E` → результат = ID.
6. `Z` (якщо не `--noblankchk`) по всьому діапазону з урахуванням exclude.
7. `S` (дані з байта 0) → `W` (addr 0, data_offs 0, count = ⌈len/2⌉, параметри блоку з таблиці).
8. `V` (якщо не `--noverify`).
9. Для кожної калібровки, у порядку зростання адреси:
   `C` → перевірка, що частота в межах ±10 % від цільової → пропатчити код (розділ 6.4) → `S` всього
   масиву → `W` всього масиву (дописуються лише нулі).
10. Fuse (якщо є): `S` 2 байти за байтовим зміщенням `(codewords-1)*2` → `W` з
    `addr = data_offs = codewords-1`, `count = 1`.

### 5.5 `erase`

`E`, потім `Z`.

> ⚠️ У `easypdkprog` 1.3 в гілці `erase` blank check викликається з переплутаними аргументами
> (`vdd_read = vpp_cmd_read`, `vpp_read = vdd_read_hv`). Не копіюйте це.

### 5.6 `start`

`X` з `--runvdd` (типово 5.0 В) → цикл: друкувати `D`-пакети, натиснуті клавіші слати `D`-пакетами;
Esc → `Q`.

---

## 6. Калібрування осциляторів (IHRC / ILRC / BandGap)

PADAUK не мають заводського калібрування IHRC у програмі — його виконує програматор **після запису,
на робочій мікросхемі**. Для цього в прошивку користувача вбудовується «маркер», який хост замінює
спеціальним вимірювальним циклом, записує, вимірює, а потім перетворює цикл на просту установку регістра.

### 6.1 Маркер у програмі користувача (від SDCC-макросів `easypdk/pdkcommon.h`)

**IHRC/ILRC** — 10 інструкцій `AND A, #imm`:

```
and a, #'R'
and a, #'C'
and a, #type            ; 1 = IHRC, 2 = ILRC
and a, #freq[7:0]       ; цільова SYSCLK, Гц
and a, #freq[15:8]
and a, #freq[23:16]
and a, #freq[31:24]
and a, #mV[7:0]         ; VDD калібрування, мВ
and a, #mV[15:8]
and a, #reg             ; IO-адреса регістра підстроювання (IHRCR=0x0B, ILRCR=0x39 для PFS154 ...)
```

**BandGap** — 14 інструкцій:

```
and a, #'B' / 'G' / 3 / (3950 & 0xFF) / (3950 >> 8) / bgtr / gpcc / gpcs / 0 / 0 / 0 / 0 / 0 / 0
```

Опкод `AND A, #imm` залежить від розрядності ядра: 13 біт — `0x14xx`, 14 біт — `0x2Cxx`,
15 біт — `0x54xx`, 16 біт — `0x1Cxx` (для 16 біт калібрування не підтримується — хост видає помилку).

### 6.2 Вимірювальний цикл (що записується замість маркера)

**IHRC/ILRC** (на прикладі 14-бітного ядра; `pos` — адреса маркера):

| pos+ | Опкод | Інструкція | Після калібрування |
|---|---|---|---|
| 0 | `0x1ED1` | `SET1 PAC.3` — PA3 вихід | NOP |
| 1 | `0x1F0D` | `SET1 PADIER.4` — PA4 цифровий вхід | NOP |
| 2 | `0x2FFF` | `MOV A, #0xFF` | `MOV A, #value` |
| 3 | `0x2801` | `ADD A, #1` | NOP |
| 4 | `0x1ED0` | **loop:** `SET1 PA.3` | NOP |
| 5 | `0x0180\|reg` | `MOV IO(reg), A` — запис у IHRCR/ILRCR | **залишається** |
| 6 | `0x1910` | `T0SN PA.4` — пропустити наступну, якщо PA4 = 0 | NOP |
| 7 | `0x2801` | `ADD A, #1` | NOP |
| 8 | `0x1CD0` | `SET0 PA.3` | NOP |
| 9 | `0x3004+pos` | `GOTO loop` | NOP |

Тіло циклу — рівно **7 тактів** (5 однотактних + GOTO на 2), тому на PA3 мікросхема генерує меандр
`f_PA3 = SYSCLK / 7`. Кожного разу, коли під час `T0SN` на PA4 одиниця, A збільшується і в регістр
підстроювання пишеться наступне значення.

Таблиці опкодів для 13/14/15-бітних ядер — у [fpdkiccalib.c](../easy-pdk-programmer-software/fpdkiccalib.c);
хост їх сам підставляє, прошивці програматора про вміст коду знати не потрібно.

**BandGap**: PA0 і PA3 — виходи (`MOV A,#0x09; MOV PAC,A`), PA4 — вхід, вмикається компаратор
(`GPCC = 0x84`, `GPCS = 0xA3`), вихід компаратора йде на PA0; цикл аналогічний, але пише в BGTR.

### 6.3 Що робить програматор у команді `C`

1. Налаштувати лічильник (в оригіналі SPI1 **slave**): SCK ← IC PA3, MISO → IC PA4,
   кільцевий DMA на `block` байт TX і RX, MSB first, CPOL = 0, CPHA = 0. Кожен біт SPI = один оберт циклу IC.
2. VPP не подається. VDD = `vdd_mV`, чекати 1 мс — IC стартує і виконує записану програму, доходить до циклу.
3. **«Крок»** (`Next(n)`, n ≤ 16 за раз): у перші 2 байти TX-буфера записується `(1 << n) - 1`
   (байт0 = молодший), тобто n одиничних біт на PA4 → значення в регістрі зростає на n. Після передачі
   буфер знову нулі. Очікування підтвердження — до 1 с.
4. **Вимірювання частоти** (`Measure()`): робиться крок на 1, пропускається 1 блок, потім таймер
   48 МГц міряє час `t` проходження `M - 1` повних блоків:
   `f_PA3 = 48 000 000 × 8 × block × (M - 1) / t`, а `SYSCLK = f_PA3 × mult` (mult = 7).
   Розмір вікна залежить від цільової частоти:

   | Цільова SYSCLK | block, байт | M (блоків) |
   |---|---|---|
   | > 4 МГц | 16 | 24 |
   | ≤ 4 МГц | 16 | 8 |
   | ≤ 1 МГц | 16 | 4 |
   | ≤ 100 кГц | 4 | 2 |

5. Пошук:
   * **IHRC** — значення 1…0x9F з кроком 1 (значення 0 пропускається, бо перше вимірювання вже після
     першого кроку), вибирається найближче до цільової частоти;
   * **ILRC** — 0x00…0xF0 з кроком 0x10 (використовуються лише старші 4 біти);
   * **BG** — 0x00…0xF0 з кроком 0x10: після кожного кроку чекати 500 мкс і читати IC PA0;
     перше значення, при якому PA0 = 0, — результат. Не знайдено → `'E'`.
   * Якщо вимірювання повернуло 0 (немає тактів 1 с) — пошук зупиняється.
6. VDD = 0, зупинити лічильник, чекати 50 мс. Відповісти `value`, `freq`.

Реалізуючи на іншому МК, достатньо: (а) рахувати фронти на IC PA3 за відомий час (таймер у режимі
зовнішнього тактування / input capture), (б) уміти синхронно з фронтами PA3 видати рівно n одиниць на
PA4 (наприклад, по переривання від фронту PA3 — але частота PA3 до ~2.3 МГц при SYSCLK 16 МГц, тому
краще апаратно: SPI slave, таймер з DMA тощо).

### 6.4 Патч після калібрування (на хості)

* інструкції з позначкою `CO_AC_NOP` → `0x0000` (NOP);
* `MOV A, #0xFF` → `MOV A, #value`;
* `MOV IO(reg), A` залишається.

Усі ці зміни лише обнуляють біти, тому повторний `W` без стирання коректний. У результаті в програмі
лишається `MOV A,#value; MOV IHRCR,A` і NOP-и.

---

## 7. Режим виконання (UART-міст)

* `X`: VDD = `vdd_mV`, VPP = 0, UART 8N1 з **автовизначенням швидкості по старт-біту** (STM32 ABR mode 0):
  * IC TX → **PA7** → вхід програматора (з pull-down);
  * вихід програматора → **PA0** → IC RX.
* Перший символ від IC має мати молодший біт = 1 (прийнято слати `'U'` = 0x55); він вимірюється і
  відкидається (якщо це саме `'U'`).
* Після визначення програматор шле хосту `'D'`-пакет `"Connected @<baud> baud\n"`.
  При помилці автовизначення UART перезапускається.
* Далі всі байти від IC збираються в кільцеву чергу 32 байти і пересилаються `'D'`-пакетами.
* `'D'`-пакети від хоста передаються в IC на тій самій швидкості.
* `Q` або закриття порту — вимкнути UART і VDD.

---

## 8. Серійний номер

Хост шукає в коді 8 послідовних інструкцій `RET #'F'`, `RET #'P'`, `RET #'S'`, `RET #'E'`, `RET #'R'`,
`RET #'I'`, `RET #'A'`, `RET #'L'` (опкод `RET k`: 13 біт — `0x01xx`, 14/15 біт — `0x02xx`,
16 біт — `0x0Fxx`) і замінює молодші байти на байти 64-бітного серійного номера (`--serial`),
молодший байт — першим. Виконується повністю на хості, програматор не задіяний.

---

## 9. Таблиця мікросхем (з `fpdkicdata.c`)

Напруги у вольтах: `cmd` = (VDD / VPP) під час входу і команди, `hv` = (VDD / VPP) під час операції.
Блок запису = `block_size / clock_groups / clocks_per_group`. RO — запис у v1.3 не підтримується.

| IC | ID12 | Тип | addr / data біт | Слів | Read cmd → hv | Write cmd → hv | Блок | Erase cmd → hv, clocks | Exclude |
|---|---|---|---|---|---|---|---|---|---|
| PMS131 / PMC131 | 0xC83 | 0x22 | 12 / 14 | 0x600 | 3.0/5.0 → 3.0/5.0 | RO | — | — | 0x5F9–0x600 |
| PMS132 / PMS132B | 0x109 | 0x22 | 12 / 14 | 0x800 | 3.0/5.0 → 3.0/5.0 | RO | — | — | 0x7F6–0x800 |
| PMS133 / PMS134 | 0xC19 | 0x21 | 12 / 15 | 0x1000 | 3.0/5.0 → 3.0/5.0 | RO | — | — | 0xFF6–0x1000 |
| PMS150C / PMS15A | 0xA16 | 0x12 | 12 / 13 | 0x400 | 3.0/5.0 → 3.0/5.0 | 4.3/8.0 → 5.8/10.5 | 2/1/8 | — | 0x3F6–0x400 |
| PMS152 | 0xA27 | 0x22 | 12 / 14 | 0x500 | 3.0/5.0 → 3.0/5.0 | 4.3/8.0 → 5.8/10.5 | 2/1/8 | — | 0x4F6–0x500 |
| PMS154B / PMS154C | 0xE06 | 0x12 | 12 / 14 | 0x800 | 3.0/5.0 → 3.0/5.0 | 4.3/8.0 → 5.8/11.0 | 2/1/8 | — | адр. 0 + 0x7E8–0x800 |
| **PFS154** | 0xAA1 | 0xF1 | 13 / 14 | 0x800 | 2.5/5.5 → 2.5/5.5 | 2.5/5.5 → 5.8/8.5 | 4/1/8 | 2.5/5.5 → 3.0/9.0, 2 | 0x7E0–0x7F0 |
| PMS171B | 0xD36 | 0x22 | 12 / 14 | 0x600 | 3.0/5.0 → 3.0/5.0 | 4.3/8.0 → 5.8/10.5 | 2/1/8 | — | 0x5F6–0x600 |
| PFS172 | 0xCA6 | 0xF2 | 13 / 14 | 0x800 | 2.5/5.5 → 2.5/**0.0** | 2.5/5.5 → 5.3/**0.0** | 4/1/4 | 2.5/5.5 → 5.3/**0.0**, 14 | 0x7E0–0x7F0 |
| PFS173 | 0xEA2 | 0xF1 | 13 / 15 | 0xC00 | 2.5/5.5 → 2.5/5.5 | 2.5/6.5 → 5.8/9.0 | 4/1/8 | 2.5/5.5 → 3.0/9.0, 4 | 0xBE0–0xBF0 |
| PMC251 | 0x058 | 0x31 | 13 / 16 | 0x400 | 2.5/5.0 → 2.5/5.5 | RO | — | — | 0x3F9–0x400 |
| PMS271 / PMC271 | 0xA58 | 0x31 | 13 / 16 | 0x400 | 2.5/5.0 → 2.5/5.5 | RO | — | — | 0x3F9–0x400 |
| MCU390 | 0xC31 | 0x12 | 12 / 14 | 0x800 | 3.0/5.0 → 3.0/5.0 | RO | — | — | 0x700–0x800 |

Примітки:

* PFC154 (є в `docs/` даташит) у таблиці версії 1.3 **відсутній** — для нього потрібні параметри з
  новіших версій free-pdk або власне дослідження.
* Поле `otpid` (напр. 0x2AA1 для PFS154) — ID у нотації оригінального програматора PADAUK, в протоколі
  не використовується.

---

## 10. Приклад обміну (PFS154, читання)

```
PC → 'I' 00
   ← 'A' 2D 00 "FREE-PDK EASY PROG - HW:1.2 SW:1.3 PROTO:1.3\n"

PC → 'R' 1B
     A1 0A            icid = 0x0AA1
     F1               type = FLASH_1
     C4 09 00 00      vdd_cmd  = 2500 мВ
     7C 15 00 00      vpp_cmd  = 5500 мВ
     C4 09 00 00      vdd_read = 2500 мВ
     7C 15 00 00      vpp_read = 5500 мВ
     00 00            addr = 0
     0D               addr_bits = 13
     00 00            data_offs = 0
     0E               data_bits = 14
     00 08            count = 0x0800
   ← 'A' 02 00 A1 0A  (успіх, ID echo)

PC → 'G' 04 00 00 3F 00     (offset 0, 63 байти)
   ← 'A' 3F 00 <63 байти>
   ...
```

На лініях IC при цьому: PA3 = 0 → VPP 5.5 В → 100 мкс → VDD 2.5 В → 500 мкс → 32 біти `0xA5A5A5A6` по PA6 →
16 біт ACK (`xxxx 1010 1010 0001`) → для кожної адреси 13 біт адреси + 5 мкс + 14 біт даних + такт →
зняти VDD/VPP → 10 мс.

---

## 11. Відомі особливості й підводні камені оригінальної реалізації

1. Перевірка меж `S`/`G` у прошивці помилково множить розмір буфера на 2 — фактичний буфер 8192 байти;
   у своїй реалізації перевіряйте коректно.
2. `E` для OTP повертає `0xFFFF`, **не виходячи з режиму програмування** (VPP/VDD лишаються ввімкнені).
   Краще спочатку перевіряти тип, потім подавати напругу.
3. Хост для `W` використовує тайм-аут 1000 мс (як для читання), не 2000.
4. `Z`/`R`/`V`: хост шле байт 12 = `vdd_cmd >> 8` замість `vdd_read >> 8` (див. 2.4).
5. У verify `excl_first` порівнюється з абсолютною адресою, а діапазон exclude — з відносним індексом `p`.
6. Помилка/таймаут за час однієї операції у хоста = зависання процесу запису; операції мають бути
   атомарними на боці програматора і завжди закінчуватися `Leave()` (знімання напруг).
7. `FPDK_SetVDD/SetVPP` завжди повертають успіх — апаратного контролю напруг немає; при перевантаженні
   (неправильно вставлена мікросхема) захисту немає. Нова апаратура може додати контроль струму/напруги
   й повертати `0xFFFE`/`0xFFFD`.
