kolod/padauk-programmer/hardware/3d_models/cap_1206.step

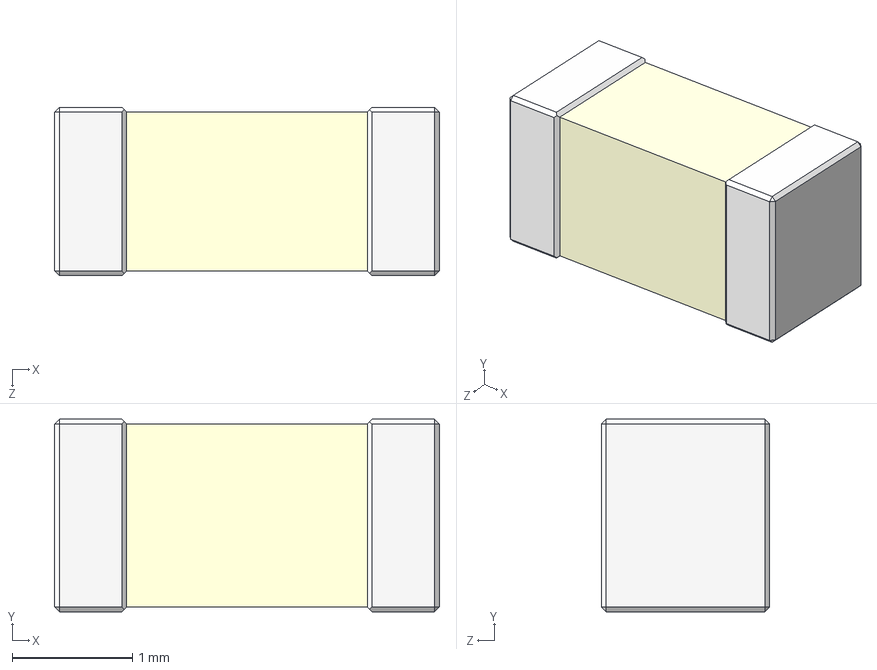
[picture p1: CAD file, 2026-10-29]
hardware/3d_models/cap_1206.step
3.20 x 1.60 x 1.40 mm
