kolod/padauk-programmer/hardware/3d_models/P100-E2x8.SLDPRT.STEP

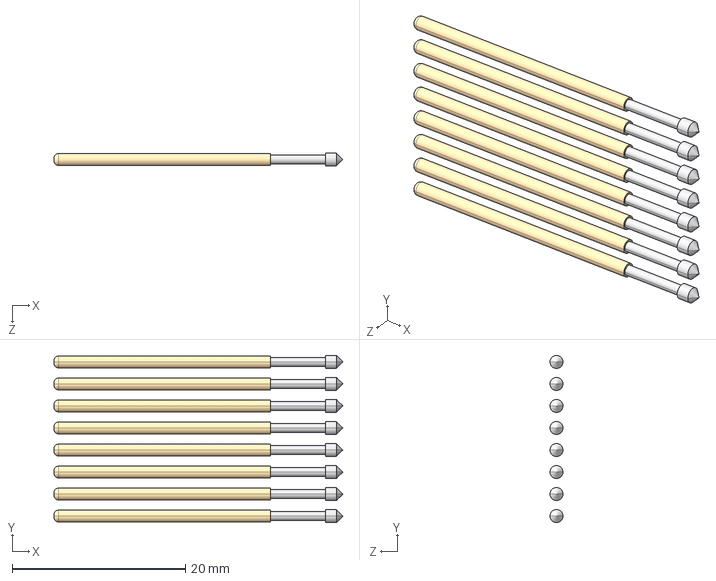
[picture p2: CAD file, 2026-10-29]
hardware/3d_models/P100-E2x8.SLDPRT.STEP
33.4 x 19.3 x 1.50 mm
P100-E2 x 8
