kolod/padauk-programmer/software/tests/vectors/examples/README.md

# Приклади free-pdk

Файли `*.ihx` скопійовано без змін з `easy-pdk-programmer-software/Examples/`
(Copyright (C) 2019-2020 freepdk, https://free-pdk.github.io, GPL-3.0-or-later).
Копія потрібна для того, щоб тести не залежали від субмодуля, який у цьому проєкті є лише референсом.

`gen_packages.py` будує з них пакети `ex_*` (одна вставка IHRC у кожному, крім `adctest_pfs173`). Ці
пакети використовують тести прошивки (немає хибних збігів вставок) і клієнта (побітово такий самий
пакет з HEX).
