kolod/padauk-programmer/docs/padauk-calibration.md

# Калібрування генераторів і BandGap мікросхем PADAUK

Документ описує, як працює калібрування мікросхем PADAUK у форматі free-pdk / Easy PDK, і як його
відтворює наш програматор. Джерела: `easy-pdk-programmer-software/fpdkiccalib.c` (шаблони вставок і
вимірювальних циклів), `easy-pdk-programmer-software/easypdkprog.c` (хід калібрування на PC),
`easy-pdk-programmer-software/Firmware/source/Src/fpdk.c` (вимір і пошук значення в прошивці
програматора), `easy-pdk-programmer-software/Examples/src/easypdk/pdkcommon.h` (макроси вставок),
даташит PFS154 (регістри компаратора). Ці файли — лише референс; код проєкту їх не використовує.

## 1. Що калібрується і навіщо

| Тип | Код | Що підлаштовується | Регістр | Чим перевіряється |
|---|---|---|---|---|
| IHRC | 1 | внутрішній RC-генератор ~16 МГц (і тактова, що з нього ділиться) | `IHRCR` | частота |
| ILRC | 2 | внутрішній низькочастотний RC-генератор (~55–95 кГц) | `ILRCR` | частота |
| BG | 3 | опорна напруга BandGap 1,20 В | `BGTR` | компаратор проти дільника VDD |

Заводське налаштування PADAUK робить сам фірмовий програматор (Writer) — у вільних інструментах
його немає. Тому free-pdk кладе в програму **вставку** — блок слів-заповнювачів, який програматор
перетворює на вимірювальний цикл, калібрує й замінює остаточним кодом `MOV A,#k; MOV IO(reg),A`.

## 2. Вставки в програмі

Програма отримує вставку макросами з `pdkcommon.h`:

```c
EASY_PDK_INIT_SYSCLOCK_8MHZ();               // спершу вибрати джерело й дільник тактової
EASY_PDK_CALIBRATE_IHRC(8000000, 4000);      // підлаштувати SYSCLK під 8 МГц при VDD = 4,0 В
EASY_PDK_CALIBRATE_ILRC(ILRC_FREQ, 4000);    // або ILRC
EASY_PDK_CALIBRATE_BG();                     // BandGap
```

Кожен макрос — це послідовність команд `AND A,#k`. Сама по собі вона безглузда (тому й безпечна як
заповнювач), а байти `k` несуть параметри калібрування:

**IHRC / ILRC** — 10 слів:

| Слово | `k` |
|---|---|
| 0 | `'R'` (0x52) |
| 1 | `'C'` (0x43) |
| 2 | тип: 1 — IHRC, 2 — ILRC |
| 3…6 | цільова частота SYSCLK, Гц, `u32` молодшим байтом уперед |
| 7…8 | VDD калібрування, мВ, `u16` |
| 9 | IO-адреса регістра (`IHRCR` або `ILRCR`) |

**BandGap** — 14 слів:

| Слово | `k` |
|---|---|
| 0 | `'B'` (0x42) |
| 1 | `'G'` (0x47) |
| 2 | 3 |
| 3…4 | VDD калібрування: завжди 3950 мВ |
| 5 | IO-адреса `BGTR` |
| 6 | IO-адреса `GPCC` (керування компаратором) |
| 7 | IO-адреса `GPCS` (вибір дільника компаратора) |
| 8…13 | 0 |

Опкод `AND A,#k` залежить від розрядності ядра:

| Ядро | Мікросхеми | `AND A,#k` |
|---|---|---|
| 13 біт | PMS150C, PMS15A | `0x14kk` |
| 14 біт | PMS152, PMS154B/C, PFS154, PMS171B, PFS172 | `0x2Ckk` |
| 15 біт | PMS133/134, PFS173 | `0x54kk` |
| 16 біт | PMC251, PMS271 | `0x1Ckk` (вставок для 16 біт free-pdk не має) |

Пошук вставки — порівняння зі шаблоном: перші два слова точні (`'R','C'` або `'B','G'`), решта —
будь-яке `AND A,#*` (у BG останні шість — саме `AND A,#0`). Шість і більше `AND A,#*` поспіль, що не
складаються в відому вставку, free-pdk вважає невідомою вставкою й відмовляється писати програму;
наш програматор у цьому разі повертає `PKG_CALIB_UNKNOWN` з адресою (`core/chips/calib_sites.c`).

## 3. Вимірювальний цикл IHRC / ILRC

Перед калібруванням програматор записує на місце вставки цикл. Розшифровка для 13-бітного ядра
(для 14 і 15 біт — ті самі команди з іншими опкодами, див. таблицю нижче):

```
pos+0  SET1  PAC.3          ; PA3 — вихід
pos+1  SET1  PADIER.4       ; PA4 — цифровий вхід
pos+2  MOV   A, 0xFF
pos+3  ADD   A, 1           ; A = 0 — стартове значення
loop:
pos+4  SET1  PA.3           ; PA3 = 1
pos+5  MOV   IO(reg), A     ; IHRCR/ILRCR = A
pos+6  T0SN  PA.4           ; PA4 = 0 → пропустити наступну команду
pos+7  ADD   A, 1           ; PA4 = 1 → A + 1
pos+8  SET0  PA.3           ; PA3 = 0
pos+9  GOTO  pos+4
```

- **PA3 — вихід частоти.** Прохід циклу займає рівно 7 тактів незалежно від PA4: пропуск у `T0SN`
  коштує 2 такти, а `ADD` — 1. PA3 тримається в 1 протягом 4 тактів і в 0 — 3 такти, тож
  `f_SYSCLK = 7 × f(PA3)` (`loopcycles = 7` у free-pdk).
- **PA4 — вхід «+1».** Раз за прохід мікросхема читає PA4; якщо там 1, значення `A` зростає на 1, і з
  наступного проходу генератор працює з новим налаштуванням. Імпульс має накрити рівно один момент
  опитування: при SYSCLK 8 МГц прохід триває 875 нс, тож імпульс мусить бути синхронним із PA3
  (див. розділ 6).
- **Цикл нескінченний.** PA4 не виводить мікросхему з циклу — лише змінює значення регістра. Цикл
  закінчується тим, що програматор знімає живлення й перезаписує вставку (розділ 7).

Опкоди циклу (`reg` — IO-адреса з вставки, `p` — адреса вставки):

| Слово | Команда | 13 біт | 14 біт | 15 біт |
|---|---|---|---|---|
| 0 | `SET1 PAC.3` | `0x0F71` | `0x1ED1` | `0x3D91` |
| 1 | `SET1 PADIER.4` | `0x0F8D` | `0x1F0D` | `0x3E0D` |
| 2 | `MOV A,0xFF` | `0x17FF` | `0x2FFF` | `0x57FF` |
| 3 | `ADD A,1` | `0x1001` | `0x2801` | `0x5001` |
| 4 | `SET1 PA.3` | `0x0F70` | `0x1ED0` | `0x3D90` |
| 5 | `MOV IO(reg),A` | `0x0080 \| reg` | `0x0180 \| reg` | `0x0100 \| reg` |
| 6 | `T0SN PA.4` | `0x0C90` | `0x1910` | `0x3210` |
| 7 | `ADD A,1` | `0x1001` | `0x2801` | `0x5001` |
| 8 | `SET0 PA.3` | `0x0E70` | `0x1CD0` | `0x3990` |
| 9 | `GOTO p+4` | `0x1804 + p` | `0x3004 + p` | `0x6004 + p` |

## 4. Вимірювальний цикл BandGap

```
pos+0   MOV   A, 0x09
pos+1   MOV   PAC, A          ; PA0 і PA3 — виходи
pos+2   SET1  PADIER.4        ; PA4 — цифровий вхід
pos+3   MOV   A, 0x84
pos+4   MOV   IO(gpcc), A     ; компаратор: увімкнено, (−) = BandGap 1,20 В, (+) = дільник VDD
pos+5   MOV   A, 0xA3
pos+6   MOV   IO(gpcs), A     ; вихід компаратора на PA0, «високий» діапазон, N = 3
pos+7   MOV   A, 0xFF
loop:
pos+8   SET1  PA.3
pos+9   MOV   IO(bgtr), A     ; BGTR = A
pos+10  T0SN  PA.4
pos+11  ADD   A, 1
pos+12  SET0  PA.3
pos+13  GOTO  pos+8
```

Розшифровка регістрів компаратора за даташитом PFS154:

- `GPCC = 0x84`: біт7 — увімкнути; біти 3…1 = `010` — мінусовий вхід = BandGap 1,20 В; біт0 = 0 —
  плюсовий вхід = внутрішній дільник `Vinternal R`.
- `GPCS = 0xA3`: біт7 — вихід компаратора на PA0; біт5 — «високий» діапазон дільника; біти 3…0 =
  N = 3. У цьому діапазоні `Vinternal R = VDD · (N + 9) / 40`, тобто при VDD = 3,95 В —
  3,95 · 12 / 40 ≈ 1,185 В.

Отже, цикл порівнює BandGap з ≈1,185 В, і результат видно на **PA0**. PA3 і PA4 працюють так само,
як у циклі IHRC: PA4 — «+1» до `BGTR`, PA3 — синхронізація.

Опкоди BG-циклу (14 біт; для 13 і 15 біт — аналогічно, див. `fpdkiccalib.c`): `0x2F09, 0x0191, 0x1F0D,
0x2F84, 0x0180|gpcc, 0x2FA3, 0x0180|gpcs, 0x2FFF, 0x1ED0, 0x0180|bgtr, 0x1910, 0x2801, 0x1CD0,
0x3008 + p`.

## 5. Хід калібрування

Так його веде Easy PDK (`easypdkprog.c`, `fpdk.c`); наш програматор повторює ту саму послідовність
усередині прошивки (специфікація `001-pc-programmer-protocol`, етап `CALIBRATE`).

1. **Запис.** Програма записується з усіма вставками, заміненими вимірювальними циклами.
2. **Вибір вставки.** Калібрується вставка з найменшою адресою серед ще не відкаліброваних.
3. **Запуск.** На мікросхему подається лише VDD калібрування з вставки (наприклад, 4,0 В; для BG —
   3,95 В), без VPP — мікросхема стартує з reset і виконує програму **як зазвичай**, доки не дійде до
   циклу. Код перед вставкою виконується з невідкаліброваним генератором.
4. **Пошук значення:**
   - **IHRC**: значення 0…0x9F крок за кроком: «+1», виміряти частоту, запам'ятати найближче до цілі
     (`f_SYSCLK = 7 · f(PA3)`). 0x9F — практичний максимум `IHRCR`.
   - **ILRC**: 0…0xF0 з кроком 0x10 (значущі лише старші 4 біти `ILRCR`): виміряти, далі 16 імпульсів
     «+1» до наступного кроку.
   - **BG**: 0…0xF0 з кроком 0x10: після кожного кроку зачекати 500 мкс і прочитати PA0; перше
     значення, при якому компаратор видає 0 (BandGap ≥ дільника), — результат.
5. **Перевірка.** Для IHRC/ILRC найкраща частота має бути в межах ±10 % від цілі, інакше
   калібрування невдале (у нас — `CALIB_FAILED`, політика FR-043).
6. **Завершення вставки** (розділ 7) і перезапис програми; VDD знімається.
7. **Наступна вставка**: мікросхема знову стартує, проходить уже завершену вставку й зупиняється в
   циклі наступної. Повторювати, доки не залишиться вставок.

Якщо за 1 с на PA3 немає сигналу (мікросхема не дійшла до циклу), вимір невдалий.

## 6. Вимір частоти і синхронні імпульси

### Як це робить Easy PDK (STM32F072)

SPI1 у режимі **slave**: PA3 мікросхеми — такт SPI (SCK, на PB3), PA4 мікросхеми — MISO
програматора (PB4). Режим `CPOL = 0, CPHA = 0`: біт змінюється по спаду PA3 і стабільний, коли
мікросхема опитує PA4 після фронту. SPI крутиться безперервно через DMA (блоки по 16 байт).

- **Частота**: TIM2 рахує системні такти 48 МГц, поки SPI приймає N блоків; частота PA3 =
  `48 МГц · 8 · розмір_блоку · (N − 1) / такти`. Вікно залежить від цілі: 24 блоки по 16 байт (понад
  4 МГц), 8 (до 4 МГц), 4 (до 1 МГц), 2 блоки по 4 байти (до 100 кГц).
- **Імпульси «+1»**: у буфер передавання записується `(1 << n) − 1` — n одиниць поспіль (n ≤ 16).
  Кожен біт SPI припадає рівно на один прохід циклу, тож регістр зростає рівно на n. Після цього
  один блок пропускається, поки генератор встановлюється.

### Як це робити на STM32G474 (наш програматор)

| Вивід мікросхеми | Пін G474 | Функція при калібруванні |
|---|---|---|
| PA3 | PB3 | SPI3_SCK (AF6) — такт slave, імпульси синхронізуються з циклом |
| PA3 (та сама лінія) | PA15 | TIM2_CH1 (AF1) — захоплення фронтів для виміру частоти |
| PA4 | PC11 | SPI3_MISO (AF6) — імпульси «+1» |
| PA0 | PB6 | GPIO, вхід — результат компаратора при BG (PB6 — FT_c, лише до 5,0 В; рекомендовано PA9, див. README G474, «Допустимі напруги») |

Лінія PA3 заводиться на два піни: один пін не може одночасно бути тактом SPI3 і входом захоплення
TIM2, а так вимір і імпульси йдуть паралельно, без перемикання альтернативних функцій. Під час
програмування PB3 — звичайний GPIO-вихід такту.

Вимір — **взаємний (reciprocal)**: TIM2 (32 біт) тактується від 170 МГц, CH1 захоплює фронти PA3 з
подільником входу ÷8 і невеликим цифровим фільтром; прошивка бере N = 64 захоплення (опитуванням або
DMA):

```
f(PA3) = 8 · (N − 1) · 170 МГц / (t_останнє − t_перше)
f_SYSCLK = 7 · f(PA3)
```

При SYSCLK 8 МГц (PA3 ≈ 1,14 МГц) 504 періоди займають ~0,44 мс ≈ 75 000 тактів таймера —
роздільність ~0,001 %, тож навіть 160 кроків IHRC проходять швидко. Перезахоплення (прапорець
`CC1OF`) означає, що сигнал швидший, ніж встигає прошивка, — тоді збільшити подільник.

Точність задає опорна частота МК — кварц HSE 8 МГц (±20 ppm). Якщо прошивка працює від
внутрішнього HSI16 (±1 %), калібрування частоти треба заборонити або явно попередити.

## 7. Завершення вставки

Після калібрування цикл перетворюється на остаточний код: усі слова → `NOP` (`0x0000`), крім двох:

| Вставка | Слово | Стає |
|---|---|---|
| IHRC/ILRC | 2 (`MOV A,0xFF`) | `MOV A,#k` — знайдене значення |
| IHRC/ILRC | 5 (`MOV IO(reg),A`) | лишається |
| BG | 7 (`MOV A,0xFF`) | `MOV A,#k` |
| BG | 9 (`MOV IO(bgtr),A`) | лишається |

```
; IHRC після калібрування
NOP
NOP
MOV  A, #k
NOP
NOP
MOV  IHRCR, A
NOP
NOP
NOP
NOP
```

Усі переходи «цикл → остаточний код» лише скидають біти (1 → 0): `NOP` = `0x0000`, а
`MOV A,0xFF` → `MOV A,#k` змінює тільки молодший байт з `0xFF`. Тому завершення можливе й на
**OTP**-мікросхемах: одна повна програма й один перезапис кожної вставки. Це ж дозволяє повторну
спробу після обриву живлення (FR-044) — наш програматор перевіряє, що на місці вставки цикл або вже
остаточний код, і дописує лише потрібні нулі.

## 8. Яка вставка зараз активна

Програматор не аналізує хід програми й не бачить, у якому циклі мікросхема. Easy PDK просто
**вважає**, що мікросхема виконує вставки в порядку їхніх адрес:

1. Програма записується з **усіма** вставками, вже заміненими на вимірювальні цикли. Записати циклом
   лише одну, а решту лишити заповнювачами, не можна: на OTP перехід «заповнювач → цикл» потребує
   бітів 0 → 1.
2. Калібрується вставка з найменшою адресою серед ще не відкаліброваних — програматор вважає, що
   мікросхема зараз стоїть саме в ній.
3. Вставку завершують, програму перезаписують, мікросхему перезапускають: вона проходить готову
   вставку й зупиняється в наступному циклі.

Типовий випадок — дві вставки підряд на початку `main`:

```c
EASY_PDK_INIT_SYSCLOCK_8MHZ();
EASY_PDK_CALIBRATE_IHRC(8000000, 4000);   // нижча адреса — калібрується першою
EASY_PDK_CALIBRATE_ILRC(ILRC_FREQ, 4000);
```

Послідовний код компілятор розкладає в тому ж порядку, тож порядок виконання збігається з порядком
адрес. Припущення ламається, коли вставки стоять у різних функціях, в умовних гілках або програма
спершу викликає функцію з вищою адресою. Тоді мікросхема, скажімо, стоїть у циклі ILRC, програматор
думає, що це IHRC, імпульси «+1» підлаштовують `ILRCR`, а знайдене значення записалося б не в ту вставку.

### Перевірки нашого програматора (FR-055)

Програматор перевіряє, що мікросхема виконує саме ту вставку, яку він калібрує:

1. **Правдоподібність частоти.** Цикл однаковий для IHRC і ILRC, а частоти різняться на два порядки:
   IHRC на 8 МГц дає на PA3 ≈ 1,14 МГц, ILRC ~95 кГц — ≈ 13,6 кГц. Перший вимір, до будь-якого
   імпульсу «+1», має лежати в межах від 1/4 до 4 очікуваної частоти циклу (`ціль / 7`). Межі широкі,
   бо стартове значення регістра далеке від налаштованого, але переплутати IHRC з ILRC вони не дають.
2. **Відгук на крок.** Під час підбору частота має змінюватися з кожним кроком значення в одному
   напрямку (з поправкою на шум виміру). Відсутність реакції або хаотична зміна означають, що імпульси
   потрапляють не в той цикл. Для BandGap програматор ще перевіряє, що PA0 веде мікросхема (вихід
   компаратора): він перемикає слабку підтяжку PA0 вгору й униз, і рівень не має за нею йти. У циклах
   RC PA0 — вхід мікросхеми.

Порушення будь-якої умови → код `CALIB_WRONG_SITE` (0x0415). Як і при `CALIB_FAILED` (FR-043), далі
нічого не записується, але примусове завершення найкращим значенням (`CALIB_FINALIZE_ON_FAIL`) тут не
діє: значення знайдене для чужої вставки, записувати його немає сенсу. Клієнт пояснює, що вставки
виконуються не в порядку адрес.

Обмеження: дві вставки одного типу з близькими цілями (наприклад, дві IHRC) ці перевірки не
розрізнять. Суворішу гарантію дав би вимірювальний цикл із міткою — два варіанти з різною
шпаруватістю PA3 (4/3 і 3/4 такти при тому ж періоді 7 тактів і тому ж остаточному коді), які таймер
розрізняє, захоплюючи обидва фронти. Цей варіант поки не прийнято: він відходить від шаблонів free-pdk.

## 9. Що треба знати автору програми

- **Порядок.** Вставки калібруються в порядку адрес, а мікросхема доходить до них у порядку
  виконання. Програма має виконувати вставки в тому ж порядку, що й адреси (зазвичай — на початку
  `main`, підряд). Інакше наш програматор зупиниться з `CALIB_WRONG_SITE` (розділ 8), а Easy PDK
  підлаштував би не той регістр.
- **Тактова до вставки.** `EASY_PDK_INIT_SYSCLOCK_*` має стояти **перед** `EASY_PDK_CALIBRATE_IHRC`:
  цикл міряє SYSCLK, а не IHRC напряму.
- **Код до вставки** виконується з невідкаліброваним генератором і має дійти до вставки швидко (за
  1 с) і не чекати зовнішніх подій.
- **Сторожовий таймер.** Цикл його не скидає. Якщо програма вмикає WDT до вставки, мікросхема
  перезапускатиметься посеред виміру.
- **Без калібрування** — просто не ставити макрос: тоді регістр лишається заводським (наш
  програматор попереджає, якщо в пакеті немає жодної вставки, FR-050).

## 10. Сліди калібрування в дампі (копіювання)

Прочитана з мікросхеми програма не містить вставок — лише остаточний код
`NOP, NOP, MOV A,#k, NOP, NOP, MOV IO(reg),A, NOP…` (або вимірювальний цикл, якщо калібрування не
завершилось). Наш програматор розпізнає такі сліди за адресою регістра з таблиці мікросхеми й при
`COPY` замінює їх стандартними вставками з визначеною ціллю (специфікація
`001-pc-programmer-protocol`, research R9; FR-051…FR-053).

## 11. Де це в коді проєкту

| Що | Де |
|---|---|
| Пошук вставок, `PKG_CALIB_UNKNOWN` | `software/firmware/core/chips/calib_sites.c` |
| IO-адреси `IHRCR`/`ILRCR`/`BGTR`/`GPCC`/`GPCS` по мікросхемах | `software/firmware/core/chips/chip_table.c` |
| Вимірювальний цикл, завершення вставки | ефективний образ і `PROGRAM` (задачі T081, T085) |
| Примітив виміру частоти рушія | `measure_freq` (задача T112) |
| Перевірка активної вставки (FR-055) | примітив `calibrate`, задачі T131–T133 |
| Розкладка пінів G474 | `software/firmware/platform/stm32g474/README.md` |
