kolod/padauk-programmer/software/firmware/core/proto/proto_defs.h

/* SPDX-License-Identifier: GPL-3.0-or-later */
/* Protocol constants — values are normative, see specs/001-pc-programmer-protocol/contracts/protocol.md. */
#ifndef PDK_PROTO_DEFS_H
#define PDK_PROTO_DEFS_H

#define PDK_PROTO_MAJOR 1
#define PDK_PROTO_MINOR 0

/* Frame types (§1) */
enum {
    PDK_FT_REQ = 0x01,
    PDK_FT_RSP = 0x02,
    PDK_FT_EVT = 0x03,
    PDK_FT_NAK = 0x04,
};

/* Commands (§4) */
enum {
    PDK_CMD_HELLO = 0x0001,
    PDK_CMD_GET_INFO = 0x0002,
    PDK_CMD_GET_STATUS = 0x0003,
    PDK_CMD_LIST_CHIPS = 0x0004,

    PDK_CMD_PKG_BEGIN = 0x0010,
    PDK_CMD_PKG_DATA = 0x0011,
    PDK_CMD_PKG_COMMIT = 0x0012,
    PDK_CMD_PKG_ABORT = 0x0013,
    PDK_CMD_PKG_INFO = 0x0014,
    PDK_CMD_PKG_READ = 0x0015,
    PDK_CMD_PKG_DELETE = 0x0016,
    PDK_CMD_PKG_CHECK = 0x0017,
    PDK_CMD_STATS_GET = 0x0018,
    PDK_CMD_STATS_RESET = 0x0019,
    PDK_CMD_CONFIG_GET = 0x001A,
    PDK_CMD_CONFIG_SET = 0x001B,

    PDK_CMD_OP_START = 0x0020,
    PDK_CMD_OP_CANCEL = 0x0021,
    PDK_CMD_OP_RESULT = 0x0022,
    PDK_CMD_RESULT_READ = 0x0023,
    PDK_CMD_UART_TX = 0x0030,

    /* programmer service */
    PDK_CMD_CAL_START = 0x0040,
    PDK_CMD_CAL_SET = 0x0041,
    PDK_CMD_CAL_CONFIRM = 0x0042,
    PDK_CMD_CAL_GET = 0x0043,
    PDK_CMD_CAL_CLEAR = 0x0044,
};

/* Events (§5) */
enum {
    PDK_EVT_PROGRESS = 0x8001,
    PDK_EVT_OP_DONE = 0x8002,
    PDK_EVT_OP_STARTED = 0x8003,
    PDK_EVT_UART_RX = 0x8004,
    PDK_EVT_UART_LINK = 0x8005,
    PDK_EVT_PKG_STATE = 0x8006,
};

/* Status codes (§6). Reserved: 0x020A, 0x0304. */
enum {
    PDK_OK = 0x0000,
    PDK_FRAME_ERROR = 0x0101,
    PDK_UNKNOWN_COMMAND = 0x0102,
    PDK_BAD_PAYLOAD = 0x0103,
    PDK_PROTO_VERSION = 0x0104,
    PDK_NO_SESSION = 0x0105,
    PDK_BUSY = 0x0106,
    PDK_NOT_ALLOWED_NOW = 0x0107,
    PDK_INTERNAL = 0x0108,

    PDK_PKG_CHIP_UNSUPPORTED = 0x0201,
    PDK_PKG_TOO_LARGE = 0x0202,
    PDK_PKG_HEADER_INVALID = 0x0203,
    PDK_PKG_OFFSET = 0x0204,
    PDK_PKG_CRC_MISMATCH = 0x0205,
    PDK_PKG_RESERVED_AREA = 0x0206,
    PDK_PKG_FUSE_CONFLICT = 0x0207,
    PDK_PKG_SECURITY_NOT_ALLOWED = 0x0208,
    PDK_PKG_CALIB_UNKNOWN = 0x0209,
    /* 0x020A reserved */
    PDK_PKG_CHIP_READ_ONLY = 0x020B,
    PDK_PKG_OTP_BLANK_CHECK_REQUIRED = 0x020C,

    PDK_STORE_EMPTY = 0x0301,
    PDK_STORE_CORRUPTED = 0x0302,
    PDK_STORE_WRITE_FAILED = 0x0303,
    /* 0x0304 reserved */

    PDK_CHIP_NOT_FOUND = 0x0401,
    PDK_CHIP_ID_MISMATCH = 0x0402,
    PDK_CHIP_NOT_BLANK = 0x0403,
    PDK_VERIFY_FAILED = 0x0404,
    PDK_CALIB_FAILED = 0x0405,
    PDK_CHIP_PROTECTED = 0x0406,
    PDK_VDD_FAULT = 0x0407,
    PDK_VPP_FAULT = 0x0408,
    PDK_OP_UNSUPPORTED = 0x0409,
    PDK_CANCELLED = 0x040A,
    PDK_HOST_DISCONNECTED = 0x040B,
    PDK_MASTER_NOT_REWRITABLE = 0x040C,
    PDK_MASTER_RESTORE_PENDING = 0x040D,
    PDK_MASTER_MODIFY_NOT_ALLOWED = 0x040E,
    PDK_PATCH_CONFLICT = 0x040F,
    PDK_PATCH_IMAGE_MISMATCH = 0x0410,
    PDK_SELFTEST_CHIP_PRESENT = 0x0411,
    PDK_SELFTEST_FAILED = 0x0412,
    PDK_CHIP_ALREADY_PROGRAMMED = 0x0413,
    PDK_COPY_MASTER_UNCALIBRATED = 0x0414,
    PDK_CALIB_WRONG_SITE = 0x0415,
};

/* Operation types (OP_START.op_type) */
enum {
    PDK_OP_PROBE = 0x01,
    PDK_OP_READ = 0x02,
    PDK_OP_ERASE = 0x03,
    PDK_OP_BLANK_CHECK = 0x04,
    PDK_OP_PROGRAM = 0x05,
    PDK_OP_VERIFY = 0x06,
    PDK_OP_COPY = 0x07,
    PDK_OP_RUN = 0x08,
    PDK_OP_RESTORE_MASTER = 0x09,
    PDK_OP_PATCH = 0x0A,
    PDK_OP_SELF_TEST = 0x0B,
};

/* Operation stages */
enum {
    PDK_STAGE_PKG_CHECK = 0x01,
    PDK_STAGE_ID = 0x02,
    PDK_STAGE_ERASE = 0x03,
    PDK_STAGE_BLANK_CHECK = 0x04,
    PDK_STAGE_WRITE = 0x05,
    PDK_STAGE_VERIFY = 0x06,
    PDK_STAGE_CALIBRATE = 0x07,
    PDK_STAGE_FUSE = 0x08,
    PDK_STAGE_READ = 0x09,
    PDK_STAGE_STORE = 0x0A,
    PDK_STAGE_RUN = 0x0B,
    PDK_STAGE_MEASURE = 0x0C,
    PDK_STAGE_RESTORE = 0x0D,
    PDK_STAGE_SELF_TEST = 0x0E,
    PDK_STAGE_FINAL_VERIFY = 0x0F,
};

/* RESULT.warnings bits */
enum {
    PDK_WARN_CALIB_VALUE_COPIED = 1u << 0,
    PDK_WARN_CALIB_SNAPPED = 1u << 1,
    PDK_WARN_MASTER_MODIFIED = 1u << 2,
    PDK_WARN_RESUMED = 1u << 3,
    PDK_WARN_CALIB_FORCED = 1u << 4,
    PDK_WARN_SERIAL_DUPLICATED = 1u << 5,
    PDK_WARN_CALIB_UNRECOGNIZED = 1u << 6,
};

/* RESULT.calib[].site_status (3 reserved) */
enum {
    PDK_SITE_OK = 0,
    PDK_SITE_FAILED = 1,
    PDK_SITE_FORCED = 2,
    PDK_SITE_COPIED = 4,
    PDK_SITE_MASTER_LOOP = 5,
};

/* STATUS.state, STATUS.flags, STATUS.selftest_state */
enum { PDK_STATE_IDLE = 0, PDK_STATE_UPLOAD = 1, PDK_STATE_OPERATION = 2, PDK_STATE_RUNNING = 3 };
enum { PDK_FLAG_MASTER_RESTORE_PENDING = 1u << 0, PDK_FLAG_LOCAL_START_BLOCKED = 1u << 1 };
enum {
    PDK_SELFTEST_NOT_RUN = 0,
    PDK_SELFTEST_RUNNING = 1,
    PDK_SELFTEST_PASSED = 2,
    PDK_SELFTEST_FAILED_STATE = 3,
    PDK_SELFTEST_CHIP_PRESENT_STATE = 4,
};

/* Package state (STATUS.pkg_state, PKG_INFO) */
enum { PDK_PKG_EMPTY = 0, PDK_PKG_VALID = 1, PDK_PKG_CORRUPTED = 2 };

/* INFO.capabilities bits */
enum {
    PDK_CAP_AUTONOMOUS = 1u << 0,
    PDK_CAP_CALIBRATE = 1u << 1,
    PDK_CAP_RUN_UART = 1u << 2,
    PDK_CAP_COPY = 1u << 3,
    PDK_CAP_MEASURE_POWER = 1u << 4,
    PDK_CAP_SELF_TEST = 1u << 5,
    PDK_CAP_PATCH = 1u << 6,
    PDK_CAP_SUPPLY_CAL = 1u << 7,
};

/* CHIP_DESC.ops bits */
enum { PDK_CHIP_OP_READ = 1u << 0, PDK_CHIP_OP_WRITE = 1u << 1, PDK_CHIP_OP_ERASE = 1u << 2, PDK_CHIP_OP_CALIBRATE = 1u << 3 };

#endif
