kolod/padauk-programmer/(commit log)

2026-10-11 feat(firmware): protocol core, package storage and host simulator
    COBS/CRC-32 framing, stop-and-wait session with response cache, command
    dispatcher, chip table ported from free-pdk, supply policy, package
    header/commit validation, calibration and serial placeholder search,
    A/B slots with a power-safe state journal, pdk-sim over TCP with flash
    and power fault injection.
2026-10-11 test(firmware): unit tests and shared test vectors
    Frame, package and free-pdk example vectors generated independently of
    the client; tests for framing, session, supply policy, package
    validation, placeholder search, journal and upload (incl. power loss at
    every flash operation).
2026-10-11 feat(firmware): STM32F072 bring-up platform
    Clocks, TinyUSB CDC (1209:0001), flash, CRC unit, DAC/ADC supply control
    for Easy PDK boards, SysTick/TIM2 time, LEDs and button, chip engine
    stub. Supplies are forced to 0 V first thing after reset.
2026-10-11 feat(client): padauk_prog library, pdkprog CLI and contract tests
    Framing, serial/TCP transports, stop-and-wait client, Intel HEX and
    package builder, upload/pkg/info/list commands; unit tests and contract
    tests against pdk-sim (frame corruption SC-001, power loss SC-007,
    duplicate seq, latency).
2026-10-11 feat(firmware): erase package slots and the spare journal page in the background
    Housekeeping erases one page per main-loop pass: the previous package
    after commit, a deleted package, an aborted upload and the spare journal
    page, so uploads write into clean pages and no command waits for an
    erase. The page holding the current journal record is never erased.
    HAL flash gains erase_start/erase_status and a platform-defined slot
    count (2..4); uploads pick a clean slot.
2026-10-11 feat(firmware): STM32F411 platform (WeAct Black Pill + W25Q64)
    96 MHz clocks, TinyUSB CDC on OTG FS without VBUS sensing, package
    slots and journal in the W25Q64 (4 x 16 KB slots, background sector
    erase with erase suspend), ADC entropy, LED/KEY UI. No VDD/VPP front end
    yet: limits are 0 V and INFO hides MEASURE_POWER.
    USB CDC, TinyUSB config and the chip engine stub move to
    platform/common; cmake/stm32_common.cmake fetches dependencies and
    builds STM32 images; Cortex-M4F toolchain file.
2026-10-11 perf(firmware): fast PKG_COMMIT on SPI flash
    Package validation reads the mask once and words in 128-word windows
    instead of two SPI transactions per word and pass. A background W25Q
    erase is suspended once per command and resumed by the main loop.
    On the F411 board the largest PKG_COMMIT drops from ~190 ms to ~38 ms.
2026-10-12 feat(firmware): platform flash write unit
    The flash geometry gains write_unit (2 on STM32F0, 8 on STM32G4 ECC
    flash where each double word is programmed once). Uploads are
    sequential, so slots hold back bytes that do not fill a unit and pad
    the last one with 0xFF before PKG_COMMIT. Tests run uploads with an
    8-byte unit and unaligned chunks, restart and power loss.
2026-10-12 feat(firmware): STM32G474 platform replaces STM32F411
    WeAct STM32G474 core board (CEU6): 170 MHz, USB FS from HSI48 + CRS,
    true RNG for serial numbers, CRC unit, LED PC6 / KEY PC13. Packages and
    the journal live in flash bank 2 (read-while-write, background erase),
    64-bit programming, ECC double errors cleared in NMI. VDD/VPP through
    DAC1/ADC1 on provisional pins behind PDK_G474_SUPPLIES (off until the
    front end exists). The F411 platform (no DAC) is removed.
2026-10-12 docs(firmware): pin READMEs for F072 and G474; G474 PA0 = VDD, PA1 = VPP
    Each platform README lists the pins in use, internal resources, LED
    states, clocks, flash layout and the build command. On the G474 the
    provisional ADC inputs are swapped: PA0 (ADC1_IN1) measures VDD/6,
    PA1 (ADC1_IN2) measures VPP/6.
2026-10-12 perf(firmware): no background erase while an upload runs
    The upload slot is clean already. On STM32G4 a program waits for a
    running erase, so every PKG_DATA/PKG_COMMIT waited ~22 ms; on the board
    the median PKG_COMMIT drops from 22.5 ms to 1.6 ms.
2026-10-12 feat(g474): +15 V and -2.5 V rails without dedicated ICs
    +15 V boost on TIM1_CH1 (PA8) regulated in hardware: COMP4 (PB0) against
    an internal DAC3 threshold clears the PWM; COMP1 (PB1, separate divider)
    against VREFINT trips TIM1 break (latched, COMP1 locked). -2.5 V diode
    charge pump on TIM16_CH1 (PB4), away from the analog pins. Soft start,
    rail check; a dead rail keeps VDD/VPP at 0 V and hides MEASURE_POWER.
    Only with PDK_G474_SUPPLIES. README: rails, gate circuit, layout notes.
2026-10-13 feat(g474): unbuffered DAC outputs for the VDD/VPP references
    The load is an op-amp input with a 240 k pull-down; only the unbuffered
    DAC reaches 0 V (buffered: about 0.2 V .. VDDA - 0.2 V, i.e. up to
    0.85 V on VPP). Its ~10-15 k output impedance and the 10 nF on the pin
    form the noise filter; the scale error is calibrated out.
2026-10-13 fix(sim): report a closed port before accepting the next client
    A client that reconnected at once was accepted inside hal_transport_read,
    so the session layer never saw the port close and kept the old session
    (an upload or a raised calibration survived the disconnect).
2026-10-13 feat: supply calibration with an external meter
    CAL_START raises VDD/VPP to 90 % of the rail limits, CAL_SET takes the
    voltages measured by the user and derives per-rail measurement and
    output scale (per mille, +-12.7 %), then applies exact 6 V / 12 V
    (clamped to 95 % of the limit) for checking; CAL_CONFIRM stores or
    discards. Coefficients live in the former reserved0 of the journal
    record (flag bit 15); all supply set points and measurements use them.
    Session loss, rejection or 5 min idle remove the voltages.
    pdkprog calibrate [--show|--reset]; INFO capability bit 7; pdk-sim
    --power-scale for tests.
2026-10-22 docs: PADAUK calibration in detail; G474 ICP wiring and pin voltage limits
    docs/padauk-calibration.md: free-pdk placeholders, the IHRC/ILRC and
    BandGap measuring loops decoded (PA3 = 7-cycle square wave, PA4 = +1),
    the Easy PDK flow, synchronous pulses over SPI slave, finalisation on
    OTP, how the active placeholder is (not) known.
    G474 README: J1/J2 mapping (PB3+PA15 for PA3, PC11 for PA4, PB5, PB6,
    PB7), frequency measurement on SPI3 + TIM2, and 5 V tolerance from
    DS12288: FT/FT_f to 5.5 V, PB6 is FT_c (5.0 V) - move PA0 to PA9.
2026-10-22 spec: FR-055 check that the chip runs the placeholder being calibrated
    The programmer calibrates placeholders in address order without seeing
    program flow. The first measurement must be within 1/4..4 of the
    expected loop frequency, the frequency must follow each step, and for
    BandGap PA0 must be driven by the chip; otherwise CALIB_WRONG_SITE
    (0x0415), nothing written, no forced finalisation. Status code in
    firmware and client; tasks T131-T133.
2026-10-29 hardware: add STM32G474 board DipTrace project
    Schematic, PCB, component/pattern libraries, Gerber and project
    archives, plus the STEP models the PCB references. SolidWorks native
    files are ignored; only STEP exports are tracked.
